joon722/AI-V2X-Cane/arduino/README.md

# Arduino Code Map

Arduino IDE에서 각 폴더를 열어 업로드합니다. 폴더 이름과 `.ino` 파일 이름이 같아야 Arduino 스케치로 인식됩니다.

## car_firmware / cane_firmware

차량·지팡이 노드 펌웨어를 버전별로 모아 둔 폴더입니다(예전 이름 `car_bt_debug`, `cane_bt_debug`).

- `car_firmware`: 차량 ESP32 `car_debug_V2`~`V5`, V5 차량 UWB(Portenta C33 + UWB Shield) `c33_uwb_bridge_V5.ino`
- `cane_firmware`: 지팡이 ESP32 `cane_debug_V2`~`V5`, V5 지팡이 UWB(Arduino Stella) `stella_uwb_responder_V5.ino`
- 한 폴더에 여러 버전이 있으므로, 쓸 `.ino` 하나를 같은 이름의 폴더에 넣어 엽니다(예: `car_debug_V5/car_debug_V5.ino`).
- V5 조립·보정 순서: `V5_BRINGUP_AND_CALIBRATION.md`

## 01_sender_gps_imu_espnow

송신기 ESP32용 코드입니다.

- GPS Neo-6M 데이터 수집
- ICM-20948 IMU 데이터 수집
- ESP-NOW로 수신기 ESP32에 `v2x_message_t` 패킷 송신
- 100ms 주기 송신

## 02_receiver_espnow_uart_actuator

수신기 ESP32용 코드입니다.

- ESP-NOW 패킷 수신
- 수신 데이터를 Jetson UART로 JSON 전달
- risk 값에 따라 진동모터/부저 기본 제어

## 03_sound_udp_receiver

Jetson 위험도 출력 이후 피드백 확인용 코드입니다.

- Wi-Fi 연결
- UDP 포트 `6001`에서 명령 수신
- 명령 예시: `{"risk":2}`
- risk 0: 전체 OFF
- risk 1: 약한 진동
- risk 2: 약한 진동 + 느린 부저
- risk 3: 강한 진동 + 3연속 부저

업로드 전 `config.example.h`를 복사해서 `config.h`를 만들고 Wi-Fi 정보를 입력해야 합니다.

## 99_legacy_originals

정리 전 원본 코드 보관 폴더입니다.

## 99_legacy_tests

초기 테스트 코드 보관 폴더입니다. 일부 파일은 한 파일에 송신기/수신기 코드가 같이 있어 그대로 업로드하면 안 될 수 있습니다.
