joon722/AI-V2X-Cane/docs/작업일지/강현준/2026-07-20_작업정리.md

# 2026-07-20 작업 정리

작성자: 강현준
날짜: 2026-07-20

## 오늘 진행한 작업

### 1. 3단계 — 실제 데이터와 테스트 데이터 출처 구분 (완료)

수집되는 데이터가 실제 장비에서 들어온 것인지 테스트용으로 생성한 것인지 구분되도록 출처 처리를 마무리했다.

### 2. 4단계 — cane / vehicle 최신 상태 저장 (완료)

cane과 vehicle 각각의 최신 상태를 저장하는 기능에 진입해서 완료했다.

### 3. 8단계 risk_level 전송 경로 선행 검증

시스템이 정상 동작하는지 먼저 확인하기 위해 순서를 앞당겨 8단계 전송 경로를 검증했다.

- 검증 결과: RSU/ESP32 방향으로 정상 전송 확인
- 주의: 현재 전송한 risk_level은 **계산된 값이 아니라 수동 입력값**이다. 6~7단계 수식이 정해진 뒤 실제 계산값으로 교체해야 한다.

## 다음 작업

5단계 — test vehicle 생성 및 거리 감소 확인

## 전체 진행 현황

| 단계 | 내용 | 상태 |
|---|---|---|
| 1 | UART/Serial 원본 JSON 정상화 | 완료 |
| 2 | Python 파싱 및 CSV 저장 | 완료 |
| 3 | 실제 데이터와 테스트 데이터 출처 구분 | 완료 |
| 4 | cane/vehicle 최신 상태 저장 | 완료 |
| 5 | test vehicle 생성 및 거리 감소 확인 | 다음 진행 |
| 6 | 거리, TTC, closing speed 계산 | 예정 (수식 미정) |
| 7 | risk score 및 risk_level 수식 적용 | 예정 (수식 미정) |
| 8 | risk_level RSU/ESP32 전송 | 경로 확인 완료, 값은 수동 입력 |
| 9 | 실제 차량 신호로 교체 | 예정 |

## 남은 이슈

- 6단계, 7단계 수식이 아직 정해지지 않음 → 이 두 개가 정해져야 8단계 값이 실제 계산값으로 바뀐다.
- 9단계 실제 차량 신호 교체 전까지는 test vehicle 기반으로 검증한다.
