joon722/AI-V2X-Cane/docs/인수인계/AI_V2X_연결구조_다이어그램_report.pptx

AI-V2X SMART CANE · 연결 구조 한눈에 보기

무엇이 · 어디로 · 어떻게 흘러가는가

하드웨어(RSU·지팡이·차량) · SUMO/AI · 서버(구글 클라우드)
세 세계가 어떻게 이어지는지 다이어그램으로 정리한 인수인계 자료

※ 서버/구글 클라우드 부분은 현재 미구현 — 향후 도입을 위한 제안 설계로 표기했습니다.

## Slide 2

가장 큰 그림 · 이 한 장이 핵심

세 살림을 두 개의 다리로 잇는다

클라우드 · 상시 켜둠 — 위험지도 서버 (FastAPI + SQLite + Leaflet, 이미 구현됨)

이벤트 누적 저장 (SQLite)

도로 구간별 누적 집계

웹 지도 홈페이지 (Leaflet)

이벤트 업로드
(POST /api/events)

SUMO 결과 업로드
(import_sumo_results.py)

현장 하드웨어 · 필요할 때 켬

RSU / Jetson + 지팡이·차량
실시간 위험 경고 (현장에서 즉시)
※ 꺼지면 → 차량↔지팡이
직접통신이 백업 경고

로컬 PC · 가끔

SUMO 시뮬레이션 + AI 학습
→ risk_transformer.onnx 생성
(무거운 계산은 여기서
배치로 한 번씩)

모델(.onnx)
이식 (가끔)

핵심 실시간 위험 판단은 현장에서 즉시(서버 왕복 안 함). 클라우드는 상시 켜두고 기록·지도만 담당. RSU가 꺼져도 직접통신이 백업하고, 지도는 그대로 조회된다.

2

## Slide 3

실시간 하드웨어 · 구성도

차량 · 지팡이 · RSU 가 이렇게 연결된다

차량 노드 (ESP32)

위치·속도·방향을 ESP-NOW로 방송

RSU 브리지 노드

Jetson Nano
distance·TTC·risk 계산

무선 ↔ USB Serial 중계 + 위험도 계산

GPS 모듈
(NEO-6M)

ESP32
(송수신)

DFPlayer
음성(선택)

ESP-NOW

risk 결과

RSU ESP32
무선 수신/송신

지팡이↔차량

지팡이↔RSU

지팡이 노드 (ESP32)

상태 방송 + 위험 경고 수신 → 진동·부저 출력

GPS / IMU

ESP32

진동모터

부저

─── 유선(UART/USB) - - - 무선(ESP-NOW) risk 결과 반환은 초록 경로

3

## Slide 4

실시간 하드웨어 · 데이터 흐름

정보가 한 바퀴 도는 순서

상태 방송

지팡이·차량이
위치·속도를
ESP-NOW로 방송

1

RSU 수집

RSU가 무선 수신
→ USB로 Jetson에
JSON 전달

2

Jetson 판단

거리·TTC·방향으로
risk_level 0~3
계산

3

RSU 중계

risk를 다시
ESP-NOW로 대상
단말에 전송

4

경보 출력

지팡이 진동·부저
(차량 알림은
선택)

5

두 개의 안전 경로 (이중화)
경로 A · 직접 통신 차량↔지팡이가 RSU 없이 바로 주고받아 1차 즉시 경고. (검증 완료)
경로 B · RSU 경유 RSU→Jetson이 정밀 판단으로 확정·보강. 한쪽이 놓쳐도 다른 쪽이 잡는다.

지금 실제로 도는 주력 경로
RSU(ESP32) → Jetson(lux 파이프라인) → 지팡이
위험도는 거리+TTC 규칙으로 즉시 산출. AI 예측·서버 연동은 확장 단계.

4

## Slide 5

RSU 집중 · 왕복 경로

RSU 노드 = 우편함(ESP32) + 두뇌(Jetson)

"RSU" 한 단어에 장치가 둘 — ESP32는 중계만, 판정·AI·max는 같은 박스 안 Jetson이 수행한다

▲ 상행 · 상태 수집

차량(06)
지팡이(09)

ESP-NOW

RSU ESP32(10)
중계만 (검증·통계)

USB JSON

Jetson ★ 두뇌
거리·TTC·AI·max·판정

▼ 하행 · 위험 경고

지팡이 → 진동
차량 → 알림

무슨 데이터를 올리나
type·node_id·lat·lng·speed·heading·node_risk·recv/lost/rssi (JSON 한 줄)

ESP-NOW

RSU ESP32(10)
대상별 분기(중계)

무슨 데이터를 내리나
{target_id: 대상, src_id: 위험차량, risk: 0~3} → 지팡이면 MSG_RISK_ALERT

USB

Jetson ★
판정 결과 {target_id, risk}

핵심 (정정)
RSU ESP32는 중계만, 판정·AI 추론·max는 같은 RSU 노드 안의 Jetson이 수행한다. 즉 위험도 계산의 본진은 현장이다.

5

## Slide 6

RSU 뒤 · Jetson 내부

위험도가 만들어지는 6단계 (lux 파이프라인)

STEP 3

parse_v2x

JSON 파싱
17컬럼 표준화

STEP 4

state_store

최신 상태 보관
쌍 준비 판정

STEP 5

sim_vehicle

(실차 전)
가짜 차량

STEP 6

kinematics

거리·접근속도
TTC·칼만필터

STEP 7

risk_scoring

점수+DCPA
→ risk 0~3

STEP 8

send_risk

RSU로 전송
→ 지팡이

parse → state → (sim) → kinematics → risk → send · 각 단계는 앞 단계의 출력을 입력으로 받는다

입력 (RSU가 준 것)
USB Serial JSON 한 줄 — 차량·지팡이의 위치·속도·방향·seq·통신품질

출력 (지팡이로 보낼 것)
risk_level 0~3 + 근거(reason). 신뢰 낮은 GPS면 경보 억제, 변화 시 즉시 전송.

6

## Slide 7

위험도 로직

거리와 TTC로 risk 0~3 이 정해진다

입력

· 거리 (distance)
· 접근속도
· TTC (충돌예상시간)
· 접근 방향
· DCPA (옆 스침)

판정 규칙

거리<3m 또는 TTC<2s
거리<6m 또는 TTC<4s
거리<12m 또는 TTC<6s
그 외 = 안전
+ DCPA로 오경보 억제

거리<3m / TTC<2s

RISK 3

거리<6m / TTC<4s

RISK 2

거리<12m / TTC<6s

RISK 1

그 외 (안전)

RISK 0

Fire-first (선-발화) 지팡이는 risk 2 이상이면 정밀 판단을 기다리지 않고 즉시 진동한다. 놓치는 것보다 한 번 더 울리는 쪽을 택한다. 최종은 final_risk = max(rule, AI예측, zone, fail-safe) — 가장 높은 위험을 채택.

7

## Slide 8

가장 헷갈리는 부분 풀기

SUMO 결과는 두 갈래로 나간다

① 학습 갈래
AI 학습 → risk_transformer.onnx

현장 (Jetson)
.onnx 탑재 → 실시간 위험 예측

SUMO 시뮬레이션
(로컬 PC)

결과가 아래 두
갈래로 쓰인다

학습용

모델 이식

위험도

② 지도 갈래
구간별 위험도 CSV
(lat·lng·risk·ttc)

※ 둘 다 파일/업로드 — 실시간 통신 아님

업로드

위험지도 서버
지도에 위험구간 표시 (import_sumo_results.py)

정리 SUMO 결과는 ① 학습→모델(.onnx)→현장(실시간 예측), ② 구간 위험도 CSV→위험지도 서버(지도 표시) 두 곳으로. 어느 쪽도 RSU와 실시간 통신하지 않는다.

8

## Slide 9

SUMO · AI 세계 안쪽

시뮬레이션이 AI 학습 데이터가 되기까지

① 학습 갈래 — 이 세로 흐름이 AI 모델을 만든다

실제 도로(OSM)에서 위험 상황을 대량 생성

1

SUMO 시뮬레이션

2

feature.csv (9컬럼)

위치·속도·거리·상대속도 등 원시 피처

3

run_scenario.py

시나리오별 위험도·이벤트 자동 처리(오케스트레이터)

4

event_result.csv (22컬럼)

zone·risk점수·등급·이벤트유형 라벨 부여

5

merge → labeled 데이터셋

모든 시나리오 통합 → 학습 입력 파일

6

train_transformer.py

Transformer 학습 → .pt + scaler.json

7

export_onnx.py

.pt → .onnx (엣지 경량 추론용, Jetson으로 이식)

② 지도 갈래 위 학습과 별개로, SUMO 구간별 위험도(lat·lng·risk·ttc)는 import_sumo_results.py로 위험지도 서버에 직접 업로드되어 지도에 초기 위험구간으로 표시된다.

9

## Slide 10

서버 · 구글 클라우드 (향후 · 제안)

이미 만든 위험지도 앱을 VM 한 대에 올린다

Google Compute Engine — VM 1대 (상시 켜둠)

이미 만든 han/map 앱을 이 서버 하나에 그대로 올림 (Firebase·BigQuery 같은 별도 서비스 없이 단순)

현장

RSU / Jetson
위험 이벤트 발생 시
HTTPS로 업로드

올리는 데이터
lat · lng · risk(0~3) · ttc · timestamp

인터넷

FastAPI (uvicorn)
API + 정적 웹 서빙

SQLite (risk.db)
이벤트 이력 저장

roads.py
OSM 도로 구간 스냅·집계

Leaflet 웹 (risk_map.html)
위험지도 화면

사용자 브라우저 — 위험지도 열람 (GET /api/risk-segments)

10

## Slide 11

서버 · 구글 클라우드 (향후 · 제안)

무슨 데이터를 · 어떻게 주고받나 (실제 API)

① 현장 → 서버 : 위험 이벤트 업로드

POST /api/events
{
"lat": 37.0000, "lng": 127.0000,
"risk": 3,
"ttc": 1.8,
"timestamp": "2026-07-25T14:03:22Z"
}

1

현장에서 전송

Jetson이 위험 이벤트를 HTTPS로 POST

FastAPI 수신·저장

SQLite(risk.db)에 한 줄 기록

2

② 서버 → 지도 : 도로 구간 집계 조회

GET /api/risk-segments
{
"points": [[37.00,127.00],[37.01,127.00]],
"grade": 2, "events": 5,
"avg": 2.4, "ttc": 1.2
}

3

도로 구간 스냅·집계

roads.py가 가까운 도로에 붙여 누적

4

지도가 조회

프론트가 GET으로 받아 도로 색칠

핵심 현장은 짧은 JSON만 올린다. 저장·집계·지도는 서버가 맡는다.

11

## Slide 12

서버 · 구글 클라우드 (향후 · 제안)

홈페이지(위험지도)는 어떻게 뜨나

① SQLite (risk.db)

누적된 위험 이벤트
(lat·lng·risk·ttc·시간)

무슨 데이터로 무슨 화면?
· 이벤트의 위치·등급·TTC를 도로 구간 단위로 누적
· 구간별 이벤트 수·평균 위험도·평균 TTC 자동 집계
· 실시간이 아니라 누적 통계 지도 (건물 아닌 실제 도로에 스냅)

② FastAPI + roads.py

도로 구간에 스냅해
구간별로 집계

③ Leaflet 지도

브라우저에서 도로를
색으로 표시

누적 위험 등급 (지도 색상)

예: 실험 지역 일대 도로 구간 클릭 → 누적 위험 통계 표시

0 · 안전

1 · 주의

2 · 위험

3 · 매우위험

12

## Slide 13

전체 통합

두 개의 다리로 이어지는 전체 그림

클라우드 · 상시 켜둠 — 위험지도 서버

Google Compute Engine VM 1대에 FastAPI + SQLite(risk.db) + roads.py + Leaflet 지도 · 이벤트 누적→도로 구간 집계→웹 지도

이벤트 업로드
(POST /api/events)

SUMO 결과 업로드
(import_sumo_results.py)

현장 하드웨어 (필요할 때 켬)

지팡이·차량 (ESP-NOW)

RSU 브리지

Jetson + .onnx 위험 예측

지팡이 진동·부저

모델(.onnx)
이식

로컬 PC (가끔)

SUMO 시뮬레이션

데이터셋 CSV

Transformer 학습

risk_transformer.onnx

세 살림은 두 개의 다리로만 이어진다 — ① 모델 파일(.onnx) 이식 (로컬→현장), ② 이벤트 로그 업로드 (현장·로컬→클라우드).

13

## Slide 14

정리 · 상태 구분

지금 되는 것 vs 앞으로 붙일 것

✔ 지금 실제로 동작 (검증 완료)
· ESP-NOW 송수신 · RSU 브리지 · Jetson 수신
· lux 파이프라인(parse→…→send) 1~8단계
· 거리·TTC 규칙 기반 실시간 risk 0~3
· Fire-first 즉시 경고 · DCPA 오경보 억제
· SUMO 데이터셋 → Transformer 학습 → ONNX

◷ 앞으로 붙일 것 (확장 · 제안)
· AI(.onnx) 추론을 실시간 파이프라인에 연결
· RSU(10)를 version 2 + distance로 정합
· 좌표계 통일(GPS 위경도 ↔ SUMO 미터)
· 구글 클라우드: API·DB·위험지도 홈페이지
· 9단계: 가짜 차량 → 실차 ESP32 교체

14

## Slide 15

한 장으로 남기는 결론

모델 파일과 이벤트 로그,
이 두 다리를 기억하면 전체가 보인다

SUMO·AI(오프라인) ──.onnx 모델──▶ 하드웨어(현장) ──이벤트 로그──▶ 구글 클라우드(서버·홈페이지)

※ 구글 클라우드 구성은 제안(향후) 설계입니다. 실제 도입 시 서비스 선택은 팀 결정에 따릅니다.
