joon722/AI-V2X-Cane/docs/미팅 내용/4.27 2차 미팅.pdf

한이음 공모전 하이퍼-슝

2026.4.27 | 2차 회의 | 작성자:강현준

오늘 프로젝트의 목표

1. ESP32 환경 설정 및 Blink
2. ICM-20948 IMU 센서 연결 및 검증
3. Neo-6M GPS 연결 및 야외 테스트

팀 역할 분담

강현준,박중선:하드웨어 기본 점검
최민서:SUMO 기본 설정 및 만들기 테스트

이번 팀 미팅에서 한 내용

강현준,박중선:ESP32 환경 설정 및 테스트,ICM 센서 연결 및 검증,Neo-6M GPS 연결 최민서:SUMO 기본 설정 및 만들기 테스트

다음 미팅 계획

https://gemini.google.com/share/fe4b8d04577d
하드웨어: 하드웨어 종합 조립의 시작
통신 시스템: ESP의 서로 통신이 가능하게 점검 및 시작 도로 시스템: SUMO를 이용한 밑작업 및 설정 계획 및 셋팅

다음 팀 모임 일정

5.3(일) 미팅

주의 사항

각장 본인의 역할에 대해서 자세하게 조사해서 오기
