joon722/AI-V2X-Cane/docs/미팅 내용/5.3일 3차 미팅.pdf

## 한이음 공모전 하이퍼-슝

2026.5.3 | 3차 회의 | 작성자:강현준

### 오늘 프로젝트의 목표

## 박중선:개별 테스트한 센서들을 ESP32 하나에 전부 물리적으로 연결하여 하나의 코드에 서 IMU+GPS 데이터가 동시에 나오는 것을 확인

### 강현준:ESP32 2대를 사용하여 ESP-NOW 1:1 통신을 성공 시킨다. 준비물

-생략

## 오늘 결과

박중선:하드웨어 간 연결 및 데이터가 나오는 것을 확인 하였다. 강현준:하드웨어 파트가 연결중 이므로 노말한 ESP끼리 연결을 확인

최민서:SUMO netedit 설치후 숭실대 입구 넣어서 차 돌아다니는 것 성공

## 특이사항

## 장소의 와이파이가 설치하는 것에 문제가 많아 이 부분에 이슈가 많음 그래서 미리 알고 깔아야함

### 다음 팀 모임 계획

5.9일
