joon722/AI-V2X-Cane/data/README.md

# data/ — 현장 실험 원본 기록

이 폴더는 **실제 도로에서 수집한 원본 로그**입니다. 가공하지 않은 raw 데이터라 그대로 보면 숫자 나열이지만,
**무엇을 담고 있고 무엇을 보여주는지**를 아래에 정리했습니다.

> 📊 **이 데이터로 만든 시각화 결과는 [docs/현장 결과](../docs/field-results.ko.md)에서 한눈에 볼 수 있습니다.**
> (실측 접근 타임라인 + 10만 건 거리–위험 분포)

---

## 파일 종류 (공통)

| 파일 | 내용 |
| --- | --- |
| `risk_tx_YYYYMMDD_HHMMSS.csv` | **Jetson이 그 순간 내린 판정 결과.** 거리·TTC·접근속도·위험등급·GPS 유효·모델 확률까지 한 행에. 위 결과 페이지 차트의 원본. |
| `raw_YYYYMMDD_HHMMSS.log` | RSU 브리지가 받은 **원본 시리얼 스트림**(JSON 라인). 지팡이·차량·UWB 패킷 원본. |
| `차량_값기록.csv` · `지팡이_값기록.csv` | 각 노드가 **자체 기록한 원본 값**(듀얼 시리얼 동시 수집). |

---

## 세션별 요약

| 폴더 | 날짜 | 세션 | 무엇을 했나 |
| --- | --- | ---: | --- |
| [`젯슨로그_20260801_03/`](젯슨로그_20260801_03/) | 8/1·8/3 | — | 초기 실험 기록 CSV 6개(`exp_8.1_1차실험`, `exp_8.3_방향성실험` 등). 세션 설명은 아직 없음. |
| [`젯슨로그_20260805/`](젯슨로그_20260805/) | 8/5 | 4 | raw 로그 10개, 판정 CSV 4개. 원본 로그만 있고 세션 설명은 아직 없음. |
| [`젯슨로그_20260808/`](젯슨로그_20260808/) | 8/8 | 3 | raw 로그 6개, 판정 CSV 3개. 원본 로그만 있고 세션 설명은 아직 없음. |
| [`젯슨로그_20260810/`](젯슨로그_20260810/) | 8/10 | — | raw 로그 1개. 원본 로그만 있고 세션 설명은 아직 없음. |
| [`field_20260812_13/`](field_20260812_13/) | 8/12–13 | 15 | 첫 야외 실험. GPS 오차(σ) 실측, 오경보 원인 분석 후 TTC 상한 도입, 판정 주기 5 Hz 확정. |
| [`젯슨로그_20260812/`](젯슨로그_20260812/) | 8/12 | — | raw 로그 19개. `field_20260812_13/`에 없던 나머지 원본. |
| [`젯슨로그_20260813/`](젯슨로그_20260813/) | 8/13 | — | raw 로그 9개. `field_20260812_13/`에 없던 나머지 원본. |
| [`젯슨로그_20260814/`](젯슨로그_20260814/) | 8/14 | 3 | raw 로그 7개, 판정 CSV 3개. 원본 로그만 있고 세션 설명은 아직 없음. |
| [`젯슨로그_20260817/`](젯슨로그_20260817/) | 8/17 | 12 | 촬영일 + 오후 정밀 실험. **이 결과 페이지의 히어로 접근 이벤트가 이 폴더의 12:22 세션.** 판정불가 원인(차량 GPS 모션무효·재획득 점프)을 찾아 게이트 패치. |
| [`젯슨로그_20260818/`](젯슨로그_20260818/) | 8/18 | 4 | 대본 기반 5구간 실험. 접근 3/3 정상 상승(L1→L2→L3), 도플러 클램프 도입. |
| [`젯슨로그_20260819/`](젯슨로그_20260819/) | 8/19 | 5 | **코너 테스트 2회 성공.** RSSI×GPS 방향 융합 도입, 사각지대 접근에서 RSU 융합이 GPS 공백을 메움. |
| [`젯슨로그_20260820/`](젯슨로그_20260820/) | 8/20 | 10 | GPS 공백 유지(GAP_HOLD) 다운링크, 지팡이 GPS 콜드스타트 특성 확인. |
| [`젯슨로그_20260822/`](젯슨로그_20260822/) | 8/22 | — | UWB(DWM3001CDK) 통합 시작. |
| [`젯슨로그_20260825/`](젯슨로그_20260825/) | 8/25 | 4 | **UWB 야외 첫 성공.** 지팡이 GPS가 안 잡힌 세션에서 UWB가 판정을 100 % 대신 살림. AI 12k 모델 재학습. |
| [`젯슨로그_20260826/`](젯슨로그_20260826/) | 8/26 | 2 | raw 로그 5개, 판정 CSV 2개. 원본 로그만 있고 세션 설명은 아직 없음. |
| [`젯슨로그_20260827/`](젯슨로그_20260827/) | 8/27 | 3 | raw 로그 13개, 판정 CSV 3개. 원본 로그만 있고 세션 설명은 아직 없음. |
| [`젯슨로그_20260919/`](젯슨로그_20260919/) | 9/19 | 1 | **입력 끊김·복구 통제 실험.** 차량 노드의 GPS 가림·전원 재시작·통신 가림과 접근 주행. 조작 시각 마커(`markers_*.csv`) 포함. 자세한 내용은 폴더 README. |
| [`듀얼시리얼기록/`](듀얼시리얼기록/) | 8/1~9/19 | 118 | **라벨된 시나리오 녹화 118종** — `10m접근1`, `0.3m정지`, `1m정지`처럼 거리·동작을 이름에 붙인 통제 실험. 노드 원본 값(듀얼 시리얼)이라 알고리즘 튜닝·검증용. 9/19 세션의 `*_raw.log`는 용량(최대 52 MB) 때문에 `.log.gz`로 압축해 올렸고, 같은 값이 `*_값기록.csv`에도 있습니다. |

> 세션 수 = 각 폴더의 `risk_tx_*.csv` 개수(= Jetson 판정 세션). 일부 폴더는 raw 로그·노드 기록만 있습니다. 내용이 없는 0바이트 로그 파일은 올리지 않았습니다.

---

## 다시 그리기

같은 CSV로 결과 페이지의 그림을 재생성할 수 있습니다:

```bash
python scripts/figures/make_figures.py
```

> ⚠️ 이 로그의 GPS 좌표는 실험 장소의 위치를 담고 있습니다. 개인 식별 정보는 없습니다.
