joon722/AI-V2X-Cane/docs/README.md

[← 프로젝트 개요](../README.ko.md)

# docs — 문서 아카이브

프로젝트의 기술 보고·설계 문서를 모아 둔 곳입니다. 코드가 아니라 **"왜·어떻게 이 프로젝트를 진행했는지"**의 기록입니다.

## 바로 보면 좋은 것

| 문서 | 내용 |
| --- | --- |
| 📊 [현장 결과 (field-results.ko.md)](field-results.ko.md) | **실측 데이터 시각화** — 접근 타임라인, 거리별 위험 분포 10만 건 |
| [SETUP.ko.md](SETUP.ko.md) | 펌웨어 업로드 순서·Wi-Fi 설정·핀맵 |
| [코드_검증_정리.md](코드_검증_정리.md) | 코드 검증 메모 |

## 기술 보고

- `위험채점표_Transformer모델_설명.pdf` — 위험 점수표와 Transformer 모델 설명
- `TTC_연구_논문.pdf` — 충돌예상시간(TTC) 임계값 연구
- `DCPA게이트_적용결과_공유.pdf` — DCPA 게이트 적용 결과
- `확장_위험점수체계.png` — 확장 위험 점수 체계도

## 구조 설명

| 폴더 | 내용 |
| --- | --- |
| [인수인계/](인수인계/) | 연결 구조 다이어그램 |

## 개발 설계 노트

| 폴더 | 내용 |
| --- | --- |
| [superpowers/](superpowers/) | 개발 당시 작성한 설계 스펙·계획 (위험 융합, step7 채점, step8 전송) |
| [images/](images/) | 실물 사진·현장 데모·결과 차트 |
