joon722/AI-V2X-Cane/data/field_20260812_13/README.md

# 야외 실측 데이터 (2026-08-12 저녁 ~ 08-13 오전)

야외 실험. 지팡이 고정 + RC 차량 왕복/접근. 젯슨(RSU 엔진 step8)이 기록한
판정 CSV(`risk_tx_*.csv`)와 원시 시리얼 로그(`raw_*.log.gz`, gzip).

- 8/12 = **수정 전** (TTC 상한 없음, "10m 이내 30점" 규칙으로 오경보 93%)
- 8/13 = **수정 후** (TTC 30초 상한 + 안전하한 2.0초 배포, 지팡이 RSU 수신 복구)

노드측 기록(지팡이/차량 UDP 텔레메트리)은 팀 GCS 버킷(`듀얼시리얼기록/`)에 별도 보관.

## 파일 형식

- `risk_tx_*.csv`: 판정 1행 = 1판정. `pc_time`은 유닉스 epoch(KST 벽시계와 일치).
  주요 컬럼: `effective_level`(송신 레벨), `rule_level`/`rule_reason`(규칙 판정,
  8/13부터 `ttc_capped` 등장), `distance_m`/`closing_mps`/`ttc_s`, `cane_node_risk`/
  `veh_node_risk`(노드가 방송한 최종위험 — 다운링크 반영 확인용), 양 노드 GPS 상태.
- `raw_*.log.gz`: `시각 RX/TX 원문` 형식. RX는 노드 업링크 JSON(위치·속도·heading_valid
  포함), TX는 젯슨 위험도 송신. 파일명 타임스탬프가 짝이 되는 CSV와 같음.

## 세션 목록

| 파일 (시각) | 내용 | 핵심 결과 |
|---|---|---|
| 8/12 19:32~22:18 (risk_tx 10개) | 수정 전 왕복/평행 실험 | 판정 3,570건 중 경보 82%, 그중 78%가 접근 없음(TTC 9999/30s+) — 오경보 원인 실측 |
| `..._203823` (20:38~21:14) | 수정 전 최대 세션 | 판정 1,082건/경보 1,004건(93%). 지팡이 다운링크 반영 90% |
| `..._213246` (21:32~22:05) | patch 펌웨어 세션 | 반영률 76% |
| `..._220647` (22:06~22:18) | patch2 펌웨어 세션 | **지팡이 반영률 1%** — patch2가 RSU 입력을 껐던 증거 |
| 8/13 `..._081033` (08:10~08:32) | 수정 후 실내외 검증 | 정지 근접(2~10m)에서 경보 억제(ttc_capped), 접근 시 1→2→3 에스컬레이션(08:15:33), 지팡이 반영률 75% 복구 |
| 8/13 `..._083827` (08:40~09:11) | 수정 후 현장 런 | 08:41~44 접근/이탈 정상 판정. **08:45~ 차량 GPS 모션 정지**(속도 0.02 고착) 및 09:04~ 지팡이 GPS 배회(상대 오프셋 10→20m) — GPS 병목 실측 |

## 재현/분석 참고

- 코드 기준 커밋: TTC 상한 `rsu@5d2648d`, 도플러 융합 `rsu@721548d` (이 저장소는 `rsu/v2x/` 하위 동일본)
- raw 로그를 파이프라인에 재생하면 판정을 재현할 수 있음. 단 **재생 시각 왜곡 주의**:
  pc_time 기반 속도 계산이 있으므로 원본 타임스탬프를 사용할 것.
- 분석 정리본: 팀 공유 문서 `실험정리_20260813.pdf` 참조.
