joon722/AI-V2X-Cane/data/젯슨로그_20260919/README.md

# 입력 끊김·복구 통제 실험 (2026-09-19 12:14~13:06)

차량 노드의 입력을 일부러 끊었다 되살리면서, 복구 직후 판정 파이프라인이 어떻게 반응하는지 기록한 세션입니다.
노드 두 대는 5 m 간격으로 고정했고, 조작은 차량 노드에만 했습니다. 지팡이 노드는 비교 기준으로 그대로 두었습니다.

## 파일

| 파일 | 내용 | SHA-256 |
| --- | --- | --- |
| `raw_20260919_095416.log` | 젯슨(RSU 엔진 step8)이 받은 원본 시리얼 스트림. 기록은 09:54에 시작했고 실험 구간은 12:14~13:06 | `197a2e9c…685d96` |
| `risk_tx_20260919_095416.csv` | 같은 세션의 실시간 판정 결과 | `2c86eaa0…f34460` |
| `markers_20260919_121439.csv` | 실험자가 조작 순간마다 노트북에 남긴 시각 표시(`epoch, local_time, label`) | `59bd02b7…4dbfc` |

노드 쪽 원본 값(위성 수, HDOP, 원시 좌표, IMU 포함)은 같은 시간대에 따로 녹화되어
[`../듀얼시리얼기록/20260919_S01_RSU_RAW_CONTINUOUS_2H.log_2026-09-19_12-21-12/`](../듀얼시리얼기록/20260919_S01_RSU_RAW_CONTINUOUS_2H.log_2026-09-19_12-21-12/)에 있습니다.
원본은 팀 GCS 버킷(`듀얼시리얼기록/`)에도 있습니다.

## 시계

- 젯슨 시계는 정확했습니다(`raw` 로그의 epoch = KST 벽시계).
- 마커는 **노트북** 시계로 찍었습니다. 로그의 사건(전원 재시작 때 차량 노드의 millis가 0으로 돌아가는 시각, 통신 가림 때 RSSI가 꺾이는 시각)과 맞춰 보면 마커는 약 1초 늦게 찍혔습니다(중앙값 +1.0~1.3초, 누르는 반응 지연 포함). 현장에서 잰 "약 4초"는 두 명령을 차례로 실행하면서 생긴 측정 오차였습니다.
- 노드 시리얼 기록(`../듀얼시리얼기록/20260919_…`)은 노드 millis(`시각ms`)가 raw 로그 패킷의 `tx_ms`와 같은 카운터라서 수 ms 오차로 정확히 맞출 수 있습니다.

## 실험 구간과 마커

| 시각(노트북) | 블록 | 마커 | 한 일 |
| --- | --- | --- | --- |
| 12:15~12:22 | 정지 기준 | `> n A시작`, `n A끝` | 5 m 간격으로 7분 방치. 첫 줄의 `>`는 입력 실수 |
| 12:24~12:30 | GPS 가림 | `gs v` → `ge` | 차량 GPS 안테나에 알루미늄 원통+호일을 씌웠다 벗김. 5·20·60초 |
| 12:31~12:39 | 전원 재시작 | `rs v`, `re` | 차량 노드 전원을 뽑았다 꽂음, 6회. 로그상 차량 노드는 매번 28~31초 동안 사라졌다가 `seq=0`으로 돌아옴 |
| 12:41~12:44 | 통신 가림 | `cs v` → `ce` | 차량 노드 몸체(ESP32)를 호일로 감쌈. 5·20초 |
| 12:57~13:03 | 접근 주행 | `n 1`, `n 2`, `x` | 차량이 지팡이 옆을 지나감. `x` = 가장 가까이 지나간 순간 |

## 해석할 때 주의할 점

- **GPS 가림으로 유효 플래그는 떨어지지 않았습니다.** 좌표와 보고 속도는 흔들렸지만 `gps_valid`는 계속 1이었습니다. "끊김"이 아니라 "플래그에 안 잡히는 열화" 사건으로 다뤄야 합니다.
  - 12:24:19와 12:24:25의 `gs v`는 중복 입력입니다. 앞의 것은 무시합니다.
  - 12:28:36의 `gs v`에는 짝이 되는 `ge`가 없습니다.
- **통신 가림으로 링크는 끊기지 않았습니다.** 6회 모두 수신이 초당 6.2~8.9개로 유지됐고(직전 7.7~9.5개), RSSI만 1~17 dB 낮아졌습니다. 최대 수신 공백은 0.62초였습니다.
- **전원 재시작의 마커 순서가 안내와 반대입니다.** `rs v`는 전원을 **꽂은** 순간에, `re`는 꽂은 뒤 약 60초 휴지가 끝난 순간에 찍었습니다. 로그에서 차량 노드는 매번 28~31초 동안 사라졌다가 `seq=0`으로 돌아옵니다. 꺼진 시각과 켜진 시각은 마커보다 로그의 수신 공백을 기준으로 보는 것이 정확합니다.
- **접근 주행의 `n 1`/`n 2` 구분**
  - 로그상 9회 어느 회차에서도 차량 노드 재부팅은 없었습니다(최대 수신 공백 0.93초, 순번 초기화 없음).
  - `n 2` 다섯 번 중 두 번은 출발 직전에 차량 GPS 무효가 1~2초 있었고, 나머지 세 번은 로그에 흔적이 없습니다. `n 2`가 무엇을 뜻하는지는 실험자 확인이 필요합니다.
  - 이 구간에는 지팡이 노드 수신이 매우 나빴습니다(초당 0.3~2.7개, 최대 11초 공백).
  - `x`는 로그상 최근접 시각과 −9~+9.5초 차이가 나서 시각 동기화 기준으로 쓰지 않습니다.
- 13:04:40과 13:05:14의 `n`은 마무리 단계(두 노드를 나란히 두기)의 표시입니다.
