joon722/AI-V2X-Cane/docs/작업일지/README.md

# 작업일지

팀원별로 폴더를 나눠서 각자 진행한 작업을 날짜별로 기록합니다.

```text
docs/작업일지/
├── 강현준/
├── 최민서/
└── 박중선/
```

파일 이름 규칙: `YYYY-MM-DD_작업정리.md`
