joon722/AI-V2X-Cane/docs/작업일지/강현준/README.md

# 강현준 작업일지

이 폴더에 본인이 진행한 작업을 날짜별로 기록합니다.

## 파일 이름 규칙

```text
YYYY-MM-DD_작업정리.md
```

예: `2026-07-20_작업정리.md`

## 작성 항목

- 오늘 진행한 작업
- 다음 작업
- 전체 진행 현황
- 남은 이슈
