joon722/AI-V2X-Cane/AI_Model/transformer/models_v5/training_report_v3.txt

target: risk_level_future3 (3s lookahead)
features(20)
train 329,455 / test 75,341 (scenario split 45)

              precision    recall  f1-score   support

         안전0     0.9728    0.8268    0.8939     60000
         주의1     0.4672    0.6095    0.5290      9874
         경고2     0.3280    0.5788    0.4187      4065
         위험3     0.2645    0.8103    0.3988      1402

    accuracy                         0.7846     75341
   macro avg     0.5081    0.7063    0.5601     75341
weighted avg     0.8586    0.7846    0.8112     75341

[[49606  6185  2630  1579]
 [ 1186  6018  1958   712]
 [  180   664  2353   868]
 [   20    13   233  1136]]
ONNX diff 2.38e-06
