joon722/AI-V2X-Cane/docs/작업일지/최민서/2026-07-20_작업정리.md

# 2026-07-20 작업 정리

작성자: 최민서
날짜: 2026-07-20

## 오늘 할 일

- [x] 여러 위험 시나리오 생성 (현재 시나리오 부족)
- [ ] 자동화 스크립트 구성

자동화 스크립트 파이프라인:

```text
SUMO
  -> feature 생성      [완료]
  -> Risk 계산
  -> Event 분석
  -> 저장
```

## 남은 일

| 항목 | 상태 |
|---|---|
| 1. 위험 데이터 자동 누적 | 60% 진행 |
| 2. XGBoost 학습 데이터 제작 | 시작 전 |
| 3. XGBoost 모델 학습 | 시작 전 |
| 4. Transformer 적용 | 시작 전 |
| 5. ESP32 연동 | 시작 전 |

## 메모

- 현재 시나리오 수가 부족해서 위험 시나리오를 추가 생성하는 것이 선행 과제다.
- 자동화 스크립트는 feature 생성까지 진행됐고, Risk 계산부터가 남았다.
