joon722/AI-V2X-Cane/rsu/v2x/03_jetson/ttc_study/ROADSIDE_ALARM.md

# 도로변 경보 — 인도를 걸을 때 울리는 문제

작성 2026-08-07 · 8/9 논의 자료 · 근거 재현: `floor_dcpa_sweep.py`

## 0. 한 장 요약

팀 대화에서 나온 질문: **"인도를 걷는데 옆 차도로 차가 지나가면 울리나?"**

답: **울린다. 횡방향으로 7m 떨어져 있어도 최고 레벨이 나간다.**

| 확인한 것 | 결과 |
|---|---|
| 인도 보행 중 통과 차량 | 이격 3·5·7m 모두 레벨 3 (안전 하한 발동) |
| 하한을 DCPA 조건부로 (R=6m) | 오경보 −1.0%p, **놓침 3.8개 증가** (σ=2.5 기준) |
| 같은 변경, GPS σ만 1.5m로 | **놓침 0.4개**로 떨어짐 |
| GPS만 개선했을 때 | 적시경보 73.2% → 88.2% (**+15%p**) |
| GPS가 오경보에 미치는 영향 | **없음** (3.42 / 3.43 / 3.42 / 3.41%) |

**결론 두 줄.**
놓침은 GPS가 지배하고, 오경보는 판정 구조가 지배한다. 두 문제는 별개이며
서로의 해법으로 풀리지 않는다.

같은 날 함께 확인한 것들.

| 질문 | 답 | 절 |
|---|---|---|
| AI 이득이 GPS에 의존하는가 | **의존한다.** +18.9 → +14.9 → +9.5%p. 다만 사라지지 않고 승률은 오름 | 10 |
| 상용화·소형화가 가능한가 | 연산·배터리는 문제없다. **진짜 제약은 GPS 안테나 크기** | 11 |
| 위험지도에 문제가 있는가 | **있다.** 초록이 없는 것은 증상이고, 진짜 문제는 **변별력**이다 | 12 |
| 그 지도는 무엇인가 | 차량용도 보행자용도 아닌 **상충 지도** — 행정 의사결정 지원 | 12 |

---

## 1. 무엇을 묻게 되었나

위험지도를 보던 중 팀에서 나온 질문들이다.

> 안전한 구간은 어디 있는 건가요 / 차도는 다 위험하지
> 보행자가 보차 혼용도로 갈 때는?
> 인도랑 차도가 완전히 분리되어 있으면 굳이 울릴 필요는 없잖아
> 처음 생각한 건 차도로 안 들어가게 하자였는데 솔직히 잘 모르겠어

두 개의 다른 문제가 섞여 있었다.

| | 문제 | 소관 |
|---|---|---|
| A | 위험지도에 안전(0단계) 구간이 안 보인다 | 지도 — 별개 문제 |
| B | **인도 보행 중 통과 차량에 경보가 나가는가** | 실시간 경보 — 이 문서 |

이 문서는 B만 다룬다. A는 "이 지도가 차량용인가 보행자용인가"를 먼저 정해야
하는 문제이고, 8/9에 지도 담당과 따로 논의한다.

### 보호 대상 우선순위 (8/7 확인)

1. **충돌 경보** — 특히 운전자가 보지 못하는 곳에서 갑자기 나오는 상황
2. 횡단보도·보차혼용 구간
3. ~~차도 이탈 방지~~ — 시각장애인은 훈련되어 있고 단차가 있어 우선순위 낮음

1번이 핵심이라는 점이 설계 방향을 바꾼다. 시야가 트인 곳은 운전자가 알아서
피하므로, V2X가 유일하게 값을 하는 자리는 **서로 못 보는 상황**이다.

---

## 2. 진단 — 실제로 울리는지 계산했다

보행자가 북쪽으로 1.2 m/s, 차량이 옆 차도를 같은 방향 40 km/h로 뒤에서 접근하는
상황을 `step7_risk.assess_risk`에 그대로 넣었다.

| 횡방향 이격 | 뒤 20 m | 뒤 15 m | 뒤 10 m |
|---|---|---|---|
| 3 m (좁은 인도) | 레벨 2 | **레벨 3** | **레벨 3** |
| 5 m | 레벨 1 | **레벨 3** | **레벨 3** |
| 7 m (넓은 인도+갓길) | 레벨 0 | **레벨 3** | **레벨 3** |

이격 7m에서 점수는 19.3점(레벨 0 상당)인데 레벨 3이 나간다.

### 왜 그런가

원인이 둘이다.

**첫째, TTC를 잘못된 자리에 쓰고 있다.**

    TTC = 거리 / LOS 접근속도

이 값은 **정면 충돌 코스를 가정한 지표**다. 옆으로 스쳐 갈 차에도 작게 나온다.
실제 충돌 여부를 재는 것은 TTC가 아니라 DCPA(얼마나 가까이 스치나)와
TCPA(언제)의 쌍이고, step6이 그것을 이미 정확히 계산한다.

**둘째, 안전 하한이 DCPA 게이트를 의도적으로 무시한다** (`step7_risk.py:198`).

그 결정에는 근거가 있었다 — "게이트는 스쳐 갈 차를 걸러내는 장치인데 그 판단
자체가 추정이고, 접촉까지 2초도 남지 않았을 때 추정이 틀리면 대가가 너무 크다."
논리는 타당하다. 다만 그 대가를 **차 한 대가 지나갈 때마다 약 2초씩 최고 경보**로
치르고 있다는 점이 그때는 보이지 않았다.

**결과적으로 이격 거리를 정확히 알아도 소용이 없다.** 3m든 7m든 하한이 모두
덮어버리기 때문이다. 그래서 첫 검토 대상은 지도 정교화가 아니라 하한 자체였다.

---

## 3. 무엇을 쟀나

하한 발동 조건을 바꿨을 때의 손익을 오라클로 측정했다.

    현재:   경보 = (점수표레벨 >= 2)  OR  (TTC <= 2.0)
    조건화: 경보 = (점수표레벨 >= 2)  OR  (TTC <= 2.0 AND dcpa < R)

R을 2~8m로 스윕하고, GPS σ를 2.5 / 2.0 / 1.5 / 1.0m로 바꿔가며 반복했다.
채점은 `ttc_study`의 오라클 그대로다 — 규칙과 독립인 정답이므로 순환 논리가
되지 않는다.

지표를 셋 본다.

| 지표 | 무엇을 답하나 |
|---|---|
| 적시경보율 | 위험 시나리오에서 반응 가능할 만큼 미리 울렸나 |
| 오경보율 | 안전한 시점에 울렸나 |
| **확실안전 구간 경보율** | 3초 안에 4m보다 가까워지지 않는 시점에 울렸나 |

세 번째는 이번에 추가한 지표다. **인도 옆을 스쳐 가는 차가 여기 해당하므로,
팀이 걱정한 오경보에 가장 가깝다.**

    python floor_dcpa_sweep.py --n-scenarios 1200 --repeats 5 --gps-sigma-m 2.5

---

## 4. 결과 1 — 조건화는 공짜가 아니다 (σ = 2.5m)

| R (m) | 적시경보 | 오경보율 | 확실안전 경보 | 검출 |
|---|---|---|---|---|
| **무한 (현재)** | 73.2% ±4.1 | 3.42% | 2.79% | 94.6 / 97.2 |
| 8 | 72.8% (−0.4%p) | 2.74% | 2.12% | 93.2 |
| **6** | 71.5% (−1.7%p) | 2.40% | 1.83% | 90.8 |
| 5 | 69.9% (−3.3%p) | 2.21% | 1.68% | 88.8 |
| 4 이하 | 69.7% (−3.5%p) | 2.18% | 1.65% | 88.4 |

R=6이면 오경보를 30% 줄이는 대신 **위험 시나리오를 3.8개 더 놓친다.**
시각장애인 안전 시스템에서 놓침 1개와 오경보 1%는 값이 다르므로, 이 교환은
그 자체로는 손해다.

부수적으로 확인된 것 둘.

- **R을 2~4 사이에서 조정하는 것은 의미가 없다.** 네 값의 결과가 소수점까지
  같다. 하한이 추가로 잡는 시점들의 DCPA가 그 구간에 없다는 뜻이다.
- **하한만 고쳐도 인도 오경보의 절반만 사라진다.** 확실안전 경보가 2.79%에서
  1.83%로 줄 뿐 0이 되지 않는다. 남은 1.83%는 점수표가 내는 것이다.

---

## 5. 결과 2 — GPS 정밀도가 이 교환의 조건을 바꾼다

같은 측정을 σ만 바꿔 반복했다. R=6 기준이다.

| GPS σ | 현재 적시경보 | 현재 검출 | R=6 손실 | R=6 검출 | **추가 놓침** |
|---|---|---|---|---|---|
| 4.0 m (도심 비관) | 60.1% | 89.2 / 97.2 | −4.3%p | 79.0 | **10.2개** |
| 2.5 m (현 가정) | 73.2% | 94.6 | −1.7%p | 90.8 | **3.8개** |
| 2.0 m | 76.5% | 95.8 | −1.0%p | 93.4 | **2.4개** |
| **1.5 m** | 82.2% | 96.4 | −0.6%p | 96.0 | **0.4개** |
| 1.0 m | 88.2% | 97.2 | −0.2%p | 97.2 | **0개** |

**경계선은 σ = 1.5m다.** 그 아래면 하한 조건화가 사실상 공짜가 되고, 2.0m를
넘으면 놓침을 사는 거래가 된다.

σ=4.0m 행을 넣은 이유는 CEP 2.5m가 **개활지 사양**이기 때문이다. 건물 사이
다중경로에서는 그보다 나빠지며, 실측이 4m로 나오면 하한 조건화는 논외가 된다
(놓침 10개). 실측값이 이 표의 어느 행에 떨어지는지가 결정을 좌우한다.

### GPS 자체의 효과가 더 크다

표의 왼쪽 열만 세로로 보면 조건화와 무관한 사실이 나온다.

| σ | 적시경보 | 현 가정 대비 |
|---|---|---|
| 2.5 m | 73.2% | — |
| 2.0 m | 76.5% | +3.3%p |
| 1.5 m | 82.2% | +9.0%p |
| 1.0 m | 88.2% | **+15.0%p** |

AI 모델의 이득이 +18.9%p였다. **GPS 정밀도는 그와 맞먹는 크기의 개선이며,
재학습도 모델 통합 논의도 필요하지 않다.**

수익이 비선형이라는 점도 중요하다. 2.5→2.0은 +3.3%p인데 1.5→1.0은 +6.0%p다.
좋아질수록 더 많이 얻으므로, 중간에서 멈추는 것이 가장 비효율적이다.

---

## 6. 결과 3 — 두 축은 분리되어 있다

네 조건의 오경보율이 **3.42 / 3.43 / 3.42 / 3.41%**로 소수점까지 움직이지 않았다.

| | 지배 요인 | 고치는 방법 |
|---|---|---|
| **놓침** (위험을 못 잡음) | GPS 정밀도 | 안테나·갱신주기·필터 |
| **오경보** (인도에서 울림) | 판정 구조 | 점수표·하한·새 피처 |

**인도 오경보는 GPS를 고쳐도 사라지지 않는다.** 반대로 놓침은 판정 구조를
만져도 나아지지 않는다. 지금까지 두 문제를 한 덩어리로 다뤘으나 별개다.

이 분리가 이 문서에서 가장 실무적으로 유용한 결과다. 담당과 일정을 나눌 수 있다.

---

## 7. 그래서 무엇을 할 것인가

### 순서

| # | 할 일 | 판정 기준 | 시점 |
|---|---|---|---|
| 1 | **GPS 수신기 설정 확인** (아래) | 설정값 확인 | **실험 전** |
| 2 | **정지 5분 로깅으로 σ 실측** | 표준편차 값 하나 | 실험일 최우선 |
| 3 | 스쳐 지나감(D) 시나리오를 필수로 승격 | 오경보 실측 건수 | 실험 |
| 4 | 차폐 RSSI A/B 측정 | 감쇠가 산포의 2배 이상인가 | 실험 |
| 5 | σ ≤ 1.5 이면 R=6 조건화 채택 | 오라클 재측정으로 확인 | 실험 후 |
| 6 | σ > 2.0 이면 하한 보류, GPS 우선 | — | 실험 후 |

3·4번은 `EXPERIMENT_PLAN.md`에 반영했다.

5번은 유일하게 조심할 자리다. 기존 설계 결정을 뒤집는 것이므로 실측 σ로 다시
측정한 뒤 결정한다.

### 1번을 앞에 둔 이유 — 코드가 아니라 설정이다

σ가 지배 변수인데(6절), 부품을 바꾸지 않고 설정만으로 개선될 여지가 남아 있을 수
있다. 실측 **전에** 확인해야 실측값 자체가 좋아진다.

| 확인 항목 | 왜 |
|---|---|
| **SBAS 활성화 여부** | NEO-6M도 SBAS를 지원한다. 기본으로 꺼져 있을 수 있다 |
| **dynamic platform model** | 기본이 Portable이다. Pedestrian으로 두면 보행 속도에 맞춰 필터가 조정된다 |
| 갱신 주기 | 5Hz 반영 확인 (기존 항목) |
| 안테나·배치 | 기본 세라믹 패치인지, 몸에 가려지는 위치인지 |

**국내 SBAS 수신 가능 여부와 실제 개선 폭은 확인되지 않았다.** u-center로 현재
설정을 읽고 위성 수·HDOP를 비교하는 것이 가장 빠르다. 하드웨어 담당 영역이다.

### 코드 변경 — 실험 전에 손댈 것이 없다

| 파일 | 변경 | 위험 | 조건 |
|---|---|---|---|
| `EXPERIMENT_PLAN.md` | D 필수 승격, σ·차폐 측정 추가 | 없음 | **완료 (8/7)** |
| `step7_risk.py` | 하한에 dcpa 조건 추가, 플래그로 on/off | **중간** | σ ≤ 1.5 확인 후 |
| `model_gate.py` | NLOS 게이트 = max 4번째 항 | 낮음 | 차폐 임계값 확정 후 |
| `step8_send_risk.py` | zone_base_risk 배관 | 없음 (값 0) | 12절 — 값 주입은 보류 |

**rssi·lost_count는 이미 흐르고 있다.** `step3_parse_v2x.normalize_record`가
`CSV_FIELDS` 전체를 row로 만들고(`step3_parse_v2x.py:68`), `StateStore.update`가
그 row를 통째로 보관한다(`step4_state_store.py:44`). NLOS 게이트를 붙일 때
`store.latest[...]["rssi"]`로 꺼내 쓰면 되고, 실험 raw 로그에도 원본 JSON이
그대로 남으므로 데이터 확보도 이미 되어 있다.

즉 **실험 전에 필요한 것은 코드가 아니라 측정 절차와 수신기 설정이다.**

### 실험 계획에 추가할 것

`EXPERIMENT_PLAN.md`에 D(스쳐 지나감 5~10m)와 E(접근하다 정지)가 이미 있으나
**"여유가 있으면 추가"로 되어 있다.** A·B·C는 위험을 잡는지를 보고, D만이
울리지 않아야 할 때 조용한지를 본다. 필수로 올려야 한다.

D는 현재 노드를 고정한 정적 시나리오다. 팀이 걱정한 것은 보행자도 이동 중인
상황이므로, 계획서의 안전 규정("노드를 실은 카트를 줄로 끌어 움직인다")을
이용해 평행 이동을 만든다.

**차폐 A/B 측정이 계획에 없다.** 8절 참조.

---

## 8. 다음 축 — 운전자가 보지 못하는 상황

보호 대상 1순위가 "운전자가 못 보는 곳에서의 충돌"인데, 현재 시스템에는
**가시성이라는 개념이 없다.** `model_features.py`의 피처 15개는 전부 상대
운동학이라, 골목에서 튀어나온 차와 인도 옆을 스쳐 가는 차가 같은 점수를 받는다.

### 벽을 모델링하는 방법은 쓰지 않는다

- OSM에 건물은 있어도 **주차 차량·가로수·화단·입간판이 없다.** 실제 사각의
  대부분이 그것이다.
- 레이캐스팅에는 정확한 위치가 필요한데 σ 2.5m면 벽 앞뒤 판정 자체가 흔들린다.
- 기하가 맞아도 운전자가 실제로 봤는지는 알 수 없다.

### 대신 흔적으로 잡는다

필요한 것은 시야각이 아니라 **"사각 상황인가"라는 이진 판정 하나**이고, 그것은
이미 들어오는 데이터에 흔적이 있다.

| 신호 | 어디 있나 | 무엇을 말하나 |
|---|---|---|
| `rssi` | 모든 V2X 패킷 | 사이에 무엇이 있으면 낮아진다 |
| `lost_count` | 모든 V2X 패킷 | NLOS면 손실이 증가한다 |
| 링크 생성 시점 | `state_store` | 가까운데 방금 잡혔다 = 방금까지 안 보였다 |
| 교차 기하 | `d_heading_dt` (기존 피처) | 직교 접근 = 코너 |

`step3_parse_v2x.py`가 앞의 둘을 **이미 파싱해 통과시키고 있다.** 추가 하드웨어도
지도도 필요 없다.

### 현재 데이터로는 아직 판단할 수 없다

| 로그 | n | 중앙값 | 범위 |
|---|---|---|---|
| `rssi_1m.log` | 83 | −64 dBm | −66 ~ −59 |
| `rssi_3m.log` | 94 | −39 dBm | −40 ~ −36 |

3배 먼 쪽이 25 dB **더 강하다.** 자유공간이면 반대로 9 dB 약해져야 한다.
두 로그의 송신 출력이나 안테나 조건이 서로 달랐다는 뜻이므로, 거리 라벨만 믿고
비교할 수 없다.

**다만 각 로그 내부의 산포가 4~7 dB로 작다.** 차폐 감쇠는 통상 10~20 dB이므로
조건만 통제하면 판별 가능성이 있다.

### 측정 방법

**같은 자리, 같은 세션에서 차폐물만 바꾼다.** 30초 LOS → 30초 차폐 → 30초 LOS로
번갈아 찍는다. 서로 다른 날의 로그를 비교하면 위 표와 같은 실패가 반복된다.

차폐물 3종: 벽(건물 모서리) / 주차 차량 / 사람 몸.

**차량이 필요 없고 30분이면 된다.** 기존 `rssi_3m.log`도 `speed_mps: 0.000`인
정적 측정이었다.

### 쓰는 방법 — 한 방향으로만

| 판정 | 허용 |
|---|---|
| NLOS 같다 → 더 일찍 울린다 | 가능 |
| LOS 같다 → 울리지 않아도 된다 | **금지** |

신호가 틀려도 지금보다 나빠지지 않게 하기 위해서다. 기존 3층 구조(하한·규칙·AI의
max 결합)와 같은 철학이므로, `model_gate.py`에 네 번째 항으로 붙인다.

    최종 = max( 안전하한, 규칙 점수표, AI 판정, NLOS 게이트 )

**모델 피처로는 넣을 수 없다.** 학습 데이터가 시뮬레이터에서 나오는데 시뮬레이터에
무선 전파 모델이 없어 RSSI 값 자체가 존재하지 않는다. 억지로 넣으면 학습 분포 밖
입력이 되어 측정한 성능이 무의미해진다.

실측이 결정할 것은 두 숫자다 — **차폐 판정 임계값(몇 dB)**과 **그때 낼 최소 레벨.**

---

## 9. 풀리지 않는 것 — 정직하게

**폭 3m 인도는 구분할 수 없다.** GPS σ가 2.5m인데 인도 폭이 3m다. R을 4m로
낮추면 3m 인도가 잡히지만 그때부터 진짜 충돌을 놓치기 시작한다(4절). 이것은
측위 정밀도의 물리적 한계이지 알고리즘으로 넘을 수 있는 벽이 아니다.

같은 이유로 "도로와 인도의 거리가 상황마다 다르다"는 문제도 따라갈 수 없다.
거리를 정확히 알 수 없기 때문이다.

**다만 이격이 좁은 도로는 대부분 이면도로·보차혼용이다.** 그곳에서는 울리는
편이 맞다. 이격 거리가 우연히 도로 유형의 대리 지표 노릇을 하므로, R=6m가 만드는
동작이 의도한 것과 대체로 일치한다. 설계로 얻은 것이 아니라 다행인 쪽에 가깝다.

---

## 10. 발표 방어 — 예상 질문과 답

실험은 실험대로 하고, 발표에서는 **결과를 어떤 조건 위에 놓을 것인가**가 중요하다.
아래는 σ 관련 질문에 대한 준비다.

### 먼저 프레임을 바로잡는다

σ 1.5m를 "우리가 달성하지 못한 이상적 조건"으로 말하면 안 된다. 사실은 반대다.

| 틀린 프레임 | 맞는 프레임 |
|---|---|
| σ 1.5m는 도달하기 어려운 값 | σ 1.5m는 **현행 표준 부품 수준** |
| 우리 성능이 여기까지다 | 우리는 **2011년 단종 부품**을 쓰고 있다 |
| 개선하려면 측위 인프라가 필요 | 개선 경로는 **모듈 교체** |

NEO-6M은 u-blox 6세대(2011년경)로 단종 상태이며 GPS 단독 수신이다. GLONASS도
Galileo도 받지 못한다. 사양상 CEP 2.5m는 **개활지 기준**이다.

### 모델 이득은 σ에 의존한다 — 이것을 먼저 밝힌다

`evaluate.py`를 σ만 바꿔 돌린 결과다(1200 × 5, `--lead-s 2.0`).

| σ | A. 점수표 | C. 모델 | **C − A** | 승률 |
|---|---|---|---|---|
| 2.5 m | 66.6% ±5.2 | 85.5% ±7.5 | **+18.9%p** | 4/5 |
| 1.5 m | 77.5% ±7.1 | 92.4% ±4.3 | **+14.9%p** | 5/5 |
| 1.0 m | 84.9% ±6.3 | 94.4% ±3.6 | **+9.5%p** | 5/5 |

**"+18.9%p"만 말하면 안 된다. "σ=2.5 조건에서"를 반드시 붙인다.** 조건을 밝히지
않으면 질문 한 번에 무너진다.

다만 σ가 좋아져도 사라지지 않는 것이 셋이다.

- 이득이 남는다 (+9.5%p, 5/5 승)
- 편차가 줄어든다 (±7.5 → ±3.6)
- **규칙의 천장을 계속 넘는다.** σ=1.0에서 모델 94.4% / 오경보 1.80%인데, 규칙으로
  낼 수 있는 최선(TTC≤3.0s)은 89.7% / 오경보 4.36%다.

### 이득 감소를 강점으로 바꾸는 해석

모델 이득이 σ에 반비례한다는 것은 **모델이 센서 품질을 보완하고 있다**는 뜻이다.

    σ=2.5 + 모델  =  85.5%
    σ=1.0 + 규칙  =  84.9%

**부품값을 소프트웨어로 대신하고 있다.** 시각장애인 보조기기는 저가여야 보급되므로,
이것은 축소해야 할 약점이 아니라 실용화 관점의 강점이다.

### 예상 질문

**Q. GPS 좋은 것을 쓰면 AI가 필요 없지 않나요?**
위 표를 보여준다. σ=1.0에서도 +9.5%p이고 전 시드 승리다. 그리고 σ=1.0급 모듈은
단가가 오르는데, 모델이 그 격차를 메운다.

**Q. σ 2.5m는 어디서 나온 값입니까?**
제조사 사양(개활지 CEP)이며, 실측은 [실험일]에 정지 로깅으로 측정했다.
→ **실측 전에는 이 질문에 답할 수 없다. 그래서 σ 측정이 실험 1순위다.**

**Q. 실제 도심에서도 됩니까?**
건물 사이 다중경로에서는 사양보다 나빠진다. σ=4.0m 조건도 측정해 두었고, 그때
적시경보는 60.1%다(5절). 성능이 떨어지는 구간을 알고 있으며, 그것이 모듈 교체가
필요한 이유다.

**Q. 왜 이 부품을 썼습니까?**
연구·검증 단계의 개발 장비다. 판정 로직과 통신 구조를 검증하는 데는 충분하고,
측위 정밀도가 성능을 지배한다는 것 자체가 이 연구의 결과다(6절).

**Q. 상용화하면 크기와 배터리는 어떻게 됩니까?**
→ 11절.

### 이 구성이 강한 이유

한계를 숨긴 발표는 질문 한 번에 무너지지만, 한계를 정량화하고 개선 경로를 제시한
발표는 **그 질문에 이미 답해 둔 상태**가 된다.

특히 6절의 축 분리("놓침은 측위, 오경보는 구조")는 시스템을 어디까지 이해하고
있는지를 보여주는 결과라 그대로 쓸 수 있다.

---

## 11. 상용화·소형화 검토

**결론: 부품으로는 가능하다. 진짜 제약은 연산도 배터리도 아닌 GPS 안테나다.**

### 젯슨은 양산품에 필요하지 않다

현재 젯슨이 하는 일을 보면 연산량이 크지 않다.

| 단계 | 연산 | 비고 |
|---|---|---|
| step2~3 파싱 | JSON 문자열 처리 | — |
| step4 상태 저장 | 딕셔너리 갱신 | — |
| step6 칼만 필터 | 4×4 행렬 몇 회 | **순수 파이썬 구현** |
| step7 판정 | 조건 분기 | — |
| 모델 추론 | 트리 앙상블 | **1ms 미만, 표준 라이브러리만** |

numpy도 sklearn도 쓰지 않는다(`model_runtime.py`). 5Hz이므로 초당 5회 돌면 된다.
**MCU에서 충분히 돈다.** 젯슨은 개발·연구 장비로 남기고 양산은 MCU로 간다.

### 개략 추정 — 실측으로 확인 필요

아래는 데이터시트 기준의 계산이며 **실제 측정값이 아니다.**

| 항목 | 전류(평균) | 크기 |
|---|---|---|
| ESP32 (통신+판정) | 80~120 mA | 18 × 25 mm |
| GPS 모듈 | 25~45 mA | 16 × 12 mm |
| 진동 모터 | 간헐 60~100 mA | 10 mm 코인형 |
| **합계** | **약 150 mA @ 3.7V ≈ 0.55W** | — |

2000mAh 리튬폴리머(약 60 × 35 × 6 mm)로 **10시간 이상** 추정. 하루 외출에는
충분하다. 전체 케이스 70 × 45 × 20 mm, 무게 60~80g 수준으로 예상한다.

**흰지팡이 자체가 보통 200~300g이므로 80g은 30% 증가다.** 무게 중심이 손잡이
쪽으로 쏠리는 것이 사용감에 어떤 영향을 주는지는 당사자 확인이 필요하다.

### 장착형 모듈이 맞는 선택인 이유

| | 전용 지팡이 | **부착 모듈** |
|---|---|---|
| 사용자 적응 | 길이·무게·그립이 바뀜 | **쓰던 지팡이 유지** |
| 진입 장벽 | 지팡이를 새로 사야 함 | 모듈만 구매 |
| 고장 대응 | 지팡이 전체 교체 | 모듈만 교체 |
| 인증 | 지팡이 개조 — 절차 복잡 | 부착물 — 상대적으로 단순(확인 필요) |

시각장애인은 자기 지팡이의 길이와 무게에 익숙해져 있다. **쓰던 것을 그대로 쓰게
하는 것이 기술적 성능보다 채택률에 크게 작용할 수 있다.**

### 진짜 제약 — 안테나와 정밀도의 충돌

**소형화와 측위 정밀도가 정면으로 부딪힌다.**

GPS 패치 안테나는 클수록, 그라운드 플레인이 넓을수록 성능이 좋다. 소형 모듈에
넣으면 안테나가 작아지고 σ가 나빠지는데, **σ는 이 시스템의 지배 변수다**(6절).
25 × 25 mm 패치 안테나 하나가 케이스 크기를 결정한다.

부착 위치도 같은 문제다.

| 위치 | 위성 시야 | 문제 |
|---|---|---|
| 손잡이 아래 | 나쁨 | 손과 몸에 가려짐 |
| **손잡이 상단 캡** | **좋음** | 하늘을 향하고 손은 그립 아래를 잡음 |
| 지팡이 중간 | 중간 | 흔들림이 큼, 파손 위험 |

**손잡이 상단이 유력하다.** 다만 그곳에 무게를 두면 지팡이를 휘두를 때 관성이
커지므로, 배터리는 아래에 두고 안테나만 위에 두는 분리 배치를 검토할 만하다.

### 검증하지 않은 것

- 위 전류·크기는 데이터시트 계산이며 실측이 아니다
- MCU 이식 시 파이썬 → C 포팅 공수를 산정하지 않았다
- 지팡이는 계속 바닥에 부딪히므로 내충격·방수 설계가 필요하다
- 지팡이의 좌우 스윙이 GPS·필터에 주는 영향을 측정한 적이 없다

---

## 12. 위험지도 — 원래 질문에 대한 답

팀에서 처음 나온 질문("안전한 구간은 어디 있나")으로 돌아온다.
2026-08-07 14:20 갱신본, 259개 구간 기준이다.

### 먼저 목적을 확정한다

지도를 만든 목적은 **시각화와 행정 의사결정 지원**이다. 위험도가 높은 지점을
드러내어 **동사무소·도시관리자가 CCTV 설치 등 조치를 취하게 하는 것**이다.

이 목적이 나머지를 전부 결정한다. 지팡이 실시간 판정에 먹이는 것은 부수적이며,
지금 단계에서는 하지 않는 편이 낫다(뒤 참조).

### 관찰된 것

| 항목 | 상태 |
|---|---|
| 0 · 안전 (초록) | **한 구간도 없음** |
| 1 · 주의 (노랑) | **대부분** |
| 2 · 위험 (주황) | 소수 (출입구 앞 큰길 등) |
| 3 · 매우 위험 (빨강) | 없음 |

### 목적에 비추어 보면 세 가지가 어긋나 있다

**1. 변별력이 없다 — 가장 치명적이다.**
행정은 예산이 한정적이므로 **순위**가 필요하다. "259곳이 위험합니다"로는 어디부터
손댈지 정할 수 없다. 시험에서 전원이 70점을 받으면 등수를 매길 수 없는 것과 같다.

같은 이유로 `zone_base_risk`에 연결해도 소용이 없다. 어디를 가도 같은 값이
더해지면 **모든 점수에 +1 한 것과 같아 순위가 바뀌지 않는다.** 상수는 정보가 아니다.

**2. 감쇠가 없으면 조치 효과를 볼 수 없다.**
초록이 없는 것은 데이터를 누적만 하고 오래된 이벤트를 버리지 않아서다. 그런데
이것은 증상이지 원인이 아니다. **감쇠가 없으면 시간이 갈수록 모든 구간이 1 이상으로
올라가 결국 전부 노랑이 된다.**

행정 목적에서 감쇠가 필요한 이유는 따로 있다 — **CCTV를 달았는데 지도가 계속
빨강이면 개선 효과를 측정할 수 없다.** 감쇠가 있어야 "좋아졌다"가 보이고, 그것이
행정이 가장 알고 싶어 하는 정보다.

**3. 노출 보정이 없으면 통행량 지도가 된다.**
이벤트 수를 그대로 세면 사람과 차가 많은 곳이 위험해 보인다. 출입구 앞 큰길이
주황인 것이 실제로 더 위험해서인지 통행량 때문인지 지금 구조로는 구분할 수 없다.
**위험도 = 상충 횟수 ÷ 노출량**으로 정규화해야 한다.

교통안전 통계에서 보행 사고는 대로보다 이면도로에서 더 많이 난다. 속도는 낮지만
보차 분리가 없기 때문이다. 노출 보정이 없으면 이 구조가 드러나지 않는다.

### "차도면 무조건 3"이 안 되는 이유

차도가 위험하다는 것은 누구나 안다. 모든 차도를 3으로 칠하면 **정보량이 0이 되어
지도를 볼 이유가 없어진다.** 행정에 필요한 것은 "차도가 위험합니다"가 아니라
"이 지점이 다른 곳보다 3배 위험합니다"이다.

"보행자가 차도에 있으면 위험하다"는 판단은 옳지만, 그것은 **지팡이 실시간 판정의
일이지 지도의 일이 아니다.** 두 역할이 섞이면 지도는 정보를 잃는다.

### 정의 — 차량용도 보행자용도 아닌 '상충 지도'

| | 차량용 | 보행자용 | **상충 지도** |
|---|---|---|---|
| 보는 사람 | 운전자·내비 | 보행자·지팡이 | **행정 담당자** |
| 답하는 질문 | 어디서 조심하나 | 어디로 가나 | **어디에 예산을 쓰나** |
| 등급 의미 | 사고 위험 | 통행 위험 | **개입 우선순위** |
| 시간 | 실시간 | 실시간 | **누적 통계** |
| 재는 것 | 차량 궤적 | 보행 궤적 | **둘이 만나는 지점** |

세 번째가 맞는 이유는 셋이다.

- 우리 시스템은 차대차 사고도, 보행자 단독 위험(넘어짐·장애물)도 재지 않는다.
  **재고 있는 것은 정확히 차-보행자 상충뿐이다.**
- 그 상충이 곧 행정 조치(횡단보도·신호·과속방지턱·CCTV·조명)의 대상이다.
- **재료가 이미 있다.** `oracle.py`가 PET(Post-Encroachment Time)를 계산한다.
  교통공학에서 상충을 재는 표준 지표이므로, 규칙 점수표 대신 이것을 등급 산정에
  쓰면 공무원에게 "교통공학 표준 지표입니다"라고 설명할 수 있다.

이렇게 정의하면 따라오는 것들이 있다. 실시간일 필요가 없으므로 젯슨 부담이 없고,
지팡이 판정과 분리되므로 `zone_base_risk`를 억지로 연결하지 않아도 된다.

### 지도는 인도/차도 문제를 풀어주지 않는다

한때 "구간 정보로 보차분리 여부를 알면 오경보를 줄일 수 있다"고 생각했으나,
지도가 차도 링크 단위이므로 **인도가 어디 있고 얼마나 떨어져 있는지를 담고 있지
않다.** 지도를 개선해도 2절의 문제는 그대로 남는다. 두 작업은 분리해서 진행한다.

### 그래서 어떻게 할 것인가

| 항목 | 판단 |
|---|---|
| 지도의 정의 | **상충 지도로 확정** — 행정 의사결정 지원 |
| 등급 산정 | **백분위 기반 상대 순위로** — 상위 10% / 30% 식 |
| 감쇠(시간 윈도) | **필요** — 없으면 전 구간 수렴, 조치 효과 측정 불가 |
| 노출 보정 | **필요** — 상충 횟수 ÷ 통행량 |
| PET 기반 등급 | **검토** — 표준 지표라 행정 설득력이 높다 |
| 시각화 | **상위 N개만 강조, 나머지는 회색** |
| `zone_base_risk` 값 주입 | **보류** — 변별력이 생긴 뒤에 재검토 |

마지막 시각화 항목이 즉시 효과가 크다. **259개를 전부 칠하면 아무것도 보이지
않는다.** 노란색이 259개면 그것은 정보가 아니라 배경이다. 상위 구간만 남기면
"어디부터 손대야 하나"에 지도가 직접 답한다.

`make_next_task.py`가 이미 경고한 바와 같다 — "근거 없는 가중치가 되기 때문이다."
그 경고가 옳았고, 이번 관찰이 그것을 뒷받침한다.

---

## 13. 8/9에 결정해야 할 것

| 항목 | 선택지 | 전제 |
|---|---|---|
| 하한 조건화 | 채택 / 보류 | **σ 실측값** (5절 표의 어느 행인가) |
| 점수표를 건드릴 것인가 | 예 / 아니오 | 인도 오경보의 절반이 점수표에서 나옴(4절) |
| NLOS 게이트 | 추가 / 보류 | 차폐 A/B 결과 |
| 지도 — 변별력 확보 방안 | 백분위 등급 / 감쇠 / 노출 보정 | 12절 (정의는 확정) |
| 두 모델 통합 | 기존 안건 | 아래 |

### 모델 통합 — 전제가 확인되었다

"AI 모델의 이득이 σ에 따라 달라지는가"는 측정했다(10절). **+18.9 → +14.9 → +9.5%p로
줄지만 사라지지 않으며, 승률과 안정성은 오히려 개선된다.**

따라서 **"AI를 쓸 것인가"를 재론할 필요는 없다.** 다만 발표에서 이득을 인용할
때는 조건을 반드시 함께 밝힌다.

---

## 부록 — 재현

```bash
cd 03_jetson/ttc_study

# 4·5절의 R 스윕 (sigma는 4.0 / 2.5 / 2.0 / 1.5 / 1.0으로 반복)
python floor_dcpa_sweep.py --n-scenarios 1200 --repeats 5 --gps-sigma-m 2.5

# 10절의 3-way 비교 (같은 sigma 값들로 반복)
python evaluate.py --n-scenarios 1200 --repeats 5 --lead-s 2.0 --gps-sigma-m 2.5
```

`--gps-sigma-m 2.5`로 돌린 `evaluate.py` 결과가 기존 인수인계 문서의 +18.9%p와
시드별 값까지 일치한다. 측정 경로가 바뀌지 않았다는 확인이다.

2절의 인도 시나리오는 `step7_risk.assess_risk`에 `step6_kinematics.relative_kinematics`
결과를 직접 넣어 계산했다. 보행자 (0,0) 북향 1.2 m/s, 차량 (offset, −behind)
북향 11.1 m/s.

**주의:** 시나리오 150개 1회로 먼저 돌렸을 때는 적시경보 손실이 0으로 나왔다.
위험 시나리오가 12개뿐이라 차이가 묻힌 것이다. `evaluate.py` 주석이 경고하는
바와 같은 함정이므로 1200개 × 5시드 이상에서 판단해야 한다.
