joon722/AI-V2X-Cane/rsu/v2x/03_jetson/auto_pipeline/multi_vehicle_eval/summary.txt

차량 1076대 / 묶음 300개 / 재생 143.5분
차 한 대만 있었다면 울렸을 경보 구간: 1060개 (차 750대)
  기존(칸 1개): 유지 269/1060 (25.4%), 경보를 하나라도 놓친 차 593대
  다중(차선): 유지 1060/1060 (100.0%), 경보를 하나라도 놓친 차 0대
참값 3.0 m 안 근접 통과 차 218대 - 최근접 3초 전 안에 L2+:
  기준(차별 단독): 163/218 (74.8%)
  기존(칸 1개): 58/218 (26.6%)
  다중(차선): 187/218 (85.8%)
가짜 경보(어느 차 기준도 L2+ 아님) 기존(칸 1개): 78.4초 (0.91% 시간)
가짜 경보(어느 차 기준도 L2+ 아님) 다중(차선): 0.0초 (0.00% 시간)

[SUMO 위험 라벨 기준 - 채점표 x DCPA 게이트, 참값 좌표 1 Hz]
라벨 붙은 차 1076대 중 L2+ 라벨이 있는 차 527대
라벨 L2+(경고 이상) 구간 665개 - 시작 3초 전~구간 끝에 지팡이 L2+:
  기준(차별 단독): 483/665 (72.6%), 선행 중앙값 +0.8초
  기존(칸 1개): 169/665 (25.4%), 선행 중앙값 +1.4초
  다중(차선): 567/665 (85.3%), 선행 중앙값 +2.4초
라벨 L3(위험) 구간 199개 - 시작 3초 전~구간 끝에 지팡이 L2+:
  기준(차별 단독): 172/199 (86.4%), 선행 중앙값 +2.2초
  기존(칸 1개): 41/199 (20.6%), 선행 중앙값 +1.5초
  다중(차선): 182/199 (91.5%), 선행 중앙값 +2.8초
차선 등급 vs 그 차 라벨 (초 단위, 다중 방식만 차마다 등급이 있다):
  기준(차별 단독): 4등급 일치 78.1%, L2+ 재현율 54.3% (932/1716), 라벨(현재·3초 미래) 없는 L2+ 1340초
  다중 차선: 4등급 일치 78.1%, L2+ 재현율 54.3% (932/1716), 라벨(현재·3초 미래) 없는 L2+ 1340초
라벨 근거 없는 지팡이 경보(±3초 안에 어느 차도 L2+ 아님) 기존(칸 1개): 91초 / 8878초 (1.03%)
라벨 근거 없는 지팡이 경보(±3초 안에 어느 차도 L2+ 아님) 다중(차선): 472초 / 8878초 (5.32%)
라벨 근거 없는 지팡이 경보(±3초 안에 어느 차도 L2+ 아님) 차별 단독 판정의 최댓값: 472초 / 8878초 (5.32%)
