joon722/AI-V2X-Cane/docs/미팅 내용/4.16 팀 미팅.pdf

## 한이음 공모전 하이퍼-슝

2026.4.16. | 2차 회의 | 작성자:강현준

### 오늘 프로젝트의 목표

## 기본적인 장비 연결 및 하는 시스템 구축

## 팀 미팅 진행사항

없음

## 문제점

1.해야 할 일에 대해서 자세하게 알아보지 않아 진행에 많은 차질이 생김 2.설치를 하고 와야할 프로그램에 대해서 인지하지 못 함

## 해결방안

## 1.사전에 본인이 무엇을 할지 그리고 어떻게 할지에 대해서 기본적인 방안 만들어 오기

### 다음 팀 모임 계획

### 4.27 월: 장비 통신 구축,서로 프로그램 설치
