joon722/AI-V2X-Cane/arduino/99_legacy_originals/README.md

# Legacy Originals

정리 전 원본 코드 보관 폴더입니다.

파일 이름을 바로 이해하기 쉽도록 바꿔 보관했지만, 내용은 기존 코드 흐름을 유지합니다.

새로 작업하거나 업로드할 때는 상위의 `01_`, `02_`, `03_` 폴더를 우선 사용하세요.
