joon722/AI-V2X-Cane/AI_Model/transformer/models_v4/training_report_v3.txt

target: risk_level_future3 (3s lookahead)
features(20)
train 402,531 / test 85,957 (scenario split 64)

              precision    recall  f1-score   support

         안전0     0.9607    0.8314    0.8914     60000
         주의1     0.6371    0.6475    0.6422     17819
         경고2     0.4137    0.6162    0.4951      6230
         위험3     0.2612    0.9099    0.4059      1908

    accuracy                         0.7794     85957
   macro avg     0.5682    0.7512    0.6087     85957
weighted avg     0.8385    0.7794    0.8002     85957

[[49883  5968  2278  1871]
 [ 1817 11538  3042  1422]
 [  180   594  3839  1617]
 [   41    11   120  1736]]
ONNX diff 1.91e-06
