joon722/AI-V2X-Cane/data/듀얼시리얼기록/260819test_2026-08-19_19-24-12/지팡이_값기록.csv

시각 | 경과초 | 시각ms | IMU시각ms | 부팅횟수 | 리셋원인 | GPS복구횟수 | 마지막GPS복구ms | 위험 | 차량위험 | 차량위험경과ms | RSU위험 | RSU위험경과ms | GPS유효 | 위도 | 경도 | 속도 | 방향 | GPS원시속도 | GPS원시방향유효 | GPS원시방향 | 가속도 | 자이로 | 자력계 | IMU방향유효 | IMU방향 | 방향가속도크기 | 방향자이로크기 | 방향자세cos | 자기모델잔차 | 자기모델반경 | 방향채택 | 방향거부 | 송신 | GPS위성 | GPS_HDOP | 원시위도 | 원시경도 | GPS채택 | GPS이상치거부 | GPS품질거부 | GPS재기준 | RSSI원시 | RSSI평활 | RSSI샘플 | RSSI경과ms | 차량수신
19:24:12 | 0.207 | 820702 | 820690 | 340 | POWER_ON | 0 | 0 | 0 | 0 | -1 | 0 | -1 | 1 | 37.496357 | 126.958397 | 0.035 | 0.0 | 0.015 | 1 | 338.2 | -2.126,2.911,9.007 | 0.664,-1.198,-0.580 | 5.550,75.600,-17.550 | 0 | 182.3 | 9.70 | 1.49 | 0.6141 | 7.64 | 0.380 | 150 | 100038 | 7708 | 9 | 1.09 | 37.496358 | 126.958397 | 660 | 5 | 63 | 0 | -57 | -56.2 | 7705 | 8 | 0
19:24:12 | 0.391 | 820808 | 820796 | 340 | POWER_ON | 0 | 0 | 0 | 0 | -1 | 0 | -1 | 1 | 37.496357 | 126.958397 | 0.035 | 0.0 | 0.015 | 1 | 338.2 | -2.169,2.954,8.993 | 0.519,1.802,-0.328 | 4.200,75.000,-16.500 | 0 | 182.3 | 9.71 | 1.90 | 0.6123 | 7.64 | 0.380 | 150 | 100051 | 7709 | 9 | 1.09 | 37.496358 | 126.958397 | 660 | 5 | 63 | 0 | -59 | -56.8 | 7706 | 17 | 0
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
