joon722/AI-V2X-Cane/data/듀얼시리얼기록/260820test2_2026-08-20_17-10-17/지팡이_값기록.csv

시각 | 경과초 | 시각ms | IMU시각ms | 부팅횟수 | 리셋원인 | GPS복구횟수 | 마지막GPS복구ms | 위험 | 차량위험 | 차량위험경과ms | RSU위험 | RSU위험경과ms | GPS유효 | 위도 | 경도 | 속도 | 방향 | GPS원시속도 | GPS원시방향유효 | GPS원시방향 | 가속도 | 자이로 | 자력계 | IMU방향유효 | IMU방향 | 방향가속도크기 | 방향자이로크기 | 방향자세cos | 자기모델잔차 | 자기모델반경 | 방향채택 | 방향거부 | 송신 | GPS위성 | GPS_HDOP | 원시위도 | 원시경도 | GPS채택 | GPS이상치거부 | GPS품질거부 | GPS재기준 | RSSI원시 | RSSI평활 | RSSI샘플 | RSSI경과ms | 차량수신
17:10:17 | 0.338 | 2956068 | 2956056 | 356 | POWER_ON | 0 | 0 | 1 | 0 | -1 | 1 | 184 | 1 | 37.496353 | 126.958328 | 0.423 | 0.0 | 0.221 | 1 | 320.7 | 2.868,1.882,7.858 | 19.939,3.908,23.313 | -50.400,27.000,14.400 | 0 | 157.4 | 8.57 | 30.92 | 0.8878 | 6.88 | 1.519 | 7149 | 355270 | 27899 | 8 | 1.21 | 37.496359 | 126.958326 | 5229 | 12 | 8 | 3 | -74 | -70.4 | 27248 | 38 | 27248
17:10:17 | 0.533 | 2956279 | 2956267 | 356 | POWER_ON | 0 | 0 | 0 | 0 | -1 | 0 | 14 | 1 | 37.496361 | 126.958321 | 0.433 | 0.0 | 0.453 | 1 | 320.7 | 1.623,2.581,10.554 | 17.076,4.588,36.031 | -46.950,31.650,19.500 | 0 | 157.4 | 10.99 | 40.14 | 0.8151 | 6.88 | 1.519 | 7149 | 355296 | 27901 | 8 | 1.21 | 37.496367 | 126.958323 | 5230 | 12 | 8 | 3 | -71 | -70.5 | 27249 | 47 | 27249
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
