joon722/AI-V2X-Cane/data/듀얼시리얼기록/260820test3_2026-08-20_17-23-27/지팡이_값기록.csv

시각 | 경과초 | 시각ms | IMU시각ms | 부팅횟수 | 리셋원인 | GPS복구횟수 | 마지막GPS복구ms | 위험 | 차량위험 | 차량위험경과ms | RSU위험 | RSU위험경과ms | GPS유효 | 위도 | 경도 | 속도 | 방향 | GPS원시속도 | GPS원시방향유효 | GPS원시방향 | 가속도 | 자이로 | 자력계 | IMU방향유효 | IMU방향 | 방향가속도크기 | 방향자이로크기 | 방향자세cos | 자기모델잔차 | 자기모델반경 | 방향채택 | 방향거부 | 송신 | GPS위성 | GPS_HDOP | 원시위도 | 원시경도 | GPS채택 | GPS이상치거부 | GPS품질거부 | GPS재기준 | RSSI원시 | RSSI평활 | RSSI샘플 | RSSI경과ms | 차량수신
17:23:27 | 0.268 | 340289 | 340277 | 357 | POWER_ON | 0 | 0 | 0 | 0 | -1 | 0 | 177 | 1 | 37.496349 | 126.958344 | 0.061 | 0.0 | 0.051 | 1 | 266.6 | 7.805,2.030,5.152 | 2.183,-0.748,-0.718 | -42.300,97.200,2.850 | 0 | 78.4 | 9.57 | 2.42 | 0.9242 | 10.80 | 1.184 | 2631 | 37796 | 3111 | 8 | 1.35 | 37.496347 | 126.958341 | 1467 | 0 | 19 | 0 | -76 | -71.2 | 3158 | 22 | 3158
17:23:27 | 0.390 | 340395 | 340383 | 357 | POWER_ON | 0 | 0 | 0 | 0 | -1 | 0 | 78 | 1 | 37.496346 | 126.958344 | 0.060 | 0.0 | 0.057 | 1 | 266.6 | 7.815,1.925,5.416 | -2.603,1.656,-0.962 | -43.800,95.250,4.650 | 0 | 78.4 | 9.70 | 3.23 | 0.9240 | 10.80 | 1.184 | 2631 | 37809 | 3112 | 8 | 1.35 | 37.496347 | 126.958342 | 1468 | 0 | 19 | 0 | -76 | -72.1 | 3159 | 22 | 3159
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
