joon722/AI-V2X-Cane/AI_Model/transformer/scenario_9380_result.csv

ts_ms | timestep_time | vehicle_id | ped_x | ped_y | veh_x | veh_y | ped_speed_mps | veh_speed_mps | distance_m | rel_speed_mps | ttc | ttc_valid | risk_score | zone_base_risk | dx | dy | dvx | dvy | dcpa_m | phys_min_dist_3s | phys_t_cpa | phys_score_3s | onnx_risk_level | onnx_confidence
10000 | 10.0 | 1 | 3649.41 | 1480.1 | 3569.93 | 1463.36 | 1.19 | 4.81 | 81.22375268355928 | 2.5699612811530557 | 30.0 | 1.0 | 8.0 | 0.0 | -79.48000000000002 | -16.74000000000001 | 1.8400000000001455 | 3.4700000000000273 | 62.376606892962265 | 74.23038798228079 | 3.0 | 33.0 | 0 | 0.5197949
11000 | 11.0 | 1 | 3650.6 | 1480.24 | 3575.07 | 1466.81 | 1.2 | 6.59 | 76.7147039360771 | 4.509048747482183 | 17.01350068102812 | 1.0 | 11.0 | 0.0 | -75.52999999999975 | -13.430000000000064 | 3.950000000000273 | 3.3099999999999454 | 38.21784418839793 | 63.77611151520501 | 3.0 | 36.0 | 1 | 0.5427343
12000 | 12.0 | 1 | 3651.82 | 1480.39 | 3578.65 | 1469.09 | 1.23 | 4.59 | 74.03741554106286 | 2.6772883950142443 | 27.65388132221331 | 1.0 | 8.0 | 0.0 | -73.17000000000007 | -11.300000000000182 | 2.3599999999996726 | 2.1299999999998818 | 40.63578686182154 | 66.27213743346553 | 3.0 | 33.0 | 1 | 0.47742385
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
