joon722/AI-V2X-Cane/data/듀얼시리얼기록/260820test2_2026-08-20_17-10-17/차량_값기록.csv

시각 | 경과초 | 시각ms | IMU시각ms | 위험 | 원시위험 | GPS유효 | 위도 | 경도 | 속도 | 방향 | 이동방향유효 | GPS이동방향 | 차체방향유효 | 차체방향 | 후진판정 | IMU요회전속도 | 방향가속도크기 | 방향자이로크기 | 방향자세cos | 자기모델잔차 | 자기모델반경 | 방향채택 | 방향거부 | GPS원시속도 | GPS원시방향유효 | GPS원시방향 | 가속도 | 자이로 | 자력계 | 충격값 | 충격피크 | 마지막충격발생값 | 마지막충격발생ms | 송신 | 지팡이수신 | GPS위성 | GPS_HDOP | 원시위도 | 원시경도 | GPS채택 | GPS이상치거부 | GPS품질거부 | GPS재기준 | 계산거리 | 접근속도 | TTC | 방향오차 | 전방여부 | 위험음성횟수 | 충격음성횟수 | 마지막위험음성 | RSSI원시 | RSSI평활 | RSSI샘플 | RSSI경과ms | RSSI구간 | RSSI거리 | 상대보정 | 상대보정중
17:10:17 | 0.070 | 2959985 | 2959984 | 1 | 0 | 1 | 37.496299 | 126.958493 | 0.01 | 0.0 | 0 | 204.0 | 1 | 56.0 | 1 | 0.00 | 10.56 | 4.27 | 0.9927 | 36.80 | 1.833 | 0 | 342187 | 0.010 | 1 | 185.8 | -0.97,-0.65,10.50 | -1.1,-3.9,1.5 | 12.000,34.350,27.450 | 1.49 | 2.96 | 0.00 | 0 | 28752 | 25751 | 8 | 1.21 | 37.496295 | 126.958493 | 2626 | 9 | 49 | 2 | 8.77 | 0.00 | 999.00 | -132.5 | 0 | 108 | 0 | 1 | -70 | -67.3 | 25751 | 80 | 4 | 4.39 | 1 | 0
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
