joon722/AI-V2X-Cane/data/듀얼시리얼기록/260820test3_2026-08-20_17-23-27/차량_값기록.csv

시각 | 경과초 | 시각ms | IMU시각ms | 위험 | 원시위험 | GPS유효 | 위도 | 경도 | 속도 | 방향 | 이동방향유효 | GPS이동방향 | 차체방향유효 | 차체방향 | 후진판정 | IMU요회전속도 | 방향가속도크기 | 방향자이로크기 | 방향자세cos | 자기모델잔차 | 자기모델반경 | 방향채택 | 방향거부 | GPS원시속도 | GPS원시방향유효 | GPS원시방향 | 가속도 | 자이로 | 자력계 | 충격값 | 충격피크 | 마지막충격발생값 | 마지막충격발생ms | 송신 | 지팡이수신 | GPS위성 | GPS_HDOP | 원시위도 | 원시경도 | GPS채택 | GPS이상치거부 | GPS품질거부 | GPS재기준 | 계산거리 | 접근속도 | TTC | 방향오차 | 전방여부 | 위험음성횟수 | 충격음성횟수 | 마지막위험음성 | RSSI원시 | RSSI평활 | RSSI샘플 | RSSI경과ms | RSSI구간 | RSSI거리 | 상대보정 | 상대보정중
17:23:27 | 0.190 | 344760 | 344759 | 0 | 0 | 1 | 37.496297 | 126.958283 | 1.31 | 208.3 | 1 | 208.3 | 1 | 19.7 | 1 | 0.00 | 21.86 | 23.90 | 0.9466 | 32.52 | 1.772 | 0 | 38277 | 1.374 | 1 | 193.2 | -2.54,4.96,21.14 | 23.3,-4.1,3.5 | -15.450,26.100,24.900 | 12.24 | 12.24 | 0.00 | 0 | 3213 | 3064 | 8 | 1.19 | 37.496296 | 126.958286 | 330 | 0 | 0 | 0 | 12.85 | -0.57 | 999.00 | -115.5 | 0 | 12 | 0 | 2 | -68 | -68.2 | 3064 | 93 | 4 | 4.78 | 1 | 0
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
