joon722/AI-V2X-Cane/arduino/99_legacy_tests/README.md

# Legacy Tests

초기 테스트 코드 보관 폴더입니다.

- `gps_imu_read_test.ino`: GPS/IMU 단독 읽기 테스트
- `espnow_sender_receiver_combined_reference.ino`: 초기 ESP-NOW 송수신 참고 코드

주의: combined reference 파일은 한 파일에 송신기와 수신기 코드가 같이 들어 있어 그대로 Arduino IDE에 업로드하면 컴파일되지 않을 수 있습니다.
