joon722/AI-V2X-Cane/lux/sample_risk_input.csv

ts_ms | ped_x | ped_y | veh_x | veh_y | ped_speed_mps | veh_speed_mps | distance_m | rel_speed_mps
0 | 0 | 0 | 40 | 0 | 1.0 | 5.0 | 40.0 | 4.0
1000 | 1 | 0 | 30 | 0 | 1.0 | 6.0 | 29.0 | 5.0
2000 | 2 | 0 | 20 | 0 | 1.0 | 7.0 | 18.0 | 6.0
3000 | 3 | 0 | 10 | 0 | 1.0 | 8.0 | 7.0 | 7.0
