joon722/AI-V2X-Cane/rsu/v2x/03_jetson/scripts/v2x_risk_log.csv

rx_wall | node_id | distance_m | closing_mps | ttc_s | risk_level | reason | sent
1785473463.350 |  | 0.00 | 0.00 | inf | 0 | no_vehicle | {"target_id": 0, "risk": 0}
1785473463.458 |  | 0.00 | 0.00 | inf | 0 | no_vehicle
1785473463.560 |  | 0.00 | 0.00 | inf | 0 | no_vehicle
1785473463.668 |  | 0.00 | 0.00 | inf | 0 | no_vehicle
1785473463.784 |  | 0.00 | 0.00 | inf | 0 | no_vehicle
1785473463.887 |  | 0.00 | 0.00 | inf | 0 | no_vehicle
1785473463.992 |  | 0.00 | 0.00 | inf | 0 | no_vehicle
1785473464.097 |  | 0.00 | 0.00 | inf | 0 | no_vehicle
1785473464.201 |  | 0.00 | 0.00 | inf | 0 | no_vehicle
1785473464.307 |  | 0.00 | 0.00 | inf | 0 | no_vehicle
1785473464.412 |  | 0.00 | 0.00 | inf | 0 | no_vehicle
1785473464.518 |  | 0.00 | 0.00 | inf | 0 | no_vehicle
1785473464.644 |  | 0.00 | 0.00 | inf | 0 | no_vehicle
1785473464.742 |  | 0.00 | 0.00 | inf | 0 | no_vehicle
1785473464.844 |  | 0.00 | 0.00 | inf | 0 | no_vehicle
1785473464.946 |  | 0.00 | 0.00 | inf | 0 | no_vehicle
1785473465.049 |  | 0.00 | 0.00 | inf | 0 | no_vehicle
1785473465.150 |  | 0.00 | 0.00 | inf | 0 | no_vehicle
1785473465.239 |  | 0.00 | 0.00 | inf | 0 | no_vehicle
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
