joon722/AI-V2X-Cane/rsu/v2x/03_jetson/scenarios/minseo_outputs/scenario_high_risk.csv

timestep_time | vehicle_angle | vehicle_id | vehicle_lane | vehicle_pos | vehicle_slope | vehicle_speed | vehicle_type | vehicle_x | vehicle_y | distance_to_ped | relative_speed | ttc | risk_level
68.0 | 91.41 | 68 | 278024801#5_0 | 5.1 | 0.0 | 0.0 | DEFAULT_VEHTYPE | 3650.38 | 1330.24 | 80.33804827104026 | -0.0 | 999.0 | 0
69.0 | 91.41 | 68 | 278024801#5_0 | 7.3 | 0.0 | 2.2 | DEFAULT_VEHTYPE | 3652.57 | 1330.19 | 80.15510588852085 | 0.18294238251941408 | 438.1439925765408 | 0
70.0 | 86.96 | 68 | 278024801#5_0 | 12.0 | 0.0 | 4.7 | DEFAULT_VEHTYPE | 3657.24 | 1330.46 | 79.58787093521221 | 0.5672349533086418 | 140.30847441784348 | 0
71.0 | 79.16 | 68 | 278024801#5_0 | 18.5 | 0.0 | 6.5 | DEFAULT_VEHTYPE | 3663.63 | 1331.68 | 78.40407706235685 | 1.183793872855361 | 66.23119012539142 | 0
72.0 | 66.13 | 68 | 278024801#5_0 | 26.57 | 0.0 | 8.07 | DEFAULT_VEHTYPE | 3671.16 | 1334.46 | 76.35991880561419 | 2.044158256742662 | 37.35518938112583 | 0
73.0 | 61.84 | 68 | :2825724222_1_0 | 5.69 | 0.0 | 6.53 | DEFAULT_VEHTYPE | 3676.96 | 1337.44 | 74.51573793501606 | 1.844180870598123 | 40.405872939593166 | 0
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
