joon722/AI-V2X-Cane/arduino/car_firmware/car_debug_V5.ino

// ESP32 V2X 차량 노드 통합 코드 V5
// - u-blox M9N GPS(KoA, L1 4-GNSS) 또는 MicoAir MG-F10/NEO-F10N(L1+L5), 5Hz: 차량 위치/속도/방향 수집
// - IMU (100Hz): ICM-20948 또는 BNO055(IMU_CHIP_ICM20948로 선택). 방향, 가속도/자이로 및 큰 충격 감지
// - Fermion DFPlayer Pro DFR0768 + 스피커: 위험 단계/충격 음성 안내
// - ESP-NOW: 차량 상태 송신, 지팡이 상태 수신, 거리/TTC 위험도 송신
//
// 필요한 Arduino 라이브러리
//   TinyGPSPlus
//   SparkFun u-blox GNSS v3
//   SparkFun 9DoF IMU Breakout - ICM 20948 (ICM-20948일 때)
//   Adafruit BNO055, Adafruit Unified Sensor (BNO055일 때)
// DFPlayer Pro는 별도 라이브러리 없이 AT 명령으로 제어함.

// USB-C로 DFPlayer Pro 내장 128MB 저장소의 루트에 넣을 음원 이름
//   /0001.mp3 : 주의
//   /0002.mp3 : 경고
//   /0003.mp3 : 위험
//   /0004.mp3 : 충격 감지

// ESP32 기본 배선
//   GPS TX  -> GPIO16 (ESP32 RX2)
//   GPS RX  -> GPIO17 (ESP32 TX2, 없어도 수신 가능)
//   IMU SDA -> GPIO21, SCL -> GPIO22, 3.3V, GND
//     ICM-20948: 주소 0x69/0x68 둘 다 자동 시도
//     BNO055: COM3/I2C_SEL -> GND (주소 0x28)
//   DF Pro RX <- GPIO27 (ESP32 TX1)
//   Portenta C33 D14/TX -> GPIO32 (ESP32 RX1)
//   Portenta C33+UWB Shield를 별도 USB로 켜면 ESP32와 GND는 반드시 공통
//   스피커 한 개: DF Pro L+/L- 또는 R+/R-, 모든 모듈 GND 공통


#include <WiFi.h>
#include <WiFiUdp.h>
#include <Preferences.h>
#include <WebServer.h>
#include <esp_now.h>
#include "esp_wifi.h"
#include "esp_system.h"
#include <Wire.h>
#include <TinyGPSPlus.h>
#include <SparkFun_u-blox_GNSS_v3.h>
#include <math.h>

// IMU 칩 선택. 1 = ICM-20948, 0 = BNO055 (CJMCU-055).
#define IMU_CHIP_ICM20948 1

#if IMU_CHIP_ICM20948
#include <ICM_20948.h>
#else
#include <Adafruit_Sensor.h>
#include <Adafruit_BNO055.h>
#endif

// =====================
// 기능 설정
// =====================
#define USE_GPS 1
#define USE_IMU 1
#define USE_DFPLAYER 1
#define USE_UWB 1

// GPS가 안 잡히는 실내에서도 테스트할 때 1.
// 실제 도로 주행에서는 반드시 0 권장.
#define USE_DEMO_MOVING_FALLBACK 0

// 야외 RSU/Jetson 시연에서는 위험도 판정과 하행 전송을 RSU 단독으로 맡긴다.
// 차량 상태(GPS/속도/방향) 10Hz 송신과 차량 내부 진단 계산은 유지된다.
#define VEHICLE_CALCULATES_RISK 0
// RSU가 지팡이와 차량에 같은 MSG_RISK_ALERT를 보내며,
// 차량 스피커도 RSU 판정값만 사용한다.
#define ENABLE_RSU_RISK_INPUT 1

// 1: 실내 책상 테스트 거리, 0: 실제 도로용 거리
#define USE_INDOOR_RISK_DISTANCE 0

// 블루투스 디버그 (뷰어/폰용). 시연/실전 때는 0.
#define USE_BT_DEBUG 0

// 아이패드/폰 브라우저용 웹뷰어. V2X-LOG 에 접속 후 http://192.168.4.1
// 시연 때 부하를 줄이고 싶으면 0으로 바꾼다.
#define USE_WEB_VIEWER 1
#define WEB_VIEWER_PORT 80
#define CANE_LOG_UDP_PORT 4210
#define CANE_CMD_REPLY_PORT 4301

#if USE_BT_DEBUG
#include "BluetoothSerial.h"
#endif

WiFiUDP logUdp;
IPAddress udpBroadcastAddress(192, 168, 4, 255);
uint32_t lastUdpTelemetryMs = 0;

// =====================
// 핀/통신 설정
// =====================
#define LED_PIN 2

#define GPS_RX 16
#define GPS_TX 17
#define GPS_BAUD 115200

#define IMU_SDA 21
#define IMU_SCL 22
#define BNO055_I2C_ADDRESS 0x28
// CJMCU-055 보드에 32.768kHz 외부 크리스털을 납땜했을 때만 1.
// (크리스털은 보드와 따로 들어 있다. 안 달았는데 1이면 동작이 불안정할 수 있다)
#define BNO_USE_EXTERNAL_CRYSTAL 0
// ICM-20948 자력계 방향을 자이로 방향에 섞는 시상수(초). 클수록 자이로를 더 믿는다.
#define ICM_MAG_BLEND_TAU_S 1.0f
#define IMU_SAMPLE_INTERVAL_MS 10UL
// 가속도·자력계·보정상태는 이 주기로만 읽어 I2C(100kHz) 점유를 줄인다.
#define IMU_SLOW_INTERVAL_MS 100UL

#define UWB_RX 32       // ESP32 RX1 <- Portenta C33 D14/TX
#define DFPLAYER_TX 27  // ESP32 TX1 -> DFPlayer RX
#define DFPLAYER_BAUD 115200
#define DFPLAYER_VOLUME 15  // 0~30

// DFPlayer Pro는 TX(GPIO27)만 사용하고 같은 UART1의 RX(GPIO32)로
// Portenta C33 UWB bridge 출력을 받는다. 두 장치 모두 115200bps.
#define UWB_BAUD 115200
#define UWB_FRESH_TIMEOUT_MS 750UL
#define UWB_CAL_REQUIRED_SAMPLES 100U
#define UWB_CAL_TIMEOUT_MS 30000UL
#define UWB_MIN_DISTANCE_M 0.05f
#define UWB_MAX_DISTANCE_M 100.0f
// UWB 정면 맞추기(uwb front): 지팡이를 든 사람이 차 정면에 서 있는 동안 각도를 모아
// 그 평균을 정면(0°)으로 삼는다. 쉴드가 비뚤게 붙은 만큼을 한 번 재서 저장한다.
#define UWB_FRONT_REQUIRED_SAMPLES 25U   // 5 Hz면 약 5초
#define UWB_FRONT_MAX_SPREAD_DEG 10.0f   // 표준편차가 이보다 크면 움직였거나 반사 → 다시 모음
#define UWB_FRONT_MAX_OFFSET_DEG 20.0f   // 평균이 이보다 크면 정면에 선 게 아니라고 본다
#define UWB_FRONT_TIMEOUT_MS 20000UL

// =====================
// 동작 설정
// =====================

// =====================
// 차량 ESP32 자체 Wi-Fi 및 UDP 로그
// =====================
#define V2X_WIFI_CHANNEL 6
#define VEHICLE_UDP_PORT 4211

const char *V2X_AP_SSID = "V2X-LOG";
const char *V2X_AP_PASSWORD = "12345678";

#define SEND_INTERVAL_MS 100UL
// 제어/ESP-NOW는 10Hz 그대로 유지하고, 사람이 보는 UDP 진단만 2Hz로 제한한다.
// 로그 전송이 센서 처리와 위험 알림을 방해하지 않도록 분리한 값이다.
#define UDP_TELEMETRY_INTERVAL_MS 500UL
#define CANE_TIMEOUT_MS 2000UL
#define RSU_RISK_TIMEOUT_MS 3000UL
#define SENSOR_LOG_INTERVAL_MS 1000UL
#define GPS_FIX_MAX_AGE_MS 3000UL

// ESP-NOW RSSI 평활 계수. 작을수록 순간 흔들림을 더 강하게 줄인다.
#define CANE_RSSI_FILTER_ALPHA 0.20f

// ===== 2026-08-05 RSSI 실측 보정 =====
// 1/3/5/8/10m LOS 중앙값(차량측): -51.0/-65.2/-63.5/-72.7/-76.7dBm.
// 3m와 5m가 역전되므로 RSSI를 정확한 거리계로 쓰지 않고,
// 구간 + 히스테리시스 + 유지시간으로만 사용한다.
#define RSSI_FRESH_TIMEOUT_MS 1000UL
#define RSSI_CLOSER_CONFIRM_MS 800UL
#define RSSI_FARTHER_CONFIRM_MS 2500UL
#define RSSI_VERY_CLOSE_ENTER_DBM (-58.0f)
#define RSSI_VERY_CLOSE_EXIT_DBM  (-62.0f)
#define RSSI_CLOSE_ENTER_DBM      (-69.0f)
#define RSSI_CLOSE_EXIT_DBM       (-73.0f)
#define RSSI_APPROACH_ENTER_DBM   (-75.0f)
#define RSSI_APPROACH_EXIT_DBM    (-79.0f)

// RSSI 연속 거리 추정은 진단용으로만 남긴다.
// CPA 상대벡터의 방향과 크기는 영점보정한 GPS에서 모두 가져온다.
// RSSI로 GPS 벡터 크기를 강제하면 평행 통과 때 횡방향 이격거리까지
// 줄어들어 충돌 경로로 오인할 수 있다.
// 실측 회귀: RSSI = -51.7 - 10 * 2.42 * log10(distance).
#define RSSI_AT_1M_DBM (-51.7f)
#define RSSI_PATH_LOSS_EXPONENT 2.42f
#define RSSI_DISTANCE_MIN_M 0.8f
#define RSSI_DISTANCE_MAX_M 12.0f

// 두 GPS 안테나를 나란히 놓고 BOOT 버튼을 누르면 상대좌표 영점을 잡는다.
// 보정 전/보정 중에는 GPS 단독 위험판정을 금지한다.
#define REL_CAL_BUTTON_PIN 33
#define REL_CAL_STILL_TIME_MS 8000UL
#define REL_CAL_TIMEOUT_MS 30000UL
#define REL_CAL_MIN_SAMPLES 40
#define REL_CAL_MAX_OFFSET_SPREAD_M 5.0f

// GPS 품질/이상치 필터 설정: RC카 기준.
#define GPS_MIN_SATELLITES 4
#define GPS_MAX_HDOP 3.5f
#define GPS_NODE_MAX_SPEED_MPS 6.0f
#define GPS_OUTLIER_BASE_M 10.0f   // 8/18 패치: 4→10 (거부=좌표 동결=젯슨이 이동 못 봄; 젯슨에 자체 게이트 있음)
#define GPS_FILTER_ALPHA 0.50f
#define GPS_FILTER_BETA 0.08f
// GPS가 실제 5Hz면 15회, 1Hz로 떨어지면 3회를 사용해 어느 경우든
// 약 3초 동안 같은 새 위치가 반복될 때 필터 기준 위치를 재설정한다.
#define GPS_RELOCALIZE_AFTER_REJECTS_5HZ 5   // 8/18 패치: 15(3 s)→5(1 s) 최대 동결 1 s
#define GPS_RELOCALIZE_AFTER_REJECTS_1HZ 3
#define GPS_FILTER_RESET_GAP_MS 5000UL
#define GPS_PREDICTION_MAX_MS 700UL
#define GPS_5HZ_RECOVERY_COOLDOWN_MS 60000UL
#define GPS_5HZ_RECOVERY_MIN_UPTIME_MS 15000UL

// 정지 상태용 GPS 필터.
#define GPS_STATIONARY_SPEED_MPS 0.25f   // 8/18 패치: 0.45→0.25 (젯슨 ZUPT 문턱과 동일)
#define GPS_STATIONARY_ALPHA 0.30f   // 8/18 패치: 0.08→0.30 (정지 모드 좌표 지연 2.4 s→0.6 s)
#define GPS_STATIONARY_BETA 0.01f

// GPS 진행 방향을 신뢰하기 위한 최소 차량 속도.
#define MIN_VALID_HEADING_SPEED_MPS 0.25f   // 8/18 패치: 0.40→0.25 (RC 속도대·젯슨 도플러 융합 문턱과 동일)

// ===== 2026-08-03~05 차량 실측 방향 보정 =====
// GPS course는 실제 이동 경로(전진/후진 포함), IMU는 차체 방향과
// GPS가 잠깐 끊긴 동안의 회전을 담당한다.
#define GPS_MOTION_HEADING_TIMEOUT_MS 2000UL
#define VEHICLE_BODY_HEADING_TIMEOUT_MS 5000UL
#define VEHICLE_IMU_FRESH_TIMEOUT_MS 500UL
#define VEHICLE_BODY_BOOTSTRAP_SPEED_MPS 0.70f
#define VEHICLE_BODY_GPS_CORRECTION_ALPHA 0.12f
#define VEHICLE_DRIVE_MODE_CONFIRM_COUNT 3

#define CAR_MAG_CENTER_X_UT   9.1125f
#define CAR_MAG_CENTER_Y_UT (-27.4875f)
#define CAR_MAG_CENTER_Z_UT  (-2.41875f)

#define CAR_MAG_AXIS_A_X    (-3.225f)
#define CAR_MAG_AXIS_A_Y     30.975f
#define CAR_MAG_AXIS_A_Z    (-3.565f)

#define CAR_MAG_AXIS_90_X    30.075f
#define CAR_MAG_AXIS_90_Y     5.325f
#define CAR_MAG_AXIS_90_Z    (-0.825f)

// car_16 전진, car_17 후진, car_18 우회전으로 맞춘 진북 기준 오프셋.
// 실측상 우회전 때 모델 상대각이 감소하므로 offset-relative를 사용한다.
#define CAR_MAG_HEADING_OFFSET_DEG 116.8f

#define CAR_NEUTRAL_AX (-0.44f)
#define CAR_NEUTRAL_AY   0.48f
#define CAR_NEUTRAL_AZ   9.68f

#define CAR_GYRO_BIAS_X_DPS   0.8f
#define CAR_GYRO_BIAS_Y_DPS (-0.1f)
#define CAR_GYRO_BIAS_Z_DPS (-0.5f)
#define CAR_GYRO_YAW_DEADBAND_DPS 3.0f

#define CAR_HEADING_ACCEL_MIN_MPS2 7.0f
#define CAR_HEADING_ACCEL_MAX_MPS2 13.0f
#define CAR_HEADING_GYRO_MAX_DPS 45.0f
#define CAR_HEADING_POSE_COS_MIN 0.96592583f  // cos(15도)
#define CAR_MAG_MODEL_RESIDUAL_MAX_UT 12.0f
#define CAR_MAG_MODEL_RADIUS_MIN 0.55f
#define CAR_MAG_MODEL_RADIUS_MAX 1.50f
#define CAR_MAG_CORRECTION_TAU_S 0.80f

// 차량 진행 방향을 기준으로 좌우 몇 도까지 전방으로 볼 것인지 설정.
#define FORWARD_CONE_HALF_ANGLE_DEG 45.0f

// TTC 계산에 사용할 최소 접근속도와 차량 속도.
#define MIN_TTC_CLOSING_SPEED_MPS 0.3f
#define MIN_TTC_VEHICLE_SPEED_MPS 0.70f

// 위험 상승은 빠르게, 위험 해제는 천천히 확정.
#define RISK_ESCALATE_CONFIRM_COUNT 3
#define RISK_CLEAR_CONFIRM_COUNT 12

// GPS 거리 변화가 너무 짧은 주기로 계산되지 않도록 제한.
#define TTC_SAMPLE_INTERVAL_MS 500UL

// 접근속도 저역통과 필터. 클수록 부드럽지만 반응은 느려진다.
#define TTC_FILTER_ALPHA 0.70f

// 동시에 추적할 지팡이 노드 개수.
#define MAX_TRACKED_CANES 4

// 중력 성분을 제거한 선형가속도 크기가 이 값을 넘으면 충격으로 판단.
// 너무 민감하면 올리고, 둔하면 낮추면 됨.
// 일반 노면 실측 중 순간 최대 73.56m/s²까지 관측되어 85로 올린다.
// 2026-08-08 울퉁불퉁한 노면/배치 중 비충돌 트리거 97.08m/s² 확인.
// 실제 접근 주행 최대 피크는 42.95m/s²이었으며,
// 비충돌 트리거에 약 13% 여유를 둔다.
// BNO055는 NDOF 융합모드에서 가속도 범위가 ±4g(약 39 m/s²)로 고정되어
// 큰 충돌과 거친 노면이 모두 이 근처에서 잘린다(V4 정상 접근 주행 피크 42.95).
// 그래서 실차 충격시험 전에는 300(사실상 끔)으로 둔다. 시험 후 impact 명령으로 조정.
#define IMPACT_THRESHOLD_MPS2 300.0f
#define IMPACT_COOLDOWN_MS 5000UL

#define TRACK_CAUTION_FILE "/0001.mp3"
#define TRACK_WARNING_FILE "/0002.mp3"
#define TRACK_DANGER_FILE "/0003.mp3"
#define TRACK_IMPACT_FILE "/0004.mp3"

// =====================
// V2X 프로토콜
// 지팡이 노드와 구조체/상수가 반드시 같아야 함.
// =====================
#define V2X_MAGIC 0x56325831UL
#define V2X_VERSION 3

#define MSG_VEHICLE_STATUS 1
#define MSG_RSU_REPLY 2
#define MSG_CANE_STATUS 3
#define MSG_RISK_ALERT 4
#define MSG_UWB_RANGE 5

#define NODE_VEHICLE 0x10
#define NODE_CANE 0x20
#define NODE_RSU 0x30

#define RISK_SAFE 0
#define RISK_CAUTION 1
#define RISK_WARNING 2
#define RISK_DANGER 3

#if USE_INDOOR_RISK_DISTANCE
#define RISK_DANGER_DISTANCE_M 0.4f
#define RISK_WARNING_DISTANCE_M 0.9f
#define RISK_CAUTION_DISTANCE_M 1.8f
#define RISK_DANGER_TTC_S 0.7f
#define RISK_WARNING_TTC_S 1.5f
#define RISK_CAUTION_TTC_S 3.0f
#else
#define RISK_DANGER_DISTANCE_M 3.0f
#define RISK_WARNING_DISTANCE_M 5.0f
#define RISK_CAUTION_DISTANCE_M 8.0f
#define RISK_DANGER_TTC_S 1.5f
#define RISK_WARNING_TTC_S 3.0f
#define RISK_CAUTION_TTC_S 5.0f
#endif

// ===== 경로교차(CPA) 위험판정 =====
#define MIN_PREDICT_VEHICLE_SPEED_MPS 0.40f
#define MIN_PREDICT_CANE_SPEED_MPS 0.50f
#define MIN_RADIAL_CLOSING_SPEED_MPS 0.15f
// 사용자가 안전 평행 간격으로 정한 1.5m에서는 울리지 않도록
// CPA 횡방향 충돌반경을 1.2m 안쪽으로 제한한다.
#define CPA_DANGER_DISTANCE_M 0.5f
#define CPA_WARNING_DISTANCE_M 0.8f
#define CPA_CAUTION_DISTANCE_M 1.2f
#define CPA_PREDICTION_HORIZON_S 5.0f
// RSSI/UWB 결합 전에는 GPS만으로 "방향 무관 즉시 경고"하지 않는다.
#define EMERGENCY_DISTANCE_M 0.2f

// 2026-08-12 재시험에서 네 평행 로그는 -72dBm 미만이거나 후진이었고,
// 정면 접근은 전진 중 -72dBm 이상 + GPS 방위오차 70도 안으로 분리됐다.
// 독립 GPS 상대좌표가 20m 이상 틀어진 경우에도 주의 경보를 살리는
// 근거리 정면접근 보조 조건이다. RSSI 특성상 이 경로는 CAUTION만 낸다.
#define RISK_RSSI_GATE_DBM (-72.0f)
#define DIRECT_APPROACH_CONE_HALF_ANGLE_DEG 70.0f

// 지팡이 노드의 GPS fallback 좌표와 같아야 함.
#define CANE_FIXED_LAT 37.000000
#define CANE_FIXED_LNG 127.000000

// =====================
// 실시간 튜닝 파라미터 (뷰어 입력창 / USB 시리얼에서 변경 가능)
// 초기값은 위의 #define을 그대로 사용한다.
// =====================
float cfgGpsFilterAlpha = GPS_FILTER_ALPHA;
float cfgGpsFilterBeta = GPS_FILTER_BETA;
float cfgGpsOutlierBaseM = GPS_OUTLIER_BASE_M;
float cfgGpsMaxHdop = GPS_MAX_HDOP;
uint32_t cfgGpsMinSatellites = GPS_MIN_SATELLITES;
uint32_t cfgGpsPredictionMaxMs = GPS_PREDICTION_MAX_MS;
uint32_t cfgGpsFixMaxAgeMs = GPS_FIX_MAX_AGE_MS;
float cfgGpsMaxSpeed = GPS_NODE_MAX_SPEED_MPS;
float cfgGpsStationarySpeed = GPS_STATIONARY_SPEED_MPS;
float cfgGpsStationaryAlpha = GPS_STATIONARY_ALPHA;
float cfgGpsStationaryBeta = GPS_STATIONARY_BETA;
float cfgMinHeadingSpeed = MIN_VALID_HEADING_SPEED_MPS;
float cfgCpaDangerM = CPA_DANGER_DISTANCE_M;
float cfgCpaWarningM = CPA_WARNING_DISTANCE_M;
float cfgCpaCautionM = CPA_CAUTION_DISTANCE_M;
float cfgCpaHorizonS = CPA_PREDICTION_HORIZON_S;
float cfgEmergencyM = EMERGENCY_DISTANCE_M;
float cfgMinPredictVehicleSpeed = MIN_PREDICT_VEHICLE_SPEED_MPS;
float cfgMinPredictCaneSpeed = MIN_PREDICT_CANE_SPEED_MPS;
float cfgMinClosingSpeed = MIN_RADIAL_CLOSING_SPEED_MPS;
float cfgApproachConeDeg = DIRECT_APPROACH_CONE_HALF_ANGLE_DEG;
float cfgForwardConeDeg = FORWARD_CONE_HALF_ANGLE_DEG;
uint32_t cfgRiskEscalateCount = RISK_ESCALATE_CONFIRM_COUNT;
uint32_t cfgRiskClearCount = RISK_CLEAR_CONFIRM_COUNT;
float cfgRssiGateDbm = RISK_RSSI_GATE_DBM;
float cfgRssiAlpha = CANE_RSSI_FILTER_ALPHA;
float cfgImpactThreshold = IMPACT_THRESHOLD_MPS2;
uint32_t cfgDfplayerVolume = DFPLAYER_VOLUME;
uint32_t cfgTelemetryIntervalMs = UDP_TELEMETRY_INTERVAL_MS;
uint32_t cfgLogMode = 0;  // 0=필수값만, 1=V4 전체 진단값
float cfgUwbOffsetM = 0.0f;
float cfgUwbFilterAlpha = 0.35f;
uint32_t cfgUwbTimeoutMs = UWB_FRESH_TIMEOUT_MS;
// 실물 검증 전에 기존 경고를 망치지 않도록 기본 0.
uint32_t cfgUwbRiskEnabled = 0;
// UWB 각도(AoA)를 '유효'로 볼 최소 신뢰도(0~100). 실물 각도시험 후 조정.
uint32_t cfgUwbAngleMinFom = 50;
// uwb front가 재서 저장하는 쉴드 장착 비뚤어짐(쉴드 기준 원시 각도, 도).
float cfgUwbAzimuthOffsetDeg = 0.0f;
// 1이면 각도 부호를 뒤집는다. 실물 시험에서 오른쪽이 -로 나오면 1로 바꿔
// '차 기준 오른쪽 +'로 맞춘다(뷰어 명령 uwbflip 1 → save).
uint32_t cfgUwbAzimuthFlip = 0;

#if USE_WEB_VIEWER
// =====================
// 아이패드/폰 웹뷰어
// 차량이 자기 로그와 지팡이 브로드캐스트 로그를 모아 브라우저에 보여주고,
// 브라우저에서 보낸 명령을 자기 자신 또는 지팡이에게 전달한다.
// =====================
WebServer webServer(WEB_VIEWER_PORT);
WiFiUDP caneLogUdp;   // 지팡이 텔레메트리(4210) 수신
WiFiUDP caneCmdUdp;   // 지팡이로 명령 전달 및 응답 수신

char webCarTelemetry[2300] = "";
char webCaneTelemetry[1900] = "";
char webReplyBuffer[700] = "";
uint32_t webCarUpdatedMs = 0;
uint32_t webCaneUpdatedMs = 0;
IPAddress caneNodeIp;
bool caneNodeIpKnown = false;

// ===WEB_PAGE_BEGIN=== (build_web_viewer.py 가 생성. 직접 고치지 말 것)
// 원본: 듀얼 시리얼 뷰어의 web_viewer.html
static const char WEB_PAGE[] PROGMEM =
"<!DOCTYPE html>\n"
"<html lang=\"ko\">\n"
"<head>\n"
"<meta charset=\"utf-8\">\n"
"<meta name=\"viewport\" content=\"width=device-width,initial-scale=1,maximum-scale=1\">\n"
"<title>V2X 듀얼 뷰어</title>\n"
"<style>\n"
":root{--bg:#f4f5f7;--card:#fff;--line:#d8dbe0;--ink:#1a1c1f;--dim:#6b7280;\n"
"      --ok:#1a7f37;--warn:#b8860b;--bad:#c62828;--accent:#1a56db;--tile:#eef0f3}\n"
"*{box-sizing:border-box;-webkit-text-size-adjust:100%}\n"
"body{margin:0;padding:10px;background:var(--bg);color:var(--ink);\n"
"     font:15px/1.45 -apple-system,\"Apple SD Gothic Neo\",sans-serif}\n"
"h1{font-size:17px;margin:0 0 8px}\n"
"h2{font-size:15px;margin:0 0 6px;display:flex;align-items:center;gap:8px;\n"
"   flex-wrap:wrap}\n"
".bar{background:var(--card);border:1px solid var(--line);border-radius:10px;\n"
"     padding:8px 10px;margin-bottom:10px;display:flex;flex-wrap:wrap;\n"
"     gap:8px;align-items:center}\n"
".grid{display:grid;grid-template-columns:1fr;gap:10px}\n"
"@media(min-width:820px){.grid{grid-template-columns:1fr 1fr}}\n"
"section{background:var(--card);border:1px solid var(--line);border-radius:10px;\n"
"        padding:10px;min-width:0}\n"
"table{width:100%;border-collapse:collapse;font-size:14px}\n"
"td{padding:3px 4px;border-bottom:1px solid #eef0f3;\n"
"   font-variant-numeric:tabular-nums}\n"
"td.k{color:var(--dim);width:44%;word-break:keep-all}\n"
"td.v{font-family:ui-monospace,Menlo,monospace;word-break:break-all}\n"
"tr.chg td.v{background:#fff6d5}\n"
"input,select,button{font:inherit;border-radius:8px;border:1px solid var(--line);\n"
"                    padding:7px 10px;background:#fff;color:var(--ink)}\n"
"input{flex:1;min-width:80px}\n"
"button{background:var(--accent);color:#fff;border-color:transparent;\n"
"       cursor:pointer;-webkit-appearance:none}\n"
"button.sub{background:#eef1f6;color:var(--ink);border-color:var(--line)}\n"
"button:active{opacity:.7}\n"
".row{display:flex;gap:6px;margin-top:8px;flex-wrap:wrap}\n"
".dot{width:9px;height:9px;border-radius:50%;background:#bbb;display:inline-block}\n"
".dot.on{background:var(--ok)}.dot.old{background:var(--warn)}\n"
".age{font-size:12px;color:var(--dim);font-weight:400}\n"
".warn{font-size:13px;color:var(--bad);font-weight:700}\n"
"pre{background:#0f1115;color:#e6e8eb;border-radius:8px;padding:8px;\n"
"    font:12px/1.4 ui-monospace,Menlo,monospace;height:160px;overflow:auto;\n"
"    margin:0;white-space:pre-wrap;word-break:break-all}\n"
".rec{color:var(--bad);font-weight:600}\n"
"a.dl{display:inline-block;background:var(--ok);color:#fff;text-decoration:none;\n"
"     padding:7px 10px;border-radius:8px;margin:4px 4px 0 0;font-size:14px}\n"
"label.chk{font-size:13px;font-weight:400;color:var(--dim);display:flex;\n"
"          align-items:center;gap:4px}\n"
"label.chk input{flex:none;min-width:0;padding:0;margin:0}\n"
"/* 요약: 큰 카드 + 상태 줄 */\n"
".cards{display:grid;grid-template-columns:repeat(4,minmax(0,1fr));gap:6px;\n"
"       margin:2px 0 6px}\n"
"@media(max-width:520px){.cards{grid-template-columns:repeat(2,minmax(0,1fr))}}\n"
".card{background:var(--tile);border-radius:8px;padding:5px 8px;min-width:0}\n"
".card .ct{font-size:12px;color:var(--dim)}\n"
".card .cv{font-size:21px;font-weight:700;line-height:1.25;white-space:nowrap;\n"
"          overflow:hidden;text-overflow:ellipsis;font-variant-numeric:tabular-nums}\n"
".card .cs{font-size:12px;color:var(--dim);min-height:17px;white-space:nowrap;\n"
"          overflow:hidden;text-overflow:ellipsis}\n"
".card.risk .ct,.card.risk .cv,.card.risk .cs{color:#fff}\n"
".card.dim .cv{color:var(--dim)}\n"
".line{display:flex;gap:6px;align-items:center;font-size:14px;padding:2px 0;\n"
"      font-variant-numeric:tabular-nums}\n"
".line b{min-width:42px;flex:none}\n"
".line.dim span{color:var(--dim)}\n"
".ldot{width:8px;height:8px;border-radius:50%;flex:none;background:transparent}\n"
".ldot.on{background:var(--ok)}.ldot.off{background:#bbb}\n"
"/* 전체 값: 묶음별로 접힘 */\n"
".grp{margin-top:8px;border-top:1px solid var(--line);padding-top:4px}\n"
"details{border-top:1px solid #eef0f3}\n"
"details:first-child{border-top:0}\n"
"summary{cursor:pointer;font-size:14px;font-weight:600;padding:4px 0}\n"
"</style>\n"
"</head>\n"
"<body>\n"
"\n"
"<h1>V2X 듀얼 뷰어 <span class=\"age\" id=\"conn\"></span></h1>\n"
"\n"
"<div class=\"bar\">\n"
"  <input id=\"recName\" placeholder=\"기록 이름 (예: 직선접근1)\">\n"
"  <button id=\"recBtn\" onclick=\"toggleRecord()\">기록 시작</button>\n"
"  <span id=\"recInfo\" class=\"age\">기록 안 함</span>\n"
"  <span style=\"flex:1\"></span>\n"
"  <span id=\"modeBtns\" style=\"display:flex;gap:6px;flex-wrap:wrap\"></span>\n"
"  <select id=\"interval\" onchange=\"restartTimer()\">\n"
"    <option value=\"200\">0.2초</option>\n"
"    <option value=\"500\" selected>0.5초</option>\n"
"    <option value=\"1000\">1초</option>\n"
"  </select>\n"
"</div>\n"
"<div id=\"dlBox\"></div>\n"
"\n"
"<div class=\"grid\">\n"
"  <section>\n"
"    <h2><span class=\"dot\" id=\"dotCar\"></span>차량<span class=\"age\" id=\"ageCar\"></span>\n"
"        <span class=\"warn\" id=\"warnCar\"></span></h2>\n"
"    <div id=\"sumCar\"></div>\n"
"    <div class=\"grp\"><div class=\"age\">전체 값 (누르면 펼쳐짐)</div>\n"
"      <div id=\"grpCar\"></div></div>\n"
"    <div class=\"row\">\n"
"      <input id=\"cmdCar\" placeholder=\"명령 (예: alpha 0.25)\"\n"
"             autocapitalize=\"off\" autocorrect=\"off\" spellcheck=\"false\">\n"
"      <button onclick=\"send('car')\">전송</button>\n"
"    </div>\n"
"    <div class=\"row\">\n"
"      <button class=\"sub\" onclick=\"quick('car','get')\">get</button>\n"
"      <button class=\"sub\" onclick=\"quick('car','help')\">help</button>\n"
"      <button class=\"sub\" onclick=\"quick('car','save')\">save</button>\n"
"      <button class=\"sub\" onclick=\"quick('car','reset')\">reset</button>\n"
"      <button class=\"sub\" onclick=\"quick('car','play 3')\">음성</button>\n"
"    </div>\n"
"    <div class=\"row\" id=\"quickCar\"></div>\n"
"  </section>\n"
"\n"
"  <section>\n"
"    <h2><span class=\"dot\" id=\"dotCane\"></span>지팡이<span class=\"age\" id=\"ageCane\"></span>\n"
"        <span class=\"warn\" id=\"warnCane\"></span></h2>\n"
"    <div id=\"sumCane\"></div>\n"
"    <div class=\"grp\"><div class=\"age\">전체 값 (누르면 펼쳐짐)</div>\n"
"      <div id=\"grpCane\"></div></div>\n"
"    <div class=\"row\">\n"
"      <input id=\"cmdCane\" placeholder=\"명령 (예: alpha 0.25)\"\n"
"             autocapitalize=\"off\" autocorrect=\"off\" spellcheck=\"false\">\n"
"      <button onclick=\"send('cane')\">전송</button>\n"
"    </div>\n"
"    <div class=\"row\">\n"
"      <button class=\"sub\" onclick=\"quick('cane','get')\">get</button>\n"
"      <button class=\"sub\" onclick=\"quick('cane','help')\">help</button>\n"
"      <button class=\"sub\" onclick=\"quick('cane','save')\">save</button>\n"
"      <button class=\"sub\" onclick=\"quick('cane','reset')\">reset</button>\n"
"      <button class=\"sub\" onclick=\"quick('cane','test 3')\">진동</button>\n"
"    </div>\n"
"    <div class=\"row\" id=\"quickCane\"></div>\n"
"  </section>\n"
"</div>\n"
"\n"
"<section style=\"margin-top:10px\">\n"
"  <h2>로그 <span class=\"age\">명령 응답·알림</span>\n"
"    <label class=\"chk\"><input type=\"checkbox\" id=\"showVals\">값 줄도 보기</label>\n"
"    <button class=\"sub\" onclick=\"paused=!paused\" id=\"pauseBtn\"\n"
"            style=\"margin-left:auto;padding:4px 9px\">일시정지</button>\n"
"    <button class=\"sub\" onclick=\"logLines=[];draw()\"\n"
"            style=\"padding:4px 9px\">지우기</button>\n"
"  </h2>\n"
"  <pre id=\"log\"></pre>\n"
"</section>\n"
"\n"
"<!-- 요약 설정: dual_serial_viewer.py 의 SUMMARY 등을 build_web_viewer.py 가 복사해 넣는다.\n"
"     여기서 직접 고치지 말고 dual_serial_viewer.py 를 고친 뒤 build_web_viewer.py 실행. -->\n"
"<script id=\"viewer-spec\" type=\"application/json\">{\"RISK_NAMES\":{\"0\":\"안전\",\"1\":\"주의\",\"2\":\"경고\",\"3\":\"위험\"},\"RISK_COLORS\":{\"0\":\"#2e9e44\",\"1\":\"#b8860b\",\"2\":\"#e8710a\",\"3\":\"#d0342c\"},\"FRESH_MS\":1500,\"STALE_SEC\":2.0,\"BOARD_MS_KEY\":\"시각ms\",\"BOOT_COUNT_KEY\":\"부팅횟수\",\"SUMMARY\":{\"차량\":{\"cards\":[{\"title\":\"위험 단계\",\"key\":\"위험\",\"risk\":true,\"sub\":{\"name\":\"원시\",\"key\":\"원시위험\"}},{\"title\":\"TTC\",\"key\":\"TTC\",\"unit\":\"s\",\"digits\":1,\"min\":0,\"max\":900,\"sub\":{\"name\":\"전방\",\"key\":\"전방여부\",\"map\":{\"1\":\"예\",\"0\":\"아니오\"}}},{\"title\":\"계산 거리\",\"key\":\"계산거리\",\"unit\":\"m\",\"digits\":2,\"min\":0,\"sub\":{\"name\":\"접근\",\"key\":\"접근속도\",\"unit\":\"m/s\",\"digits\":2}},{\"title\":\"UWB 거리\",\"key\":\"UWB보정거리\",\"unit\":\"m\",\"digits\":2,\"ok\":\"UWB유효\",\"sub\":[{\"name\":\"각도\",\"key\":\"UWB각도\",\"unit\":\"°\",\"digits\":0,\"when\":\"UWB각도유효\"},{\"name\":\"원시\",\"key\":\"UWB원시거리\",\"unit\":\"m\",\"digits\":2}]}],\"lines\":[{\"label\":\"GPS\",\"ok\":\"GPS유효\",\"bad\":\"무효\",\"parts\":[{\"name\":\"위성\",\"key\":\"GPS위성\"},{\"name\":\"HDOP\",\"key\":\"GPS_HDOP\",\"digits\":2},{\"name\":\"속도\",\"key\":\"속도\",\"unit\":\"m/s\",\"digits\":2},{\"name\":\"방향\",\"key\":\"방향\",\"unit\":\"°\",\"digits\":0},{\"key\":\"상대보정\",\"map\":{\"1\":\"영점 맞춤\",\"0\":\"영점 전\"}},{\"key\":\"상대보정중\",\"map\":{\"1\":\"영점 잡는 중\"}}]},{\"label\":\"UWB\",\"ok\":\"UWB유효\",\"bad\":\"무효\",\"parts\":[{\"key\":\"UWB보정\",\"map\":{\"1\":\"거리 보정됨\",\"0\":\"거리 보정 전\"}},{\"key\":\"UWB보정중\",\"map\":{\"1\":\"거리 보정 중\"}},{\"key\":\"UWB정면보정\",\"map\":{\"1\":\"정면 맞춤\",\"0\":\"정면 전\"}},{\"key\":\"UWB정면보정중\",\"map\":{\"1\":\"정면 맞추는 중\"}},{\"name\":\"표본\",\"key\":\"UWB정면표본\",\"unit\":\"/25\",\"when\":\"UWB정면보정중\"},{\"name\":\"각도\",\"key\":\"UWB각도\",\"unit\":\"°\",\"digits\":0,\"when\":\"UWB각도유효\"},{\"key\":\"UWB각도유효\",\"map\":{\"0\":\"각도 모름\"}},{\"name\":\"신뢰\",\"key\":\"UWB각도신뢰\",\"min\":1},{\"key\":\"UWB가림\",\"map\":{\"1\":\"가림\",\"0\":\"트임\"}},{\"name\":\"접근\",\"key\":\"UWB접근속도\",\"unit\":\"m/s\",\"digits\":2},{\"name\":\"경과\",\"key\":\"UWB경과ms\",\"unit\":\"ms\",\"digits\":0,\"min\":0},{\"name\":\"전송\",\"key\":\"UWB전송\",\"rate\":true}]},{\"label\":\"IMU\",\"ok_eq\":{\"IMU보정\":\"3/3/3/3\",\"IMU정렬\":\"1\"},\"bad\":\"보정 필요\",\"parts\":[{\"name\":\"S/G/A/M\",\"key\":\"IMU보정\"},{\"key\":\"IMU정렬\",\"map\":{\"1\":\"정렬됨\",\"0\":\"정렬 전\"}},{\"name\":\"차체\",\"key\":\"차체방향\",\"unit\":\"°\",\"digits\":0}]},{\"label\":\"RSSI\",\"fresh\":\"RSSI경과ms\",\"bad\":\"끊김\",\"parts\":[{\"key\":[\"RSSI평활\",\"RSSI원시\"],\"unit\":\"dBm\",\"digits\":0},{\"name\":\"추정\",\"key\":\"RSSI거리\",\"unit\":\"m\",\"digits\":1,\"min\":0}]},{\"label\":\"통신\",\"parts\":[{\"name\":\"송신\",\"key\":\"송신\",\"rate\":true},{\"name\":\"지팡이 수신\",\"key\":\"지팡이수신\",\"rate\":true},{\"name\":\"RSU\",\"key\":\"RSU위험경과ms\",\"scale\":0.001,\"unit\":\"s 전\",\"digits\":1,\"min\":0}]}]},\"지팡이\":{\"cards\":[{\"title\":\"위험 단계\",\"key\":\"위험\",\"risk\":true},{\"title\":\"차량 경고\",\"key\":\"차량위험\",\"risk\":true,\"age\":\"차량위험경과ms\",\"sub\":{\"name\":\"경과\",\"key\":\"차량위험경과ms\",\"scale\":0.001,\"unit\":\"s\",\"digits\":1,\"min\":0}},{\"title\":\"RSU 경고\",\"key\":\"RSU위험\",\"risk\":true,\"age\":\"RSU위험경과ms\",\"sub\":{\"name\":\"경과\",\"key\":\"RSU위험경과ms\",\"scale\":0.001,\"unit\":\"s\",\"digits\":1,\"min\":0}},{\"title\":\"UWB 거리\",\"key\":\"UWB보정거리\",\"unit\":\"m\",\"digits\":2,\"ok\":\"UWB유효\",\"sub\":{\"name\":\"원시\",\"key\":\"UWB원시거리\",\"unit\":\"m\",\"digits\":2}}],\"lines\":[{\"label\":\"GPS\",\"ok\":\"GPS유효\",\"bad\":\"무효\",\"parts\":[{\"name\":\"위성\",\"key\":\"GPS위성\"},{\"name\":\"HDOP\",\"key\":\"GPS_HDOP\",\"digits\":2},{\"name\":\"속도\",\"key\":\"속도\",\"unit\":\"m/s\",\"digits\":2},{\"name\":\"GPS 복구\",\"key\":\"GPS복구횟수\",\"unit\":\"회\",\"min\":1}]},{\"label\":\"방향\",\"ok\":\"IMU방향유효\",\"bad\":\"무효\",\"parts\":[{\"key\":\"IMU방향\",\"unit\":\"°\",\"digits\":0}]},{\"label\":\"IMU\",\"ok_eq\":{\"IMU보정\":\"3/3/3/3\",\"IMU정렬\":\"1\"},\"bad\":\"보정 필요\",\"parts\":[{\"name\":\"S/G/A/M\",\"key\":\"IMU보정\"},{\"key\":\"IMU정렬\",\"map\":{\"1\":\"정렬됨\",\"0\":\"정렬 전\"}},{\"key\":\"IMU정렬중\",\"map\":{\"1\":\"걸어서 정렬 중\"}},{\"name\":\"표본\",\"key\":\"IMU정렬표본\",\"unit\":\"/20\",\"when\":\"IMU정렬중\"}]},{\"label\":\"UWB\",\"ok\":\"UWB유효\",\"bad\":\"무효\",\"parts\":[{\"key\":\"UWB보정\",\"map\":{\"1\":\"거리 보정됨\",\"0\":\"거리 보정 전\"}},{\"name\":\"접근\",\"key\":\"UWB접근속도\",\"unit\":\"m/s\",\"digits\":2},{\"name\":\"경과\",\"key\":\"UWB경과ms\",\"unit\":\"ms\",\"digits\":0,\"min\":0},{\"name\":\"수신\",\"key\":\"UWB수신\",\"rate\":true}]},{\"label\":\"RSSI\",\"fresh\":\"RSSI경과ms\",\"bad\":\"끊김\",\"parts\":[{\"key\":[\"RSSI평활\",\"RSSI원시\"],\"unit\":\"dBm\",\"digits\":0}]},{\"label\":\"통신\",\"parts\":[{\"name\":\"송신\",\"key\":\"송신\",\"rate\":true},{\"name\":\"차량 수신\",\"key\":\"차량수신\",\"rate\":true}]}]}},\"QUICK_COMMANDS\":{\"차량\":[[\"IMU 상태\",\"imu\"],[\"IMU 저장\",\"imusave\"],[\"UWB 상태\",\"uwb status\"],[\"UWB 정면 맞추기\",\"uwb front\"]],\"지팡이\":[[\"IMU 상태\",\"imu\"],[\"IMU 저장\",\"imusave\"],[\"걸어서 방향 정렬\",\"imuwalk\"]]},\"MODE_COMMANDS\":[[\"운영 모드\",[\"logmode 0\",\"rate 500\"]],[\"상세 기록 모드\",[\"logmode 1\",\"rate 100\"]]],\"EXACT_GROUPS\":{\"속도\":\"GPS\",\"위도\":\"GPS\",\"경도\":\"GPS\",\"방향\":\"방향·IMU\",\"방향오차\":\"위험·경보\",\"송신\":\"통신\"},\"VALUE_GROUPS\":[[\"UWB\",[\"UWB\",\"uwb\"],[]],[\"RSSI\",[\"RSSI\",\"rssi\"],[]],[\"GPS\",[\"GPS\",\"gps\",\"원시위도\",\"원시경도\"],[\"GPS\",\"위성\",\"HDOP\",\"상대보정\",\"보정동쪽\",\"보정북쪽\",\"lat\",\"lng\"]],[\"방향·IMU\",[\"IMU\",\"BNO\"],[\"방향\",\"가속도\",\"자이로\",\"자력계\",\"자기모델\",\"요회전\",\"후진\",\"스윙\",\"heading\",\"yaw\"]],[\"충격\",[],[\"충격\",\"impact\"]],[\"위험·경보\",[],[\"위험\",\"TTC\",\"거리\",\"접근속도\",\"전방\",\"음성\",\"risk\",\"ttc\",\"dist\"]],[\"통신\",[],[\"송신\",\"수신\",\"전송\",\"seq\",\"lost\"]],[\"시스템\",[],[\"시각\",\"부팅\",\"리셋\",\"상태\",\"heap\",\"메모리\"]]],\"GROUP_ORDER\":[\"위험·경보\",\"UWB\",\"GPS\",\"방향·IMU\",\"RSSI\",\"통신\",\"충격\",\"시스템\",\"기타\"],\"NO_SPACE_UNITS\":[\"°\",\"%\",\"회\",\"/20\",\"/25\"]}</script>\n"
"\n"
"<script>\n"
"var SPEC = JSON.parse(document.getElementById(\"viewer-spec\").textContent);\n"
"var NODE_TITLE = {car: \"차량\", cane: \"지팡이\"};\n"
"var logLines = [], paused = false, timer = null;\n"
"var prev = {car:{}, cane:{}};\n"
"var cur = {car:{}, cane:{}};            // 최신 값 (요약 계산용)\n"
"var hist = {car:{}, cane:{}};           // 누적 횟수 기록 → 초당 증가량\n"
"var ages = {car:-1, cane:-1};\n"
"var lastMs = {car:null, cane:null}, reboots = {car:0, cane:0};\n"
"var lastBoots = {car:null, cane:null}, lastRebootAt = {car:0, cane:0};\n"
"var recording = false, recStart = 0, recName = \"\";\n"
"var recRows = {car:[], cane:[]}, recKeys = {car:[], cane:[]}, recLog = [];\n"
"\n"
"function esc(s){return String(s).replace(/[&<>]/g,function(c){\n"
"  return {'&':'&amp;','<':'&lt;','>':'&gt;'}[c];});}\n"
"\n"
"function stamp(){\n"
"  var d = new Date();\n"
"  return (\"0\"+d.getHours()).slice(-2)+\":\"+(\"0\"+d.getMinutes()).slice(-2)+\n"
"         \":\"+(\"0\"+d.getSeconds()).slice(-2);\n"
"}\n"
"\n"
"function pushLog(line){\n"
"  logLines.push(stamp()+\"  \"+line);\n"
"  if (logLines.length > 600) logLines.splice(0, 200);\n"
"  if (recording) recLog.push(stamp()+\"  \"+line);\n"
"}\n"
"\n"
"function parseSections(text){\n"
"  var out = {}, cur = null, lines = text.split(\"\\n\");\n"
"  for (var i=0;i<lines.length;i++){\n"
"    var l = lines[i];\n"
"    if (l.indexOf(\"###\") === 0){ cur = l.slice(3).trim(); out[cur] = []; continue; }\n"
"    if (cur) out[cur].push(l);\n"
"  }\n"
"  return out;\n"
"}\n"
"\n"
"function toPairs(lines){\n"
"  var pairs = [];\n"
"  for (var i=0;i<lines.length;i++){\n"
"    var p = lines[i].indexOf(\":\");\n"
"    if (p > 0) pairs.push([lines[i].slice(0,p), lines[i].slice(p+1)]);\n"
"  }\n"
"  return pairs;\n"
"}\n"
"\n"
"// ── 요약 계산 (dual_serial_viewer.py 의 format_field 등과 같은 규칙) ──\n"
"function lookup(values, key){\n"
"  var keys = (typeof key === \"string\") ? [key] : key;\n"
"  for (var i=0;i<keys.length;i++)\n"
"    if (values[keys[i]] !== undefined) return [keys[i], values[keys[i]]];\n"
"  return [null, null];\n"
"}\n"
"\n"
"function cardSubs(card){\n"
"  if (!card.sub) return [];\n"
"  return Array.isArray(card.sub) ? card.sub : [card.sub];\n"
"}\n"
"\n"
"function rateKeys(node){\n"
"  var cfg = SPEC.SUMMARY[NODE_TITLE[node]], out = [];\n"
"  if (!cfg) return out;\n"
"  var add = function(s){ if (s && s.rate) out = out.concat(\n"
"    typeof s.key === \"string\" ? [s.key] : s.key); };\n"
"  cfg.cards.forEach(function(c){ add(c); cardSubs(c).forEach(add); });\n"
"  cfg.lines.forEach(function(l){ l.parts.forEach(add); });\n"
"  return out;\n"
"}\n"
"\n"
"function addCounter(node, key, raw, t){\n"
"  var v = parseFloat(raw);\n"
"  if (isNaN(v)) return;\n"
"  var h = hist[node][key] || (hist[node][key] = []);\n"
"  if (h.length && (v < h[h.length-1][1] || t < h[h.length-1][0])) h.length = 0;\n"
"  h.push([t, v]);\n"
"  while (h.length > 2 && t - h[0][0] > 3000) h.shift();\n"
"}\n"
"\n"
"function rateOf(node, key){\n"
"  var h = hist[node][key];\n"
"  if (!h || h.length < 2) return null;\n"
"  if (ages[node] < 0 || ages[node] > SPEC.STALE_SEC*1000) return 0;\n"
"  var span = (h[h.length-1][0] - h[0][0]) / 1000;\n"
"  if (span < 0.8) return null;\n"
"  return (h[h.length-1][1] - h[0][1]) / span;\n"
"}\n"
"\n"
"function fmt(spec, node){\n"
"  if (spec.when !== undefined){\n"
"    var cond = lookup(cur[node], spec.when)[1];\n"
"    if (cond === null) return null;\n"
"    cond = String(cond).trim();\n"
"    if (cond !== \"1\" && cond !== \"true\" && cond !== \"True\") return null;\n"
"  }\n"
"  var kv = lookup(cur[node], spec.key), raw = kv[1];\n"
"  if (raw === null) return null;\n"
"  raw = String(raw).trim();\n"
"  if (spec.rate){ var r = rateOf(node, kv[0]); return r === null ? null : r.toFixed(1)+\"/s\"; }\n"
"  if (spec.map) return spec.map.hasOwnProperty(raw) ? spec.map[raw] : null;\n"
"  var text = raw;\n"
"  if (spec.digits !== undefined || spec.min !== undefined ||\n"
"      spec.max !== undefined || spec.scale !== undefined){\n"
"    var num = parseFloat(raw);\n"
"    if (isNaN(num)) return raw || null;\n"
"    if (spec.min !== undefined && num < spec.min) return null;\n"
"    if (spec.max !== undefined && num >= spec.max) return null;\n"
"    num *= (spec.scale === undefined ? 1 : spec.scale);\n"
"    text = spec.digits !== undefined ? num.toFixed(spec.digits) : String(num);\n"
"  }\n"
"  if (!text) return null;\n"
"  if (spec.unit)\n"
"    text += (SPEC.NO_SPACE_UNITS.indexOf(spec.unit) >= 0 ? \"\" : \" \") + spec.unit;\n"
"  return text;\n"
"}\n"
"\n"
"function specOk(spec, node){\n"
"  if (spec.ok_eq !== undefined){\n"
"    var result = null;\n"
"    for (var key in spec.ok_eq){\n"
"      if (!spec.ok_eq.hasOwnProperty(key)) continue;\n"
"      var got = lookup(cur[node], key)[1];\n"
"      if (got === null) continue;\n"
"      if (String(got).trim() !== spec.ok_eq[key]) return false;\n"
"      result = true;\n"
"    }\n"
"    return result;\n"
"  }\n"
"  if (spec.ok !== undefined){\n"
"    var raw = lookup(cur[node], spec.ok)[1];\n"
"    if (raw === null) return null;\n"
"    raw = String(raw).trim();\n"
"    return raw === \"1\" || raw === \"true\" || raw === \"True\";\n"
"  }\n"
"  if (spec.fresh !== undefined){\n"
"    var ms = parseFloat(lookup(cur[node], spec.fresh)[1]);\n"
"    if (isNaN(ms)) return null;\n"
"    return ms >= 0 && ms <= SPEC.FRESH_MS;\n"
"  }\n"
"  return null;\n"
"}\n"
"\n"
"function riskLevel(spec, node){\n"
"  var raw = lookup(cur[node], spec.key)[1];\n"
"  if (raw === null) return null;\n"
"  if (spec.age !== undefined){\n"
"    var age = parseFloat(lookup(cur[node], spec.age)[1]);\n"
"    if (!isNaN(age) && age < 0) return null;   // 경과 -1 = 아직 못 받음\n"
"  }\n"
"  var lv = parseInt(raw, 10);\n"
"  return isNaN(lv) ? null : lv;\n"
"}\n"
"\n"
"function renderSummary(node, stale){\n"
"  var cfg = SPEC.SUMMARY[NODE_TITLE[node]] || {cards:[], lines:[]};\n"
"  var html = \"<div class='cards'>\";\n"
"  cfg.cards.forEach(function(spec){\n"
"    var sub = \"\", cls = \"card\", style = \"\", text;\n"
"    var subs = cardSubs(spec);\n"
"    for (var i = 0; i < subs.length; i++){   // 보여 줄 수 있는 첫 칸\n"
"      var s = fmt(subs[i], node);\n"
"      if (s !== null){ sub = ((subs[i].name || \"\") + \" \" + s).trim(); break; }\n"
"    }\n"
"    if (spec.risk){\n"
"      var lv = riskLevel(spec, node);\n"
"      if (lv === null){ text = \"—\"; cls += \" dim\"; }\n"
"      else {\n"
"        text = lv + \" \" + (SPEC.RISK_NAMES[lv] || \"\");\n"
"        cls += \" risk\";\n"
"        style = \" style='background:\" +\n"
"          (stale ? \"#999999\" : (SPEC.RISK_COLORS[lv] || \"#999999\")) + \"'\";\n"
"      }\n"
"    } else {\n"
"      text = fmt(spec, node);\n"
"      if (text === null || stale || specOk(spec, node) === false) cls += \" dim\";\n"
"      if (text === null) text = \"—\";\n"
"    }\n"
"    html += \"<div class='\" + cls + \"'\" + style + \"><div class='ct'>\" +\n"
"            esc(spec.title) + \"</div><div class='cv'>\" + esc(text) +\n"
"            \"</div><div class='cs'>\" + esc(sub) + \"</div></div>\";\n"
"  });\n"
"  html += \"</div>\";\n"
"  cfg.lines.forEach(function(spec){\n"
"    var ok = specOk(spec, node), parts = [];\n"
"    if (ok === false) parts.push(spec.bad || \"무효\");\n"
"    spec.parts.forEach(function(p){\n"
"      var s = fmt(p, node);\n"
"      if (s !== null) parts.push(p.name ? p.name + \" \" + s : s);\n"
"    });\n"
"    var dot = ok === null ? \"\" : (ok && !stale ? \" on\" : \" off\");\n"
"    var dim = stale || ok === false || !parts.length;\n"
"    html += \"<div class='line\" + (dim ? \" dim\" : \"\") + \"'><span class='ldot\" +\n"
"            dot + \"'></span><b>\" + esc(spec.label) + \"</b><span>\" +\n"
"            esc(parts.length ? parts.join(\" · \") : \"—\") + \"</span></div>\";\n"
"  });\n"
"  document.getElementById(node === \"car\" ? \"sumCar\" : \"sumCane\").innerHTML = html;\n"
"\n"
"  var w = document.getElementById(node === \"car\" ? \"warnCar\" : \"warnCane\");\n"
"  if (reboots[node]){\n"
"    var reason = lookup(cur[node], \"리셋원인\")[1];\n"
"    w.textContent = \"⚠ 재부팅 \" + reboots[node] + \"회\" + (reason ? \" (\" + reason + \")\" : \"\");\n"
"  } else w.textContent = \"\";\n"
"}\n"
"\n"
"// 새로 받은 값 묶음을 요약 계산용으로 반영 (재부팅 감지·초당 증가량 포함)\n"
"function absorb(node, pairs){\n"
"  if (!pairs.length) return;\n"
"  var vals = {};\n"
"  pairs.forEach(function(p){ vals[p[0]] = p[1].trim(); });\n"
"  var ms = parseFloat(vals[SPEC.BOARD_MS_KEY]), fresh = true;\n"
"  var boots = parseInt(vals[SPEC.BOOT_COUNT_KEY], 10), note = null;\n"
"  if (!isNaN(ms)){\n"
"    if (lastMs[node] !== null && ms + 1000 < lastMs[node])\n"
"      note = SPEC.BOARD_MS_KEY + \" \" + lastMs[node] + \" → \" + ms;\n"
"    fresh = lastMs[node] === null || ms !== lastMs[node];\n"
"    lastMs[node] = ms;\n"
"  }\n"
"  if (!isNaN(boots)){\n"
"    if (lastBoots[node] !== null && boots > lastBoots[node] && !note)\n"
"      note = SPEC.BOOT_COUNT_KEY + \" \" + lastBoots[node] + \" → \" + boots;\n"
"    lastBoots[node] = boots;\n"
"  }\n"
"  // 한 번의 재부팅을 두 값이 같이 알려도 5초 안이면 한 번만 센다.\n"
"  if (note && Date.now() - lastRebootAt[node] > 5000){\n"
"    lastRebootAt[node] = Date.now();\n"
"    reboots[node]++;\n"
"    hist[node] = {};\n"
"    pushLog(\"[뷰어] \" + NODE_TITLE[node] + \" 재부팅 감지: \" + note);\n"
"  }\n"
"  cur[node] = vals;\n"
"  if (!fresh) return;   // 같은 묶음을 한 번 더 받은 것\n"
"  var t = isNaN(ms) ? Date.now() : ms;\n"
"  rateKeys(node).forEach(function(k){\n"
"    if (vals[k] !== undefined) addCounter(node, k, vals[k], t);\n"
"  });\n"
"}\n"
"\n"
"// ── 전체 값: 값 이름으로 묶음을 정한다 ──\n"
"function classify(key){\n"
"  if (SPEC.EXACT_GROUPS.hasOwnProperty(key)) return SPEC.EXACT_GROUPS[key];\n"
"  var g, i, j;\n"
"  for (i=0;i<SPEC.VALUE_GROUPS.length;i++){\n"
"    g = SPEC.VALUE_GROUPS[i];\n"
"    for (j=0;j<g[1].length;j++) if (key.indexOf(g[1][j]) === 0) return g[0];\n"
"  }\n"
"  for (i=0;i<SPEC.VALUE_GROUPS.length;i++){\n"
"    g = SPEC.VALUE_GROUPS[i];\n"
"    for (j=0;j<g[2].length;j++) if (key.indexOf(g[2][j]) >= 0) return g[0];\n"
"  }\n"
"  return \"기타\";\n"
"}\n"
"\n"
"function groupBox(node, group){\n"
"  var order = SPEC.GROUP_ORDER.indexOf(group);\n"
"  if (order < 0) order = SPEC.GROUP_ORDER.length;\n"
"  var id = \"g_\" + node + \"_\" + order;\n"
"  var el = document.getElementById(id);\n"
"  if (el) return el;\n"
"  el = document.createElement(\"details\");\n"
"  el.id = id;\n"
"  el.setAttribute(\"data-order\", order);\n"
"  el.innerHTML = \"<summary></summary><table></table>\";\n"
"  var box = document.getElementById(node === \"car\" ? \"grpCar\" : \"grpCane\");\n"
"  var before = null;\n"
"  for (var i=0;i<box.children.length;i++){\n"
"    if (parseInt(box.children[i].getAttribute(\"data-order\"), 10) > order){\n"
"      before = box.children[i]; break;\n"
"    }\n"
"  }\n"
"  box.insertBefore(el, before);\n"
"  return el;\n"
"}\n"
"\n"
"function fillGroups(node, pairs){\n"
"  var byGroup = {};\n"
"  pairs.forEach(function(p){\n"
"    var g = classify(p[0]);\n"
"    (byGroup[g] = byGroup[g] || []).push(p);\n"
"  });\n"
"  Object.keys(byGroup).forEach(function(g){\n"
"    var el = groupBox(node, g), rows = \"\";\n"
"    byGroup[g].forEach(function(p){\n"
"      var k = p[0], v = p[1];\n"
"      var chg = prev[node][k] !== undefined && prev[node][k] !== v;\n"
"      prev[node][k] = v;\n"
"      rows += \"<tr\" + (chg ? \" class='chg'\" : \"\") + \"><td class='k'>\" + esc(k) +\n"
"              \"</td><td class='v'>\" + esc(v) + \"</td></tr>\";\n"
"    });\n"
"    el.querySelector(\"summary\").textContent = g + \" (\" + byGroup[g].length + \")\";\n"
"    el.querySelector(\"table\").innerHTML = rows;\n"
"  });\n"
"}\n"
"\n"
"function markAge(dotId, ageId, ms){\n"
"  var dot = document.getElementById(dotId), age = document.getElementById(ageId);\n"
"  if (ms < 0 || ms > 60000){ dot.className = \"dot\"; age.textContent = \"수신 없음\"; return false; }\n"
"  dot.className = ms < 3000 ? \"dot on\" : \"dot old\";\n"
"  age.textContent = (ms/1000).toFixed(1)+\"초 전\";\n"
"  return true;\n"
"}\n"
"\n"
"function recordRow(node, pairs){\n"
"  if (!recording || !pairs.length) return;\n"
"  var row = {\"시각\": stamp(),\n"
"             \"경과초\": ((Date.now()-recStart)/1000).toFixed(3)};\n"
"  for (var i=0;i<pairs.length;i++){\n"
"    row[pairs[i][0]] = pairs[i][1];\n"
"    if (recKeys[node].indexOf(pairs[i][0]) < 0) recKeys[node].push(pairs[i][0]);\n"
"  }\n"
"  recRows[node].push(row);\n"
"}\n"
"\n"
"function refresh(){\n"
"  fetch(\"/data\", {cache:\"no-store\"}).then(function(r){return r.text();})\n"
"  .then(function(text){\n"
"    var s = parseSections(text);\n"
"    var meta = {};\n"
"    (s.META||[]).forEach(function(l){\n"
"      var p = l.indexOf(\":\"); if (p>0) meta[l.slice(0,p)] = parseInt(l.slice(p+1),10);\n"
"    });\n"
"\n"
"    ages.car = meta.carAge === undefined ? -1 : meta.carAge;\n"
"    ages.cane = meta.caneAge === undefined ? -1 : meta.caneAge;\n"
"    var carOk = markAge(\"dotCar\",\"ageCar\", ages.car);\n"
"    var caneOk = markAge(\"dotCane\",\"ageCane\", ages.cane);\n"
"    document.getElementById(\"conn\").textContent =\n"
"      (carOk?\"차량 O\":\"차량 X\") + \" / \" + (caneOk?\"지팡이 O\":\"지팡이 X\");\n"
"\n"
"    var carPairs = toPairs(s.CAR||[]), canePairs = toPairs(s.CANE||[]);\n"
"    absorb(\"car\", carPairs);\n"
"    absorb(\"cane\", canePairs);\n"
"    if (!paused){\n"
"      fillGroups(\"car\", carPairs);\n"
"      fillGroups(\"cane\", canePairs);\n"
"    }\n"
"    var staleMs = SPEC.STALE_SEC * 1000;\n"
"    renderSummary(\"car\", ages.car < 0 || ages.car > staleMs);\n"
"    renderSummary(\"cane\", ages.cane < 0 || ages.cane > staleMs);\n"
"    recordRow(\"car\", carPairs);\n"
"    recordRow(\"cane\", canePairs);\n"
"\n"
"    // 값 줄은 위 요약·전체 값에 나오므로 로그에는 '값 줄도 보기'일 때만.\n"
"    if (!paused && document.getElementById(\"showVals\").checked){\n"
"      if (carPairs.length) pushLog(\"[차량] \" + carPairs.map(function(p){\n"
"        return p[0]+\":\"+p[1];}).join(\" \"));\n"
"      if (canePairs.length) pushLog(\"[지팡이] \" + canePairs.map(function(p){\n"
"        return p[0]+\":\"+p[1];}).join(\" \"));\n"
"    }\n"
"    (s.REPLY||[]).forEach(function(l){ if (l.trim()) pushLog(l); });\n"
"    draw();\n"
"  })\n"
"  .catch(function(){\n"
"    document.getElementById(\"conn\").textContent = \"보드 연결 끊김\";\n"
"  });\n"
"}\n"
"\n"
"function draw(){\n"
"  var el = document.getElementById(\"log\");\n"
"  el.textContent = logLines.slice(-300).join(\"\\n\");\n"
"  if (!paused) el.scrollTop = el.scrollHeight;\n"
"  document.getElementById(\"pauseBtn\").textContent = paused ? \"재개\" : \"일시정지\";\n"
"  if (recording){\n"
"    var sec = Math.floor((Date.now()-recStart)/1000);\n"
"    document.getElementById(\"recInfo\").innerHTML =\n"
"      \"<span class='rec'>기록 중 \" + (\"0\"+Math.floor(sec/60)).slice(-2) + \":\" +\n"
"      (\"0\"+(sec%60)).slice(-2) + \" (\" +\n"
"      (recRows.car.length + recRows.cane.length) + \"행)</span>\";\n"
"  }\n"
"}\n"
"\n"
"function send(target, text){\n"
"  var el = document.getElementById(target === \"car\" ? \"cmdCar\" : \"cmdCane\");\n"
"  if (text === undefined) text = el.value.trim();\n"
"  if (!text) return;\n"
"  pushLog(\"> [\" + (target===\"car\"?\"차량\":\"지팡이\") + \"] \" + text);\n"
"  if (recording) recLog.push(stamp()+\"  > [\"+target+\"] \"+text);\n"
"  fetch(\"/cmd?target=\"+target+\"&text=\"+encodeURIComponent(text))\n"
"    .then(function(){ setTimeout(refresh, 250); });\n"
"  if (el.value) el.value = \"\";\n"
"  draw();\n"
"}\n"
"function quick(target, text){ send(target, text); }\n"
"\n"
"function toggleRecord(){\n"
"  if (!recording){\n"
"    recName = (document.getElementById(\"recName\").value || \"기록\").trim();\n"
"    recording = true; recStart = Date.now();\n"
"    recRows = {car:[], cane:[]}; recKeys = {car:[], cane:[]}; recLog = [];\n"
"    document.getElementById(\"recBtn\").textContent = \"기록 중지\";\n"
"    document.getElementById(\"dlBox\").innerHTML = \"\";\n"
"  } else {\n"
"    recording = false;\n"
"    document.getElementById(\"recBtn\").textContent = \"기록 시작\";\n"
"    document.getElementById(\"recInfo\").textContent =\n"
"      \"기록 완료 — 아래 버튼으로 저장\";\n"
"    showDownloads();\n"
"  }\n"
"}\n"
"\n"
"function toCsv(node){\n"
"  var keys = [\"시각\",\"경과초\"].concat(recKeys[node]);\n"
"  var out = \"\" + keys.join(\",\") + \"\\n\";\n"
"  for (var i=0;i<recRows[node].length;i++){\n"
"    var r = recRows[node][i], line = [];\n"
"    for (var j=0;j<keys.length;j++){\n"
"      var v = r[keys[j]] === undefined ? \"\" : String(r[keys[j]]);\n"
"      line.push(v.indexOf(\",\") >= 0 ? '\"'+v+'\"' : v);\n"
"    }\n"
"    out += line.join(\",\") + \"\\n\";\n"
"  }\n"
"  return out;\n"
"}\n"
"\n"
"function fileName(suffix){\n"
"  var d = new Date(recStart), p = function(n){return (\"0\"+n).slice(-2);};\n"
"  return recName + \"_\" + d.getFullYear() + \"-\" + p(d.getMonth()+1) + \"-\" +\n"
"         p(d.getDate()) + \"_\" + p(d.getHours()) + \"-\" + p(d.getMinutes()) +\n"
"         \"-\" + p(d.getSeconds()) + \"_\" + suffix;\n"
"}\n"
"\n"
"function makeLink(text, content, name, type){\n"
"  var blob = new Blob([content], {type:type||\"text/csv;charset=utf-8\"});\n"
"  var a = document.createElement(\"a\");\n"
"  a.className = \"dl\"; a.textContent = text;\n"
"  a.href = URL.createObjectURL(blob); a.download = name;\n"
"  return a;\n"
"}\n"
"\n"
"function showDownloads(){\n"
"  var box = document.getElementById(\"dlBox\");\n"
"  box.innerHTML = \"\";\n"
"  if (recRows.car.length)\n"
"    box.appendChild(makeLink(\"차량 CSV 저장\", toCsv(\"car\"), fileName(\"차량.csv\")));\n"
"  if (recRows.cane.length)\n"
"    box.appendChild(makeLink(\"지팡이 CSV 저장\", toCsv(\"cane\"), fileName(\"지팡이.csv\")));\n"
"  if (recLog.length)\n"
"    box.appendChild(makeLink(\"로그 저장\", recLog.join(\"\\n\"),\n"
"                             fileName(\"로그.txt\"), \"text/plain;charset=utf-8\"));\n"
"}\n"
"\n"
"function restartTimer(){\n"
"  if (timer) clearInterval(timer);\n"
"  timer = setInterval(refresh, parseInt(document.getElementById(\"interval\").value,10));\n"
"}\n"
"\n"
"document.getElementById(\"cmdCar\").addEventListener(\"keydown\", function(e){\n"
"  if (e.key === \"Enter\") send(\"car\"); });\n"
"document.getElementById(\"cmdCane\").addEventListener(\"keydown\", function(e){\n"
"  if (e.key === \"Enter\") send(\"cane\"); });\n"
"\n"
"// 빠른 명령·모드 버튼은 dual_serial_viewer.py 의 QUICK_COMMANDS·MODE_COMMANDS 와 같다.\n"
"function makeButton(label, onClick){\n"
"  var b = document.createElement(\"button\");\n"
"  b.className = \"sub\"; b.textContent = label; b.onclick = onClick;\n"
"  return b;\n"
"}\n"
"[\"car\", \"cane\"].forEach(function(node){\n"
"  var box = document.getElementById(node === \"car\" ? \"quickCar\" : \"quickCane\");\n"
"  (SPEC.QUICK_COMMANDS[NODE_TITLE[node]] || []).forEach(function(q){\n"
"    box.appendChild(makeButton(q[0], function(){ send(node, q[1]); }));\n"
"  });\n"
"});\n"
"(SPEC.MODE_COMMANDS || []).forEach(function(m){\n"
"  document.getElementById(\"modeBtns\").appendChild(makeButton(m[0], function(){\n"
"    [\"car\", \"cane\"].forEach(function(node){\n"
"      m[1].forEach(function(command){ send(node, command); });\n"
"    });\n"
"  }));\n"
"});\n"
"\n"
"refresh();\n"
"restartTimer();\n"
"</script>\n"
"</body>\n"
"</html>\n";
// ===WEB_PAGE_END===
#endif

typedef struct __attribute__((packed)) v2x_status_message {
  uint32_t magic;
  uint8_t version;
  uint8_t msg_type;
  uint8_t node_type;
  uint8_t risk_level;
  uint8_t gps_valid;
  uint8_t heading_valid;
  uint32_t node_id;
  float latitude;
  float longitude;
  float speed_mps;
  float heading_deg;
  uint32_t timestamp_ms;
  uint16_t seq_num;
  // v4 근접거리 채널: 보정된 최신 UWB가 있으면 UWB, 아니면 RSSI 추정거리.
  // RSU의 기존 rssi_dist 입력을 깨지 않고 UWB 장착 직후 바로 활용한다.
  float rssi_distance_m;
} v2x_status_message_t;

static_assert(sizeof(v2x_status_message_t) == 40,
              "vehicle/cane status packet must be 40 bytes (v4: +rssi_distance_m)");

typedef struct __attribute__((packed)) v2x_risk_message {
  uint32_t magic;
  uint8_t version;
  uint8_t msg_type;
  uint8_t node_type;
  uint8_t risk_level;
  uint8_t reserved;
  uint32_t target_id;
  uint32_t src_id;

  float distance_m;
  float closing_speed_mps;
  float ttc_s;

  uint32_t timestamp_ms;
  uint16_t seq_num;
} v2x_risk_message_t;

static_assert(sizeof(v2x_risk_message_t) == 35,
              "risk alert packet must be 35 bytes");

// UWB 상세 진단은 기존 40/35바이트 패킷을 변경하지 않고 별도로 보낸다.
// 기존 RSU가 이 패킷을 모르더라도 상태/위험 패킷은 그대로 호환된다.
typedef struct __attribute__((packed)) v2x_uwb_message {
  uint32_t magic;
  uint8_t version;
  uint8_t msg_type;
  uint8_t node_type;
  uint8_t flags;       // bit0=유효, bit1=오프셋 보정 완료
  uint32_t target_id;  // 0은 방송/대상 미지정
  uint32_t src_id;
  float raw_distance_m;
  float distance_m;
  float closing_speed_mps;
  float offset_m;
  uint32_t timestamp_ms;
  uint16_t seq_num;
} v2x_uwb_message_t;

static_assert(sizeof(v2x_uwb_message_t) == 38,
              "UWB range packet must be 38 bytes");

HardwareSerial gpsSerial(2);
HardwareSerial dfSerial(1);
TinyGPSPlus gps;
SFE_UBLOX_GNSS_SERIAL gnss;
#if IMU_CHIP_ICM20948
ICM_20948_I2C icm;
#else
Adafruit_BNO055 bno(55, BNO055_I2C_ADDRESS, &Wire);
#endif

#if USE_BT_DEBUG
BluetoothSerial SerialBT;
#endif

uint8_t broadcastMAC[] = {0xFF, 0xFF, 0xFF, 0xFF, 0xFF, 0xFF};

v2x_status_message_t txVehicleStatus;
v2x_status_message_t latestCaneStatus;
v2x_risk_message_t txRiskAlert;
v2x_uwb_message_t txUwbRange;

uint8_t latestCaneMAC[6] = {0};
bool hasCaneMAC = false;
volatile bool hasLatestCane = false;
volatile bool newCanePacket = false;

uint32_t vehicleId = 0;
uint16_t vehicleSeq = 0;
uint16_t riskSeq = 0;
uint16_t uwbSeq = 0;
uint32_t sendCount = 0;
uint32_t caneRxCount = 0;
uint32_t riskSendCount = 0;
uint32_t lastSendMs = 0;

uint32_t lastBtTelemetryMs = 0;
uint32_t lastBtCheckMs = 0;

uint32_t vehicleBootCount = 0;
esp_reset_reason_t vehicleResetReason = ESP_RST_UNKNOWN;

const char *resetReasonName(esp_reset_reason_t reason) {
  switch (reason) {
    case ESP_RST_POWERON: return "POWER_ON";
    case ESP_RST_EXT: return "EXTERNAL";
    case ESP_RST_SW: return "SOFTWARE";
    case ESP_RST_PANIC: return "PANIC";
    case ESP_RST_INT_WDT: return "INT_WATCHDOG";
    case ESP_RST_TASK_WDT: return "TASK_WATCHDOG";
    case ESP_RST_WDT: return "WATCHDOG";
    case ESP_RST_DEEPSLEEP: return "DEEP_SLEEP";
    case ESP_RST_BROWNOUT: return "BROWNOUT";
    case ESP_RST_SDIO: return "SDIO";
    case ESP_RST_UNKNOWN:
    default: return "UNKNOWN";
  }
}

void captureBootDiagnostics() {
  vehicleResetReason = esp_reset_reason();
  Preferences bootPrefs;
  if (bootPrefs.begin("v2xdiag", false)) {
    vehicleBootCount = bootPrefs.getULong("bootcnt", 0) + 1;
    bootPrefs.putULong("bootcnt", vehicleBootCount);
    bootPrefs.end();
  } else {
    vehicleBootCount = 1;
  }
}

uint32_t lastCaneRxMs = 0;
volatile uint32_t lastRsuRiskRxMs = 0;
volatile uint32_t rsuRiskRxCount = 0;
// RSU가 마지막으로 보낸 위험 단계 (lastRiskLevel은 차량 자체 판정과 섞인 최종값)
volatile uint8_t lastRsuRiskLevel = 0;
uint32_t lastSensorLogMs = 0;

typedef struct {
  bool valid;
  bool calibrated;
  bool calibrating;
  float rawDistanceM;
  float filteredDistanceM;
  float closingSpeedMps;
  float lastRssiDbm;
  uint32_t lastSampleMs;
  uint32_t sampleCount;
  uint32_t failureCount;
  float medianWindow[5];
  uint8_t medianCount;
  uint8_t medianIndex;
  float previousFilteredM;
  uint32_t previousFilteredMs;
  float calibrationKnownM;
  double calibrationRawSumM;
  uint16_t calibrationSamples;
  uint32_t calibrationStartedMs;
  // V5: Portenta UWB Shield가 잰 Stella 방향(AoA). DWM3001CDK는 각도가 없다.
  bool hasAngle;
  float azimuthDeg;       // 쉴드 정면 기준 방위각(도). 측정 범위 약 ±60°
  uint8_t azimuthFom;     // 각도 신뢰도 0~100
  uint8_t nlos;           // 0=가림 없음, 1=가림, 255=판단 불가
  uint32_t lastAngleMs;
  uint32_t angleCount;
  // UWB 정면 맞추기 상태
  bool frontCalibrated;
  bool frontCalibrating;
  uint32_t frontStartedMs;
  uint16_t frontSamples;
  uint16_t frontRejected;
  double frontSumDeg;
  double frontSumSqDeg;
} UwbRangeState;

UwbRangeState uwbRange = {};
uint32_t uwbSendCount = 0;
uint32_t uwbParseOverflowCount = 0;
bool uwbUartReady = false;

void sendUwbRangePacket();

// 지팡이 -> 차량 ESP-NOW 수신 신호 세기 진단값.
// 실제 거리 보정 전에는 거리값으로 단정하지 않고 dBm 원시/평활값을 모두 기록한다.
int8_t latestCaneRssiDbm = -127;
float filteredCaneRssiDbm = -127.0f;
bool hasCaneRssi = false;
uint32_t caneRssiSampleCount = 0;
uint32_t lastCaneRssiMs = 0;

enum RssiProximityZone : uint8_t {
  RSSI_ZONE_UNKNOWN = 0,
  RSSI_ZONE_FAR = 1,
  RSSI_ZONE_APPROACH = 2,
  RSSI_ZONE_CLOSE = 3,
  RSSI_ZONE_VERY_CLOSE = 4
};

uint8_t rssiProximityZone = RSSI_ZONE_UNKNOWN;
uint8_t rssiCandidateZone = RSSI_ZONE_UNKNOWN;
uint32_t rssiCandidateSinceMs = 0;
float rssiEstimatedDistanceM = -1.0f;

typedef struct {
  bool active;
  bool valid;
  double sumEastM;
  double sumNorthM;
  float biasEastM;
  float biasNorthM;
  uint32_t requestedMs;
  uint32_t firstSampleMs;
  uint32_t lastProgressLogMs;
  uint16_t sampleCount;
} RelativeGpsCalibration;

RelativeGpsCalibration relativeGpsCalibration = {};

double vehicleLat = 0.0;
double vehicleLng = 0.0;
float vehicleSpeed = 0.0f;
float vehicleHeading = 0.0f;
bool vehicleHeadingValid = false;
uint8_t vehicleGpsValid = 0;
bool usingDemoGps = false;

// 실제 이동 방향. GPS course가 1차 자료이고 IMU는 짧은 공백을 메운다.
float gpsMotionHeadingDeg = 0.0f;
bool gpsMotionHeadingHasFix = false;
uint32_t lastGpsMotionHeadingMs = 0;
bool vehicleDriveModeKnown = false;
bool vehicleIsReversing = false;
bool candidateReversing = false;
uint8_t driveModeCandidateCount = 0;

// 원시 GPS 값과 필터 진단값. UDP 로그에서 원시/보정 좌표를 비교한다.
double rawGpsLat = 0.0;
double rawGpsLng = 0.0;
float rawGpsHdop = 99.0f;
float rawGpsSpeedMps = 0.0f;
float rawGpsCourseDeg = 0.0f;
bool rawGpsCourseValid = false;
uint32_t rawGpsSatellites = 0;
uint32_t gpsAcceptedCount = 0;
uint32_t gpsRejectedCount = 0;
uint32_t gpsQualityRejectedCount = 0;
uint32_t gpsRelocalizedCount = 0;

typedef struct {
  bool initialized;
  double originLat;
  double originLng;
  float xM;       // 동쪽 방향 위치(m)
  float yM;       // 북쪽 방향 위치(m)
  float vxMps;    // 동쪽 방향 속도(m/s)
  float vyMps;    // 북쪽 방향 속도(m/s)
  uint32_t lastFixMs;
  uint8_t consecutiveOutliers;
  bool hasRelocationCandidate;
  float relocationX;
  float relocationY;
} GpsFilterState;

GpsFilterState gpsFilter = {};
uint32_t lastGpsMeasurementMs = 0;
float gpsObservedUpdateIntervalMs = 200.0f;
uint8_t gpsRelocalizeAfterRejects =
  GPS_RELOCALIZE_AFTER_REJECTS_5HZ;
bool gps5HzRecoveryRequested = false;
uint32_t lastGps5HzRecoveryAttemptMs = 0;

void updateObservedGpsRate(uint32_t now) {
  if (lastGpsMeasurementMs > 0) {
    uint32_t intervalMs = now - lastGpsMeasurementMs;
    if (intervalMs >= 100UL && intervalMs <= 2000UL) {
      gpsObservedUpdateIntervalMs =
        0.70f * gpsObservedUpdateIntervalMs + 0.30f * intervalMs;

      uint8_t newRejectLimit =
        gpsObservedUpdateIntervalMs > 500.0f
          ? GPS_RELOCALIZE_AFTER_REJECTS_1HZ
          : GPS_RELOCALIZE_AFTER_REJECTS_5HZ;
      gps5HzRecoveryRequested =
        newRejectLimit == GPS_RELOCALIZE_AFTER_REJECTS_1HZ;

      if (newRejectLimit != gpsRelocalizeAfterRejects) {
        gpsRelocalizeAfterRejects = newRejectLimit;
        Serial.printf(
          "[GPS] observed interval=%.0fms -> relocalize rejects=%u\n",
          gpsObservedUpdateIntervalMs,
          gpsRelocalizeAfterRejects
        );
      }
    }
  }
  lastGpsMeasurementMs = now;
}

float normalizeHeading(float headingDeg) {
  while (headingDeg < 0.0f) headingDeg += 360.0f;
  while (headingDeg >= 360.0f) headingDeg -= 360.0f;
  return headingDeg;
}

float blendHeading(float previousDeg, float measuredDeg, float alpha) {
  float difference =
    fmodf(measuredDeg - previousDeg + 540.0f, 360.0f) - 180.0f;
  return normalizeHeading(previousDeg + alpha * difference);
}

void initializeGpsFilter(double lat,
                         double lng,
                         float speedMps,
                         float courseDeg,
                         bool velocityValid,
                         uint32_t now) {
  memset(&gpsFilter, 0, sizeof(gpsFilter));
  gpsFilter.initialized = true;
  gpsFilter.originLat = lat;
  gpsFilter.originLng = lng;
  gpsFilter.lastFixMs = now;

  if (velocityValid) {
    float courseRad = courseDeg * DEG_TO_RAD;
    gpsFilter.vxMps = speedMps * sinf(courseRad);
    gpsFilter.vyMps = speedMps * cosf(courseRad);
  }
}

bool updateGpsFilter(double lat,
                     double lng,
                     float speedMps,
                     float courseDeg,
                     bool velocityValid,
                     uint32_t now) {
  if (!gpsFilter.initialized ||
      now - gpsFilter.lastFixMs > GPS_FILTER_RESET_GAP_MS) {
    initializeGpsFilter(
      lat, lng, speedMps, courseDeg, velocityValid, now
    );
    gpsAcceptedCount++;
    return true;
  }

  float dt = (now - gpsFilter.lastFixMs) / 1000.0f;
  if (dt < 0.05f) {
    return false;
  }

  float metersPerDegLat = 111132.0f;
  float metersPerDegLng =
    111320.0f * cosf((float)gpsFilter.originLat * DEG_TO_RAD);
  if (fabsf(metersPerDegLng) < 1.0f) {
    metersPerDegLng = 1.0f;
  }

  float measuredX =
    (float)((lng - gpsFilter.originLng) * metersPerDegLng);
  float measuredY =
    (float)((lat - gpsFilter.originLat) * metersPerDegLat);

  float predictedX = gpsFilter.xM + gpsFilter.vxMps * dt;
  float predictedY = gpsFilter.yM + gpsFilter.vyMps * dt;
  float residualX = measuredX - predictedX;
  float residualY = measuredY - predictedY;
  float residualM = sqrtf(
    residualX * residualX + residualY * residualY
  );

  float estimatedSpeed = sqrtf(
    gpsFilter.vxMps * gpsFilter.vxMps +
    gpsFilter.vyMps * gpsFilter.vyMps
  );
  float expectedSpeed = max(
    estimatedSpeed,
    velocityValid ? speedMps : 0.0f
  );
  expectedSpeed = constrain(
    expectedSpeed, 0.0f, cfgGpsMaxSpeed
  );

  float outlierGateM =
    cfgGpsOutlierBaseM + expectedSpeed * dt * 1.5f;

  if (residualM > outlierGateM) {
    gpsRejectedCount++;

    // 랜덤한 이상치 3개가 아니라 서로 가까운 새 좌표가 반복될 때만
    // 실제 이동/재수신 위치로 인정한다.
    float relocationDifferenceM = 0.0f;
    if (gpsFilter.hasRelocationCandidate) {
      float dx = measuredX - gpsFilter.relocationX;
      float dy = measuredY - gpsFilter.relocationY;
      relocationDifferenceM = sqrtf(dx * dx + dy * dy);
    }

    if (!gpsFilter.hasRelocationCandidate ||
        relocationDifferenceM > cfgGpsOutlierBaseM) {
      gpsFilter.hasRelocationCandidate = true;
      gpsFilter.relocationX = measuredX;
      gpsFilter.relocationY = measuredY;
      gpsFilter.consecutiveOutliers = 1;
    } else {
      gpsFilter.relocationX =
        0.5f * gpsFilter.relocationX + 0.5f * measuredX;
      gpsFilter.relocationY =
        0.5f * gpsFilter.relocationY + 0.5f * measuredY;
      gpsFilter.consecutiveOutliers++;
    }

    Serial.printf(
      "[GPS FILTER] jump rejected residual=%.1fm gate=%.1fm count=%u\n",
      residualM,
      outlierGateM,
      gpsFilter.consecutiveOutliers
    );

    // 같은 새 위치가 연속해서 들어오면 실제 이동 또는 GPS 재수신으로 판단.
    if (gpsFilter.consecutiveOutliers <
        gpsRelocalizeAfterRejects) {
      return false;
    }

    initializeGpsFilter(
      lat, lng, speedMps, courseDeg, velocityValid, now
    );
    gpsRelocalizedCount++;
    gpsAcceptedCount++;
    Serial.println("[GPS FILTER] relocalized after repeated jumps");
    return true;
  }

  gpsFilter.consecutiveOutliers = 0;
  gpsFilter.hasRelocationCandidate = false;

  bool likelyStationary =
    velocityValid && speedMps < cfgGpsStationarySpeed;

  float positionAlpha =
    likelyStationary ? cfgGpsStationaryAlpha : cfgGpsFilterAlpha;

  float velocityBeta =
    likelyStationary ? cfgGpsStationaryBeta : cfgGpsFilterBeta;

  gpsFilter.xM = predictedX + positionAlpha * residualX;
  gpsFilter.yM = predictedY + positionAlpha * residualY;
  gpsFilter.vxMps += velocityBeta * residualX / dt;
  gpsFilter.vyMps += velocityBeta * residualY / dt;

  // GPS가 제공한 speed/course도 약하게 섞어 이동 시 지연을 줄인다.
  if (velocityValid) {
    float courseRad = courseDeg * DEG_TO_RAD;
    float measuredVx = speedMps * sinf(courseRad);
    float measuredVy = speedMps * cosf(courseRad);
    gpsFilter.vxMps =
      0.75f * gpsFilter.vxMps + 0.25f * measuredVx;
    gpsFilter.vyMps =
      0.75f * gpsFilter.vyMps + 0.25f * measuredVy;
  }

  float filteredSpeed = sqrtf(
    gpsFilter.vxMps * gpsFilter.vxMps +
    gpsFilter.vyMps * gpsFilter.vyMps
  );
  if (filteredSpeed > cfgGpsMaxSpeed) {
    float scale = cfgGpsMaxSpeed / filteredSpeed;
    gpsFilter.vxMps *= scale;
    gpsFilter.vyMps *= scale;
  }

  // 정지 상태에서 작은 속도 오차로 좌표가 계속 흘러가는 것을 억제.
  if (likelyStationary) {
    gpsFilter.vxMps *= 0.15f;
    gpsFilter.vyMps *= 0.15f;
  }

  gpsFilter.lastFixMs = now;
  gpsAcceptedCount++;
  return true;
}

void projectGpsPosition(uint32_t now,
                        double *outLat,
                        double *outLng) {
  float predictionMs =
    min((float)(now - gpsFilter.lastFixMs),
        (float)cfgGpsPredictionMaxMs);
  float dt = predictionMs / 1000.0f;

  float projectedX = gpsFilter.xM + gpsFilter.vxMps * dt;
  float projectedY = gpsFilter.yM + gpsFilter.vyMps * dt;
  float metersPerDegLng =
    111320.0f * cosf((float)gpsFilter.originLat * DEG_TO_RAD);
  if (fabsf(metersPerDegLng) < 1.0f) {
    metersPerDegLng = 1.0f;
  }

  *outLat = gpsFilter.originLat + projectedY / 111132.0f;
  *outLng = gpsFilter.originLng + projectedX / metersPerDegLng;
}

bool gpsQualityIsGood() {
  if (!gps.satellites.isValid() || !gps.hdop.isValid()) {
    return false;
  }

  return gps.satellites.value() >= cfgGpsMinSatellites &&
         gps.hdop.hdop() <= cfgGpsMaxHdop;
}

bool imuReady = false;
bool imuHasSample = false;
bool imuOffsetsRestored = false;
bool imuHeadingAligned = false;
uint8_t imuCalSystem = 0;
uint8_t imuCalGyro = 0;
uint8_t imuCalAccel = 0;
uint8_t imuCalMag = 0;
float imuHeadingOffsetDeg = 0.0f;
float imuRawHeadingDeg = 0.0f;
uint32_t lastImuReadAttemptMs = 0;
float previousImuRawHeadingDeg = 0.0f;
bool hasPreviousImuRawHeading = false;

bool saveImuCalibration();
void resetImuCalibration();
bool alignImuHeading(float trueHeadingDeg);
void reportImuStatus();
float accelX = 0.0f;
float accelY = 0.0f;
float accelZ = 0.0f;
float gyroX = 0.0f;
float gyroY = 0.0f;
float gyroZ = 0.0f;
float magX = 0.0f;
float magY = 0.0f;
float magZ = 0.0f;
uint32_t lastImuSampleMs = 0;

// 차량 차체 방향과 자력계 모델 진단값.
float vehicleBodyHeadingDeg = 0.0f;
bool vehicleBodyHeadingHasFix = false;
uint32_t lastVehicleMagAcceptedMs = 0;
uint32_t vehicleHeadingAcceptedCount = 0;
uint32_t vehicleHeadingRejectedCount = 0;
float vehicleHeadingAccelNorm = 0.0f;
float vehicleHeadingGyroNorm = 0.0f;
float vehicleHeadingPoseCos = 0.0f;
float vehicleMagModelResidual = 999.0f;
float vehicleMagModelRadius = 0.0f;
float vehicleYawRateDps = 0.0f;

float gravityX = 0.0f;
float gravityY = 0.0f;
float gravityZ = 9.80665f;
float linearAccelMagnitude = 0.0f;
float impactPeakSinceTelemetry = 0.0f;
float lastImpactTriggerMagnitude = 0.0f;
uint32_t lastImpactTriggerAtMs = 0;
uint32_t lastImpactMs = 0;

bool dfPlayerReady = false;
uint8_t lastAnnouncedRisk = RISK_SAFE;

uint8_t lastRiskLevel = RISK_SAFE;

// 위험 판정 안정화 상태.
uint8_t rawRiskLevel = RISK_SAFE;
uint8_t stableRiskLevel = RISK_SAFE;
uint8_t candidateRiskLevel = RISK_SAFE;
uint8_t candidateRiskCount = 0;

// 마지막 위험 계산 결과: UDP 1초 로그에 보존.
float lastCalculatedDistanceM = -1.0f;
float lastCalculatedClosingSpeedMps = 0.0f;
float lastCalculatedTtcS = 999.0f;
float lastCalculatedHeadingErrorDeg = 0.0f;
bool lastCalculatedInPath = false;

// 실제로 재생된 음성 원인을 구분하기 위한 카운터.
uint32_t riskAudioPlayCount = 0;
uint32_t impactAudioPlayCount = 0;
uint8_t lastPlayedRiskAudio = RISK_SAFE;

// 지팡이 노드마다 이전 거리와 접근속도를 따로 저장.
// 여러 지팡이의 거리 기록이 섞이는 문제를 막는다.
typedef struct {
  bool used;
  bool hasClosingSpeed;
  uint32_t nodeId;
  float prevDistanceM;
  float filteredClosingSpeed;
  uint32_t prevCalcMs;
  uint32_t lastUpdateMs;
} CaneRiskState;

// Arduino 전처리기가 이 함수의 자동 원형을 typedef보다 위에 만드는 것을 방지한다.
CaneRiskState *getCaneRiskState(uint32_t caneNodeId);

CaneRiskState caneRiskStates[MAX_TRACKED_CANES];

portMUX_TYPE caneMux = portMUX_INITIALIZER_UNLOCKED;

// =====================
// 공통 유틸리티
// =====================
uint32_t macToNodeId(const uint8_t *mac) {
  return ((uint32_t)mac[2] << 24) |
         ((uint32_t)mac[3] << 16) |
         ((uint32_t)mac[4] << 8) |
         mac[5];
}

void printMac(const uint8_t *mac) {
  for (int i = 0; i < 6; i++) {
    if (mac[i] < 16) Serial.print('0');
    Serial.print(mac[i], HEX);
    if (i < 5) Serial.print(':');
  }
}

void setupVehicleId() {
  uint8_t mac[6];
  esp_wifi_get_mac(WIFI_IF_STA, mac);
  vehicleId = macToNodeId(mac);
  Serial.print("[VEHICLE] STA MAC=");
  printMac(mac);
  Serial.printf(" node_id=%lu\n", (unsigned long)vehicleId);
}

void addPeerIfNeeded(const uint8_t *mac, const char *name) {
  if (esp_now_is_peer_exist(mac)) return;

  esp_now_peer_info_t peer = {};
  memcpy(peer.peer_addr, mac, 6);
  peer.channel = 0;
  peer.encrypt = false;

  esp_err_t result = esp_now_add_peer(&peer);
  Serial.printf("[ESP-NOW] add %s peer: %s\n",
                name,
                result == ESP_OK ? "OK" : "FAIL");
}

const char *rssiZoneName(uint8_t zone) {
  switch (zone) {
    case RSSI_ZONE_FAR: return "FAR";
    case RSSI_ZONE_APPROACH: return "APPROACH";
    case RSSI_ZONE_CLOSE: return "CLOSE";
    case RSSI_ZONE_VERY_CLOSE: return "VERY_CLOSE";
    default: return "UNKNOWN";
  }
}

uint8_t baseRssiZone(float rssiDbm) {
  if (rssiDbm >= RSSI_VERY_CLOSE_ENTER_DBM) {
    return RSSI_ZONE_VERY_CLOSE;
  }
  if (rssiDbm >= RSSI_CLOSE_ENTER_DBM) {
    return RSSI_ZONE_CLOSE;
  }
  if (rssiDbm >= RSSI_APPROACH_ENTER_DBM) {
    return RSSI_ZONE_APPROACH;
  }
  return RSSI_ZONE_FAR;
}

float estimateDistanceFromRssi(float rssiDbm) {
  float exponent =
    (RSSI_AT_1M_DBM - rssiDbm) /
    (10.0f * RSSI_PATH_LOSS_EXPONENT);
  float distanceM = powf(10.0f, exponent);
  return constrain(
    distanceM,
    RSSI_DISTANCE_MIN_M,
    RSSI_DISTANCE_MAX_M
  );
}

bool caneRssiIsFresh() {
  return hasCaneRssi &&
         lastCaneRssiMs > 0 &&
         millis() - lastCaneRssiMs <= RSSI_FRESH_TIMEOUT_MS;
}

void updateRssiProximity() {
  float rssiDbm;
  bool valid;
  uint32_t lastMs;

  portENTER_CRITICAL(&caneMux);
  rssiDbm = filteredCaneRssiDbm;
  valid = hasCaneRssi;
  lastMs = lastCaneRssiMs;
  portEXIT_CRITICAL(&caneMux);

  uint32_t now = millis();
  if (!valid || lastMs == 0 ||
      now - lastMs > RSSI_FRESH_TIMEOUT_MS) {
    rssiEstimatedDistanceM = -1.0f;
    rssiProximityZone = RSSI_ZONE_UNKNOWN;
    rssiCandidateZone = RSSI_ZONE_UNKNOWN;
    rssiCandidateSinceMs = 0;
    return;
  }

  rssiEstimatedDistanceM = estimateDistanceFromRssi(rssiDbm);

  uint8_t desiredZone = rssiProximityZone;
  if (rssiProximityZone == RSSI_ZONE_UNKNOWN) {
    desiredZone = baseRssiZone(rssiDbm);
  }
  else if (rssiProximityZone == RSSI_ZONE_FAR) {
    if (rssiDbm >= RSSI_APPROACH_ENTER_DBM) {
      desiredZone = baseRssiZone(rssiDbm);
    }
  }
  else if (rssiProximityZone == RSSI_ZONE_APPROACH) {
    if (rssiDbm >= RSSI_CLOSE_ENTER_DBM) {
      desiredZone = baseRssiZone(rssiDbm);
    } else if (rssiDbm <= RSSI_APPROACH_EXIT_DBM) {
      desiredZone = RSSI_ZONE_FAR;
    }
  }
  else if (rssiProximityZone == RSSI_ZONE_CLOSE) {
    if (rssiDbm >= RSSI_VERY_CLOSE_ENTER_DBM) {
      desiredZone = RSSI_ZONE_VERY_CLOSE;
    } else if (rssiDbm <= RSSI_CLOSE_EXIT_DBM) {
      desiredZone = baseRssiZone(rssiDbm);
    }
  }
  else if (rssiProximityZone == RSSI_ZONE_VERY_CLOSE &&
           rssiDbm <= RSSI_VERY_CLOSE_EXIT_DBM) {
    desiredZone = baseRssiZone(rssiDbm);
  }

  if (desiredZone == rssiProximityZone) {
    rssiCandidateZone = desiredZone;
    rssiCandidateSinceMs = 0;
    return;
  }

  if (desiredZone != rssiCandidateZone) {
    rssiCandidateZone = desiredZone;
    rssiCandidateSinceMs = now;
    return;
  }

  uint32_t requiredMs =
    desiredZone > rssiProximityZone
      ? RSSI_CLOSER_CONFIRM_MS
      : RSSI_FARTHER_CONFIRM_MS;

  if (rssiCandidateSinceMs > 0 &&
      now - rssiCandidateSinceMs >= requiredMs) {
    Serial.printf(
      "[RSSI ZONE] %s -> %s rssi=%.1f distance=%.1fm\n",
      rssiZoneName(rssiProximityZone),
      rssiZoneName(desiredZone),
      rssiDbm,
      rssiEstimatedDistanceM
    );
    rssiProximityZone = desiredZone;
    rssiCandidateSinceMs = 0;
  }
}

void calculateRawRelativeVector(
  const v2x_status_message_t &cane,
  float *outEastM,
  float *outNorthM
) {
  float meanLatRad =
    0.5f * ((float)vehicleLat + cane.latitude) * DEG_TO_RAD;

  *outEastM =
    (cane.longitude - (float)vehicleLng) *
    111320.0f * cosf(meanLatRad);
  *outNorthM =
    (cane.latitude - (float)vehicleLat) * 111132.0f;
}

void resetRelativeCalibrationSamples() {
  relativeGpsCalibration.sumEastM = 0.0;
  relativeGpsCalibration.sumNorthM = 0.0;
  relativeGpsCalibration.firstSampleMs = 0;
  relativeGpsCalibration.sampleCount = 0;
}

void startRelativeGpsCalibration() {
  relativeGpsCalibration.active = true;
  relativeGpsCalibration.valid = false;
  relativeGpsCalibration.requestedMs = millis();
  relativeGpsCalibration.lastProgressLogMs = 0;
  resetRelativeCalibrationSamples();
  resetAllCaneRiskStates();

  rawRiskLevel = RISK_SAFE;
  stableRiskLevel = RISK_SAFE;
  candidateRiskLevel = RISK_SAFE;
  candidateRiskCount = 0;
#if !ENABLE_RSU_RISK_INPUT
  lastRiskLevel = RISK_SAFE;
  announceRisk(RISK_SAFE);
#endif

  Serial.println(
    "[REL CAL] started: keep both GPS antennas together and still for 8s"
  );
}

void updateRelativeGpsCalibration(
  const v2x_status_message_t &cane
) {
  if (!relativeGpsCalibration.active) return;

  uint32_t now = millis();
  if (now - relativeGpsCalibration.requestedMs >
      REL_CAL_TIMEOUT_MS) {
    relativeGpsCalibration.active = false;
    resetRelativeCalibrationSamples();
    Serial.println("[REL CAL] timeout -> calibration invalid");
    return;
  }

  if (!vehicleGpsValid || !cane.gps_valid) {
    resetRelativeCalibrationSamples();
    return;
  }

  float rawEastM;
  float rawNorthM;
  calculateRawRelativeVector(cane, &rawEastM, &rawNorthM);
  if (!isfinite(rawEastM) || !isfinite(rawNorthM)) return;

  if (relativeGpsCalibration.sampleCount > 0) {
    float meanEastM =
      (float)(relativeGpsCalibration.sumEastM /
              relativeGpsCalibration.sampleCount);
    float meanNorthM =
      (float)(relativeGpsCalibration.sumNorthM /
              relativeGpsCalibration.sampleCount);
    float spreadM = hypotf(
      rawEastM - meanEastM,
      rawNorthM - meanNorthM
    );

    if (spreadM > REL_CAL_MAX_OFFSET_SPREAD_M) {
      Serial.printf(
        "[REL CAL] offset moved %.1fm -> sample window restarted\n",
        spreadM
      );
      resetRelativeCalibrationSamples();
      return;
    }
  }

  if (relativeGpsCalibration.firstSampleMs == 0) {
    relativeGpsCalibration.firstSampleMs = now;
  }

  relativeGpsCalibration.sumEastM += rawEastM;
  relativeGpsCalibration.sumNorthM += rawNorthM;
  relativeGpsCalibration.sampleCount++;

  if (relativeGpsCalibration.lastProgressLogMs == 0 ||
      now - relativeGpsCalibration.lastProgressLogMs >= 1000UL) {
    relativeGpsCalibration.lastProgressLogMs = now;
    Serial.printf(
      "[REL CAL] collecting %lus samples=%u offset=(%.1f,%.1f)m\n",
      (unsigned long)((now - relativeGpsCalibration.firstSampleMs) / 1000UL),
      relativeGpsCalibration.sampleCount,
      rawEastM,
      rawNorthM
    );
  }

  bool enoughTime =
    now - relativeGpsCalibration.firstSampleMs >=
    REL_CAL_STILL_TIME_MS;
  bool enoughSamples =
    relativeGpsCalibration.sampleCount >= REL_CAL_MIN_SAMPLES;
  if (!enoughTime || !enoughSamples) return;

  relativeGpsCalibration.biasEastM =
    (float)(relativeGpsCalibration.sumEastM /
            relativeGpsCalibration.sampleCount);
  relativeGpsCalibration.biasNorthM =
    (float)(relativeGpsCalibration.sumNorthM /
            relativeGpsCalibration.sampleCount);
  relativeGpsCalibration.valid = true;
  relativeGpsCalibration.active = false;

  Serial.printf(
    "[REL CAL] complete samples=%u bias=(%.2f,%.2f)m\n",
    relativeGpsCalibration.sampleCount,
    relativeGpsCalibration.biasEastM,
    relativeGpsCalibration.biasNorthM
  );
}


// 차량 전용 명령. 처리했으면 true를 돌려준다.
bool runDeviceCommand(const String &name, bool hasValue, float number) {
  // 숫자 한 글자만 입력하면 기존처럼 바로 음성 테스트.
  if (name.length() == 1 && name[0] >= '1' && name[0] <= '4') {
    playTestAudio((uint8_t)(name[0] - '0'));
    return true;
  }

  if (name == "play") {
    if (!hasValue) {
      cmdReply("사용법: play <1-4> (1주의 2경고 3위험 4충격)");
      return true;
    }
    int track = (int)number;
    if (track < 1 || track > 4) {
      cmdReply("play 범위는 1~4");
      return true;
    }
    playTestAudio((uint8_t)track);
    return true;
  }

  if (name == "cal" || name == "c") {
    startRelativeGpsCalibration();
    cmdReply("GPS 상대좌표 영점 보정 시작");
    return true;
  }

  if (name == "imu") {
    reportImuStatus();
    return true;
  }
  if (name == "imusave") {
    bool ok = saveImuCalibration();
#if IMU_CHIP_ICM20948
    cmdReply(ok ? "IMU 보정값 저장 완료" :
                  "IMU 저장 실패: 2초 가만히(G=3) + 공중에서 여러 방향으로 8자 돌리기(M=3) 후 다시");
#else
    cmdReply(ok ? "IMU 보정값 저장 완료" :
                  "IMU 저장 실패: 먼저 S/G/A/M 보정도를 모두 3으로 만들 것");
#endif
    return true;
  }
  if (name == "imureset") {
    resetImuCalibration();
    cmdReply("IMU 저장 보정/방향 정렬값 삭제 (재부팅 후 다시 보정)");
    return true;
  }
  if (name == "imualign") {
    if (!hasValue || number < 0.0f || number >= 360.0f) {
      cmdReply("사용법: imualign <실제 차체방향 0~359.9도>");
    } else {
      cmdReply(alignImuHeading(number) ? "IMU 차체방향 정렬/저장 완료" :
                                        "IMU 정렬 실패: 센서 샘플을 기다릴 것");
    }
    return true;
  }

  // 음량은 값을 저장한 뒤 스피커에 즉시 반영해야 한다.
  if (name == "vol") {
    int index = findTuningParam("vol");
    if (index < 0) return false;

    if (hasValue) {
      writeTuningValue((size_t)index, number);
      char command[24];
      snprintf(command, sizeof(command), "AT+VOL=%lu",
               (unsigned long)cfgDfplayerVolume);
      sendDfPlayerAtCommand(command);
    }
    reportTuningValue((size_t)index);
    return true;
  }

  return false;
}

void playTestAudio(uint8_t track) {
  if (track == 1) {
    playAudioFile(TRACK_CAUTION_FILE);
    riskAudioPlayCount++;
    lastPlayedRiskAudio = RISK_CAUTION;
  } else if (track == 2) {
    playAudioFile(TRACK_WARNING_FILE);
    riskAudioPlayCount++;
    lastPlayedRiskAudio = RISK_WARNING;
  } else if (track == 3) {
    playAudioFile(TRACK_DANGER_FILE);
    riskAudioPlayCount++;
    lastPlayedRiskAudio = RISK_DANGER;
  } else if (track == 4) {
    playAudioFile(TRACK_IMPACT_FILE);
    impactAudioPlayCount++;
  }
  cmdReply("음성 테스트 재생: %u", track);
}

// =====================
// 실시간 튜닝 명령 (USB 시리얼 + WiFi UDP 공용)
// 뷰어 입력창에서 UDP로 보낸 명령과 USB 시리얼 입력을 같은 해석기로 처리한다.
// 응답은 명령을 보낸 쪽으로 되돌려주므로 뷰어 로그에 그대로 표시된다.
//
// 값 변경은 즉시 적용되지만 기본적으로 메모리에만 남는다.
// save 명령을 쓰면 플래시(NVS)에 저장되어 전원을 껐다 켜도 유지되고,
// factory 명령으로 코드에 적힌 기본값으로 되돌릴 수 있다.
// =====================
#define CMD_UDP_PORT 4300
#define TUNING_NVS_NAMESPACE "v2xtune"
// 이 노드의 명령 태그. "@cane" 로 브로드캐스트된 지팡이 명령은 무시한다.
#define NODE_CMD_TAG "car"

WiFiUDP cmdUdp;
bool cmdUdpStarted = false;
IPAddress cmdReplyIp;
uint16_t cmdReplyPort = 0;
Preferences tuningPrefs;

enum TuningValueType {
  TUNING_FLOAT,
  TUNING_UINT32
};

typedef struct {
  const char *name;      // 명령 이름 (NVS 키로도 사용, 15자 이내)
  void *pointer;         // 실제 설정 변수
  uint8_t type;
  float minValue;
  float maxValue;
  const char *unit;      // 응답에 붙일 단위
  const char *note;      // help에 표시할 설명
} TuningParam;

TuningParam tuningParams[] = {
  {"alpha", &cfgGpsFilterAlpha, TUNING_FLOAT, 0.01f, 1.0f, "",
   "위치 보정 세기(클수록 원시GPS를 빨리 추종)"},
  {"beta", &cfgGpsFilterBeta, TUNING_FLOAT, 0.0f, 1.0f, "",
   "속도 보정 세기"},
  {"gate", &cfgGpsOutlierBaseM, TUNING_FLOAT, 0.5f, 50.0f, "m",
   "이보다 크게 튀면 이상치로 버림"},
  {"hdop", &cfgGpsMaxHdop, TUNING_FLOAT, 0.5f, 99.0f, "",
   "이보다 나쁜 HDOP은 품질 거부"},
  {"sats", &cfgGpsMinSatellites, TUNING_UINT32, 0.0f, 20.0f, "개",
   "최소 위성 수"},
  {"predict", &cfgGpsPredictionMaxMs, TUNING_UINT32, 0.0f, 5000.0f, "ms",
   "fix 없을 때 예측 최대시간"},
  {"fixage", &cfgGpsFixMaxAgeMs, TUNING_UINT32, 500.0f, 10000.0f, "ms",
   "이 시간 지난 fix는 무효"},
  {"maxspeed", &cfgGpsMaxSpeed, TUNING_FLOAT, 0.5f, 60.0f, "m/s",
   "차량 최대 속도 상한"},
  {"statspeed", &cfgGpsStationarySpeed, TUNING_FLOAT, 0.0f, 5.0f, "m/s",
   "이 속도 미만이면 정지로 간주"},
  {"statalpha", &cfgGpsStationaryAlpha, TUNING_FLOAT, 0.0f, 1.0f, "",
   "정지 중 위치 보정 세기"},
  {"statbeta", &cfgGpsStationaryBeta, TUNING_FLOAT, 0.0f, 1.0f, "",
   "정지 중 속도 보정 세기"},
  {"headspeed", &cfgMinHeadingSpeed, TUNING_FLOAT, 0.0f, 5.0f, "m/s",
   "GPS 방향을 믿을 최소 속도"},
  {"danger", &cfgCpaDangerM, TUNING_FLOAT, 0.1f, 20.0f, "m",
   "위험 판정 CPA 거리"},
  {"warn", &cfgCpaWarningM, TUNING_FLOAT, 0.1f, 30.0f, "m",
   "경고 판정 CPA 거리"},
  {"caution", &cfgCpaCautionM, TUNING_FLOAT, 0.1f, 40.0f, "m",
   "주의 판정 CPA 거리"},
  {"horizon", &cfgCpaHorizonS, TUNING_FLOAT, 0.5f, 30.0f, "s",
   "CPA 예측 시간창"},
  {"emergency", &cfgEmergencyM, TUNING_FLOAT, 0.0f, 10.0f, "m",
   "방향 무관 즉시 위험 거리"},
  {"vspeed", &cfgMinPredictVehicleSpeed, TUNING_FLOAT, 0.0f, 10.0f, "m/s",
   "CPA 계산 최소 차량속도"},
  {"cspeed", &cfgMinPredictCaneSpeed, TUNING_FLOAT, 0.0f, 10.0f, "m/s",
   "CPA 계산 최소 지팡이속도"},
  {"closing", &cfgMinClosingSpeed, TUNING_FLOAT, 0.0f, 10.0f, "m/s",
   "최소 접근속도"},
  {"cone", &cfgApproachConeDeg, TUNING_FLOAT, 5.0f, 180.0f, "도",
   "정면접근 인정 반각"},
  {"fwdcone", &cfgForwardConeDeg, TUNING_FLOAT, 5.0f, 180.0f, "도",
   "전방 판정 반각"},
  {"escalate", &cfgRiskEscalateCount, TUNING_UINT32, 1.0f, 50.0f, "회",
   "위험 상승 확정 횟수"},
  {"clearcnt", &cfgRiskClearCount, TUNING_UINT32, 1.0f, 100.0f, "회",
   "위험 해제 확정 횟수"},
  {"rssigate", &cfgRssiGateDbm, TUNING_FLOAT, -100.0f, -30.0f, "dBm",
   "이보다 약하면 근거리 보조판정 제외"},
  {"rssialpha", &cfgRssiAlpha, TUNING_FLOAT, 0.01f, 1.0f, "",
   "RSSI 평활 계수"},
  {"impact", &cfgImpactThreshold, TUNING_FLOAT, 5.0f, 300.0f, "m/s2",
   "충격 감지 임계값"},
  {"vol", &cfgDfplayerVolume, TUNING_UINT32, 0.0f, 30.0f, "",
   "스피커 음량 (즉시 반영)"},
  {"uwboffset", &cfgUwbOffsetM, TUNING_FLOAT, -5.0f, 5.0f, "m",
   "UWB 거리 보정 오프셋"},
  {"uwbalpha", &cfgUwbFilterAlpha, TUNING_FLOAT, 0.05f, 1.0f, "",
   "UWB 거리 평활 계수"},
  {"uwbtimeout", &cfgUwbTimeoutMs, TUNING_UINT32, 200.0f, 5000.0f, "ms",
   "UWB 최신값 유효 시간"},
  {"uwbrisk", &cfgUwbRiskEnabled, TUNING_UINT32, 0.0f, 1.0f, "",
   "실물 검증 후 UWB 직접 위험계산 사용(0/1)"},
  {"uwbfom", &cfgUwbAngleMinFom, TUNING_UINT32, 0.0f, 100.0f, "",
   "UWB 각도를 유효로 볼 최소 신뢰도"},
  {"uwbazoff", &cfgUwbAzimuthOffsetDeg, TUNING_FLOAT, -60.0f, 60.0f, "도",
   "UWB 정면 보정각 (uwb front가 재서 자동 저장)"},
  {"uwbflip", &cfgUwbAzimuthFlip, TUNING_UINT32, 0.0f, 1.0f, "",
   "1이면 UWB 각도 부호 반대 (차 기준 오른쪽이 +가 되게)"},
  {"rate", &cfgTelemetryIntervalMs, TUNING_UINT32, 20.0f, 5000.0f, "ms",
   "뷰어 로그 전송 주기"},
  {"logmode", &cfgLogMode, TUNING_UINT32, 0.0f, 1.0f, "",
   "0=필수값만, 1=V4 전체 진단값"},
};

const size_t tuningParamCount =
  sizeof(tuningParams) / sizeof(tuningParams[0]);

// 부팅 직후 기본값을 기억해 두고 factory 명령에서 사용한다.
float tuningDefaults[sizeof(tuningParams) / sizeof(tuningParams[0])];

void cmdReply(const char *format, ...) {
  char message[200];
  va_list args;
  va_start(args, format);
  vsnprintf(message, sizeof(message), format, args);
  va_end(args);

  Serial.print("[CMD] ");
  Serial.println(message);

#if USE_WEB_VIEWER
  webLogReply("[CMD] ", message);
#endif

  if (cmdReplyPort == 0 || !cmdUdpStarted) return;

  char line[220];
  int written = snprintf(line, sizeof(line), "[CMD] %s\n", message);
  if (written <= 0) return;

  size_t length = written < (int)sizeof(line)
                    ? (size_t)written
                    : sizeof(line) - 1;

  if (cmdUdp.beginPacket(cmdReplyIp, cmdReplyPort)) {
    cmdUdp.write((const uint8_t *)line, length);
    cmdUdp.endPacket();
  }
}

bool uwbIsFresh(uint32_t now) {
  return uwbRange.valid &&
         uwbRange.lastSampleMs > 0 &&
         now - uwbRange.lastSampleMs <= cfgUwbTimeoutMs;
}

// 각도는 최신이고, 쉴드 측정범위(±60°) 안이며, 신뢰도가 충분하고,
// 가림(NLOS) 판정이 아닐 때만 유효. 아니면 '방향 모름'으로 다룬다.
bool uwbAngleIsValid(uint32_t now) {
  return uwbRange.hasAngle &&
         uwbRange.lastAngleMs > 0 &&
         now - uwbRange.lastAngleMs <= cfgUwbTimeoutMs &&
         fabsf(uwbRange.azimuthDeg) <= 60.0f &&
         uwbRange.azimuthFom >= cfgUwbAngleMinFom &&
         uwbRange.nlos != 1;
}

// 차 정면 기준 각도(오른쪽 +). 쉴드 장착 비뚤어짐(uwbazoff)과 부호(uwbflip)를 반영한다.
// 유효 범위(±60°) 판정은 쉴드 기준 원시 각도로 한다(uwbAngleIsValid).
float uwbAzimuthCarDeg() {
  float deg = uwbRange.azimuthDeg - cfgUwbAzimuthOffsetDeg;
  return cfgUwbAzimuthFlip ? -deg : deg;
}

void resetUwbFrontSamples() {
  uwbRange.frontSamples = 0;
  uwbRange.frontSumDeg = 0.0;
  uwbRange.frontSumSqDeg = 0.0;
}

void startUwbFrontCalibration() {
  resetUwbFrontSamples();
  uwbRange.frontRejected = 0;
  uwbRange.frontCalibrating = true;
  uwbRange.frontStartedMs = millis();
  cmdReply("UWB 정면 맞추기 시작: 지팡이를 든 사람이 차 정면 2~3 m에 가만히 서 있을 것 (%u회 수집)",
           (unsigned)UWB_FRONT_REQUIRED_SAMPLES);
}

void clearUwbFrontCalibration() {
  cfgUwbAzimuthOffsetDeg = 0.0f;
  uwbRange.frontCalibrated = false;
  uwbRange.frontCalibrating = false;
  resetUwbFrontSamples();
  if (tuningPrefs.begin(TUNING_NVS_NAMESPACE, false)) {
    tuningPrefs.remove("uwbazoff");
    tuningPrefs.remove("uwbfront");
    tuningPrefs.end();
  }
}

// 새 각도가 들어올 때마다(parseUwbLine) 호출한다.
void addUwbFrontSample() {
  if (!uwbRange.frontCalibrating) return;
  if (!uwbAngleIsValid(millis())) {
    uwbRange.frontRejected++;
    return;
  }
  double deg = uwbRange.azimuthDeg;
  uwbRange.frontSumDeg += deg;
  uwbRange.frontSumSqDeg += deg * deg;
  uwbRange.frontSamples++;
  if (uwbRange.frontSamples < UWB_FRONT_REQUIRED_SAMPLES) return;

  double n = uwbRange.frontSamples;
  double mean = uwbRange.frontSumDeg / n;
  double variance = uwbRange.frontSumSqDeg / n - mean * mean;
  float spread = (float)sqrt(variance > 0.0 ? variance : 0.0);
  if (spread > UWB_FRONT_MAX_SPREAD_DEG) {
    cmdReply("UWB 정면 맞추기: 각도가 %.1f도 흔들려 다시 모음 (가만히 서 있을 것)", spread);
    resetUwbFrontSamples();
    return;
  }
  if (fabs(mean) > UWB_FRONT_MAX_OFFSET_DEG) {
    uwbRange.frontCalibrating = false;
    resetUwbFrontSamples();
    cmdReply("UWB 정면 맞추기 실패: 평균 %+.1f도라 정면이 아님 (차 정면에 서서 다시)",
             (float)mean);
    return;
  }

  cfgUwbAzimuthOffsetDeg = (float)mean;
  uwbRange.frontCalibrated = true;
  uwbRange.frontCalibrating = false;
  resetUwbFrontSamples();
  if (tuningPrefs.begin(TUNING_NVS_NAMESPACE, false)) {
    tuningPrefs.putFloat("uwbazoff", cfgUwbAzimuthOffsetDeg);
    tuningPrefs.putBool("uwbfront", true);
    tuningPrefs.end();
  } else {
    cmdReply("UWB 정면 보정값 저장 실패 (재부팅하면 사라짐)");
  }
  cmdReply("UWB 정면 맞추기 완료: 보정 %+.1f도, 흔들림 %.1f도 (자동저장)",
           cfgUwbAzimuthOffsetDeg, spread);
}

float medianUwbWindow() {
  float values[5];
  uint8_t count = uwbRange.medianCount;
  for (uint8_t i = 0; i < count; i++) values[i] = uwbRange.medianWindow[i];

  for (uint8_t i = 1; i < count; i++) {
    float value = values[i];
    int8_t j = (int8_t)i - 1;
    while (j >= 0 && values[j] > value) {
      values[j + 1] = values[j];
      j--;
    }
    values[j + 1] = value;
  }
  return count > 0 ? values[count / 2] : -1.0f;
}

void persistUwbOffset() {
  if (!tuningPrefs.begin(TUNING_NVS_NAMESPACE, false)) {
    cmdReply("UWB 보정값 저장 실패");
    return;
  }
  tuningPrefs.putFloat("uwboffset", cfgUwbOffsetM);
  tuningPrefs.putBool("uwbcal", true);
  tuningPrefs.end();
}

void finishUwbCalibration() {
  if (!uwbRange.calibrating || uwbRange.calibrationSamples == 0) return;

  float meanRawM = (float)(uwbRange.calibrationRawSumM /
                           uwbRange.calibrationSamples);
  cfgUwbOffsetM = uwbRange.calibrationKnownM - meanRawM;
  uwbRange.calibrated = true;
  uwbRange.calibrating = false;
  uwbRange.medianCount = 0;
  uwbRange.medianIndex = 0;
  uwbRange.previousFilteredMs = 0;
  persistUwbOffset();
  cmdReply("UWB 보정 완료: %u회 평균=%.3fm 기준=%.3fm 오프셋=%+.3fm (자동저장)",
           (unsigned)uwbRange.calibrationSamples,
           meanRawM,
           uwbRange.calibrationKnownM,
           cfgUwbOffsetM);
}

void acceptUwbMeasurement(float rawDistanceM, float rssiDbm) {
  if (!isfinite(rawDistanceM) ||
      rawDistanceM < UWB_MIN_DISTANCE_M ||
      rawDistanceM > UWB_MAX_DISTANCE_M) {
    uwbRange.failureCount++;
    return;
  }

  uint32_t now = millis();
  uwbRange.valid = true;
  uwbRange.rawDistanceM = rawDistanceM;
  uwbRange.lastRssiDbm = rssiDbm;
  uwbRange.lastSampleMs = now;
  uwbRange.sampleCount++;

  if (uwbRange.calibrating) {
    uwbRange.calibrationRawSumM += rawDistanceM;
    uwbRange.calibrationSamples++;
    if (uwbRange.calibrationSamples >= UWB_CAL_REQUIRED_SAMPLES) {
      finishUwbCalibration();
    }
  }

  float correctedM = rawDistanceM + cfgUwbOffsetM;
  correctedM = constrain(correctedM, UWB_MIN_DISTANCE_M, UWB_MAX_DISTANCE_M);
  uwbRange.medianWindow[uwbRange.medianIndex] = correctedM;
  uwbRange.medianIndex = (uwbRange.medianIndex + 1) % 5;
  if (uwbRange.medianCount < 5) uwbRange.medianCount++;

  float medianM = medianUwbWindow();
  float previousM = uwbRange.filteredDistanceM;
  uint32_t previousMs = uwbRange.previousFilteredMs;
  if (previousMs == 0) {
    uwbRange.filteredDistanceM = medianM;
  } else {
    uwbRange.filteredDistanceM =
      cfgUwbFilterAlpha * medianM +
      (1.0f - cfgUwbFilterAlpha) * uwbRange.filteredDistanceM;
  }

  if (previousMs > 0 && now > previousMs) {
    float dt = (now - previousMs) / 1000.0f;
    if (dt >= 0.03f && dt <= 2.0f) {
      float instantClosingMps = (previousM - uwbRange.filteredDistanceM) / dt;
      instantClosingMps = constrain(instantClosingMps, -15.0f, 15.0f);
      uwbRange.closingSpeedMps =
        0.30f * instantClosingMps +
        0.70f * uwbRange.closingSpeedMps;
    }
  }
  uwbRange.previousFilteredM = uwbRange.filteredDistanceM;
  uwbRange.previousFilteredMs = now;

  sendUwbRangePacket();
}

void parseUwbLine(char *line) {
  char *distanceField = strstr(line, "distance[cm]=");
  if (distanceField != nullptr &&
      (strstr(line, "status=\"SUCCESS\"") != nullptr ||
       strstr(line, "status=SUCCESS") != nullptr)) {
    distanceField += strlen("distance[cm]=");
    float distanceCm = strtof(distanceField, nullptr);

    float rssiDbm = NAN;
    char *rssiField = strstr(line, "RSSI[dBm]=");
    if (rssiField != nullptr) {
      rssiDbm = strtof(rssiField + strlen("RSSI[dBm]="), nullptr);
    }

    // V5 C33 브리지만 붙이는 각도 항목. 없으면(DWM3001CDK) 거리만 쓴다.
    char *azimuthField = strstr(line, "azimuth[deg]=");
    if (azimuthField != nullptr) {
      float azimuthDeg = strtof(azimuthField + strlen("azimuth[deg]="), nullptr);
      char *fomField = strstr(line, "aoa_fom=");
      char *nlosField = strstr(line, "nlos=");
      if (isfinite(azimuthDeg)) {
        uwbRange.hasAngle = true;
        uwbRange.azimuthDeg = azimuthDeg;
        uwbRange.azimuthFom = fomField != nullptr
          ? (uint8_t)constrain(atoi(fomField + strlen("aoa_fom=")), 0, 100)
          : 0;
        uwbRange.nlos = nlosField != nullptr
          ? (uint8_t)constrain(atoi(nlosField + strlen("nlos=")), 0, 255)
          : 255;
        uwbRange.lastAngleMs = millis();
        uwbRange.angleCount++;
        addUwbFrontSample();
      }
    }

    acceptUwbMeasurement(distanceCm / 100.0f, rssiDbm);
    return;
  }

  if (strstr(line, "status=\"") != nullptr &&
      strstr(line, "SUCCESS") == nullptr) {
    uwbRange.failureCount++;
  }
}

void updateUwb() {
#if USE_UWB
  static char line[256];
  static size_t length = 0;

  while (uwbUartReady && dfSerial.available() > 0) {
    char c = (char)dfSerial.read();
    if (c == '\r') continue;
    if (c == '\n') {
      if (length > 0) {
        line[length] = '\0';
        parseUwbLine(line);
        length = 0;
      }
      continue;
    }
    if (length < sizeof(line) - 1) {
      line[length++] = c;
    } else {
      length = 0;
      uwbParseOverflowCount++;
    }
  }

  if (uwbRange.calibrating &&
      millis() - uwbRange.calibrationStartedMs > UWB_CAL_TIMEOUT_MS) {
    uwbRange.calibrating = false;
    cmdReply("UWB 보정 시간초과: %u/%u회 수신 (배선/CDK ranging 상태 확인)",
             (unsigned)uwbRange.calibrationSamples,
             (unsigned)UWB_CAL_REQUIRED_SAMPLES);
  }

  if (uwbRange.frontCalibrating &&
      millis() - uwbRange.frontStartedMs > UWB_FRONT_TIMEOUT_MS) {
    uwbRange.frontCalibrating = false;
    cmdReply("UWB 정면 맞추기 시간초과: 쓸 수 있는 각도 %u/%u회, 버린 각도 %u회 (%s)",
             (unsigned)uwbRange.frontSamples,
             (unsigned)UWB_FRONT_REQUIRED_SAMPLES,
             (unsigned)uwbRange.frontRejected,
             uwbRange.frontRejected > uwbRange.frontSamples
               ? "신뢰도 낮음·가림·쉴드 ±60° 밖" : "각도가 계속 흔들림");
    resetUwbFrontSamples();
  }
#endif
}

float readTuningValue(size_t index) {
  if (tuningParams[index].type == TUNING_UINT32) {
    return (float)(*(uint32_t *)tuningParams[index].pointer);
  }
  return *(float *)tuningParams[index].pointer;
}

void writeTuningValue(size_t index, float value) {
  float clamped = constrain(value,
                            tuningParams[index].minValue,
                            tuningParams[index].maxValue);
  if (tuningParams[index].type == TUNING_UINT32) {
    *(uint32_t *)tuningParams[index].pointer = (uint32_t)(clamped + 0.5f);
  } else {
    *(float *)tuningParams[index].pointer = clamped;
  }
}

int findTuningParam(const String &name) {
  for (size_t i = 0; i < tuningParamCount; i++) {
    if (name.equals(tuningParams[i].name)) return (int)i;
  }
  return -1;
}

void captureTuningDefaults() {
  for (size_t i = 0; i < tuningParamCount; i++) {
    tuningDefaults[i] = readTuningValue(i);
  }
}

// 플래시에 저장된 값이 있으면 덮어쓴다. 부팅 시 한 번 호출한다.
void loadTuningFromFlash() {
  if (!tuningPrefs.begin(TUNING_NVS_NAMESPACE, true)) return;

  uint16_t restored = 0;
  for (size_t i = 0; i < tuningParamCount; i++) {
    if (!tuningPrefs.isKey(tuningParams[i].name)) continue;
    float saved = tuningPrefs.getFloat(tuningParams[i].name,
                                       tuningDefaults[i]);
    writeTuningValue(i, saved);
    restored++;
  }
  uwbRange.calibrated = tuningPrefs.getBool("uwbcal", false);
  uwbRange.frontCalibrated = tuningPrefs.getBool("uwbfront", false);
  tuningPrefs.end();

  if (restored > 0) {
    Serial.printf("[CMD] 플래시에서 저장된 설정 %u개 복원\n",
                  (unsigned)restored);
  }
}

void saveTuningToFlash() {
  if (!tuningPrefs.begin(TUNING_NVS_NAMESPACE, false)) {
    cmdReply("저장 실패: 플래시를 열 수 없다");
    return;
  }
  for (size_t i = 0; i < tuningParamCount; i++) {
    tuningPrefs.putFloat(tuningParams[i].name, readTuningValue(i));
  }
  tuningPrefs.putBool("uwbcal", uwbRange.calibrated);
  tuningPrefs.putBool("uwbfront", uwbRange.frontCalibrated);
  tuningPrefs.end();
  cmdReply("현재 설정 %u개를 플래시에 저장 (전원 껐다 켜도 유지)",
           (unsigned)tuningParamCount);
}

void restoreTuningDefaults() {
  for (size_t i = 0; i < tuningParamCount; i++) {
    writeTuningValue(i, tuningDefaults[i]);
  }
  if (tuningPrefs.begin(TUNING_NVS_NAMESPACE, false)) {
    tuningPrefs.clear();
    tuningPrefs.end();
  }
  uwbRange.calibrated = false;
  uwbRange.calibrating = false;
  uwbRange.frontCalibrated = false;
  uwbRange.frontCalibrating = false;
  cmdReply("코드에 적힌 기본값으로 되돌리고 플래시 저장분도 삭제");
}

void reportTuningValue(size_t index) {
  if (tuningParams[index].type == TUNING_UINT32) {
    cmdReply("%s = %lu%s", tuningParams[index].name,
             (unsigned long)(*(uint32_t *)tuningParams[index].pointer),
             tuningParams[index].unit);
  } else {
    cmdReply("%s = %.3f%s", tuningParams[index].name,
             *(float *)tuningParams[index].pointer,
             tuningParams[index].unit);
  }
}

void reportAllTuningValues() {
  for (size_t i = 0; i < tuningParamCount; i++) {
    reportTuningValue(i);
  }
}

void reportTuningHelp() {
  cmdReply("== 공통 명령 ==");
  cmdReply("get / save / load / factory / reset / help");
  cmdReply("== 값 변경: <이름> <숫자> ==");
  for (size_t i = 0; i < tuningParamCount; i++) {
    cmdReply("%-11s %.3f~%.3f%s  %s", tuningParams[i].name,
             tuningParams[i].minValue, tuningParams[i].maxValue,
             tuningParams[i].unit, tuningParams[i].note);
  }
  cmdReply("== 차량 전용 ==");
  cmdReply("play <1-4>  음성 테스트 "
           "(1주의 2경고 3위험 4충격)");
  cmdReply("cal         GPS 상대좌표 영점 보정 시작");
  cmdReply("uwb status  UWB 수신/보정 상태 확인");
  cmdReply("uwb cal <m> 알고 있는 거리에서 100회 자동보정");
  cmdReply("uwb stop    진행 중인 UWB 보정 취소");
  cmdReply("uwb reset   UWB 오프셋/보정 저장값 삭제");
  cmdReply("uwb front   차 정면에 선 사람 기준으로 각도 0° 맞추기 (처음 한 번, 자동저장)");
  cmdReply("uwb front 0 UWB 정면 보정값 삭제");
  cmdReply("imu / imusave / imureset / imualign <0~359.9>");
}

bool runUwbCommand(String line) {
  String lower = line;
  lower.toLowerCase();
  if (lower != "uwb" && !lower.startsWith("uwb ")) return false;

  String args = line.substring(3);
  args.trim();
  String sub = args;
  String value = "";
  int space = args.indexOf(' ');
  if (space > 0) {
    sub = args.substring(0, space);
    value = args.substring(space + 1);
    value.trim();
  }
  sub.toLowerCase();

  if (sub.length() == 0 || sub == "status") {
    long ageMs = uwbRange.lastSampleMs > 0
      ? (long)(millis() - uwbRange.lastSampleMs) : -1L;
    cmdReply("UWB fresh=%u raw=%.3fm filtered=%.3fm closing=%.3fm/s age=%ldms samples=%lu fail=%lu",
             uwbIsFresh(millis()) ? 1u : 0u,
             uwbRange.rawDistanceM,
             uwbRange.filteredDistanceM,
             uwbRange.closingSpeedMps,
             ageMs,
             (unsigned long)uwbRange.sampleCount,
             (unsigned long)uwbRange.failureCount);
    cmdReply("UWB calibrated=%u calibrating=%u progress=%u/%u offset=%+.3fm risk=%lu",
             uwbRange.calibrated ? 1u : 0u,
             uwbRange.calibrating ? 1u : 0u,
             (unsigned)uwbRange.calibrationSamples,
             (unsigned)UWB_CAL_REQUIRED_SAMPLES,
             cfgUwbOffsetM,
             (unsigned long)cfgUwbRiskEnabled);
    if (uwbRange.hasAngle) {
      cmdReply("UWB angle valid=%u car=%+.1fdeg raw=%+.1fdeg fom=%u nlos=%u count=%lu (minfom=%lu)",
               uwbAngleIsValid(millis()) ? 1u : 0u,
               uwbAzimuthCarDeg(),
               uwbRange.azimuthDeg,
               (unsigned)uwbRange.azimuthFom,
               (unsigned)uwbRange.nlos,
               (unsigned long)uwbRange.angleCount,
               (unsigned long)cfgUwbAngleMinFom);
    } else {
      cmdReply("UWB angle 없음 (C33 브리지가 각도를 안 보내거나 DWM3001CDK 사용 중)");
    }
    cmdReply("UWB front calibrated=%u calibrating=%u progress=%u/%u offset=%+.1fdeg flip=%lu",
             uwbRange.frontCalibrated ? 1u : 0u,
             uwbRange.frontCalibrating ? 1u : 0u,
             (unsigned)uwbRange.frontSamples,
             (unsigned)UWB_FRONT_REQUIRED_SAMPLES,
             cfgUwbAzimuthOffsetDeg,
             (unsigned long)cfgUwbAzimuthFlip);
    return true;
  }

  if (sub == "cal") {
    float knownM = value.toFloat();
    if (value.length() == 0 || knownM < 0.20f || knownM > 50.0f) {
      cmdReply("사용법: uwb cal <실제거리m>  예) uwb cal 3");
      return true;
    }
    uwbRange.calibrating = true;
    uwbRange.calibrationKnownM = knownM;
    uwbRange.calibrationRawSumM = 0.0;
    uwbRange.calibrationSamples = 0;
    uwbRange.calibrationStartedMs = millis();
    cmdReply("UWB %.3fm 자동보정 시작: 두 장치를 움직이지 말 것 (%u회 수집)",
             knownM, (unsigned)UWB_CAL_REQUIRED_SAMPLES);
    return true;
  }

  if (sub == "stop") {
    uwbRange.calibrating = false;
    uwbRange.frontCalibrating = false;
    cmdReply("UWB 보정 취소");
    return true;
  }

  if (sub == "front") {
    if (value == "0") {
      clearUwbFrontCalibration();
      cmdReply("UWB 정면 보정값 삭제 (보정 0도)");
      return true;
    }
    if (!uwbRange.hasAngle) {
      cmdReply("UWB 각도가 안 들어옴: C33 브리지 V5가 각도를 보내는지 먼저 확인");
      return true;
    }
    startUwbFrontCalibration();
    return true;
  }

  if (sub == "reset") {
    cfgUwbOffsetM = 0.0f;
    uwbRange.calibrated = false;
    uwbRange.calibrating = false;
    uwbRange.medianCount = 0;
    uwbRange.previousFilteredMs = 0;
    if (tuningPrefs.begin(TUNING_NVS_NAMESPACE, false)) {
      tuningPrefs.remove("uwboffset");
      tuningPrefs.remove("uwbcal");
      tuningPrefs.end();
    }
    cmdReply("UWB 보정값 삭제, offset=0");
    return true;
  }

  cmdReply("알 수 없는 UWB 명령: %s", sub.c_str());
  return true;
}

void runTuningCommand(String line) {
  line.trim();
  if (line.length() == 0) return;
  // 다른 노드의 응답이 되돌아온 경우는 명령으로 해석하지 않는다.
  if (line.startsWith("[CMD]") || line.startsWith(">")) return;

  if (runUwbCommand(line)) return;

  String name = line;
  String value = "";
  int space = line.indexOf(' ');
  if (space > 0) {
    name = line.substring(0, space);
    value = line.substring(space + 1);
    value.trim();
  }
  name.toLowerCase();

  bool hasValue = value.length() > 0;
  float number = hasValue ? value.toFloat() : 0.0f;

  if (name == "help") { reportTuningHelp(); return; }
  if (name == "get") { reportAllTuningValues(); return; }
  if (name == "save") { saveTuningToFlash(); return; }
  if (name == "load") { loadTuningFromFlash(); reportAllTuningValues(); return; }
  if (name == "factory") { restoreTuningDefaults(); return; }

  if (name == "reset") {
    gpsFilter.initialized = false;
    gpsFilter.consecutiveOutliers = 0;
    gpsFilter.hasRelocationCandidate = false;
    cmdReply("GPS 필터 기준점 초기화");
    return;
  }

  if (runDeviceCommand(name, hasValue, number)) return;

  int index = findTuningParam(name);
  if (index < 0) {
    cmdReply("알 수 없는 명령: %s (help 입력)", name.c_str());
    return;
  }

  if (!hasValue) {
    reportTuningValue((size_t)index);
    return;
  }

  writeTuningValue((size_t)index, number);
  reportTuningValue((size_t)index);
}

void handleUdpCommands() {
  if (!cmdUdpStarted) {

    if (cmdUdp.begin(CMD_UDP_PORT)) {
      cmdUdpStarted = true;
      Serial.printf("[CMD] UDP 명령 대기 포트=%u\n", (unsigned)CMD_UDP_PORT);
    }
    return;
  }

  for (int size = cmdUdp.parsePacket(); size > 0; size = cmdUdp.parsePacket()) {
    char buffer[160];
    int length = cmdUdp.read(buffer, sizeof(buffer) - 1);
    if (length < 0) length = 0;
    buffer[length] = '\0';

    cmdReplyIp = cmdUdp.remoteIP();
    cmdReplyPort = cmdUdp.remotePort();

    // 한 패킷에 여러 줄이 들어올 수 있으므로 줄 단위로 처리한다.
    char *context = NULL;
    for (char *token = strtok_r(buffer, "\r\n", &context);
         token != NULL;
         token = strtok_r(NULL, "\r\n", &context)) {
      char *cmd = token;
      // "@노드 <명령>" 형식이면 태그가 이 노드와 일치할 때만 처리한다.
      if (cmd[0] == '@') {
        char *space = strchr(cmd, ' ');
        if (space == NULL) continue;
        *space = '\0';
        bool mine = (strcmp(cmd + 1, NODE_CMD_TAG) == 0);
        cmd = space + 1;
        if (!mine) continue;
      }
      runTuningCommand(String(cmd));
    }
  }
}

void readSerialCommandLines() {
  static char serialBuffer[140];
  static size_t serialLength = 0;

  while (Serial.available() > 0) {
    char c = (char)Serial.read();

    if (c == '\r') continue;

    if (c == '\n') {
      serialBuffer[serialLength] = '\0';
      if (serialLength > 0) {
        cmdReplyPort = 0;  // USB로 들어온 명령의 응답은 시리얼로만 보낸다.
        runTuningCommand(String(serialBuffer));
      }
      serialLength = 0;
      continue;
    }

    if (serialLength < sizeof(serialBuffer) - 1) {
      serialBuffer[serialLength++] = c;
    } else {
      serialLength = 0;  // 너무 긴 입력은 버린다.
    }
  }
}

void handleVehicleSerialCommands() {
  // 실수로 스쳐 눌러 영점이 틀어지지 않게, 2초 넘게 누르고 있을 때만
  // 한 번 시작한다. 손을 뗐다가 다시 눌러야 다음 영점을 잡는다.
  static uint32_t buttonDownSinceMs = 0;
  static bool buttonFired = false;
  uint32_t now = millis();

  bool buttonPressed = digitalRead(REL_CAL_BUTTON_PIN) == LOW;
  if (!buttonPressed) {
    buttonDownSinceMs = 0;
    buttonFired = false;
  } else if (buttonDownSinceMs == 0) {
    buttonDownSinceMs = now;
  } else if (!buttonFired && now - buttonDownSinceMs >= 2000UL) {
    buttonFired = true;
    Serial.println("[BUTTON] 2초 누름 → GPS 상대좌표 영점 시작");
    startRelativeGpsCalibration();
  }

  readSerialCommandLines();
}

// =====================
// DFPlayer Mini
// =====================
void sendDfPlayerAtCommand(const char *command) {
#if USE_DFPLAYER
  if (!dfPlayerReady) return;
  dfSerial.print(command);
  dfSerial.print("\r\n");
  dfSerial.flush();
  Serial.printf("[DFPLAYER PRO TX] %s\n", command);
#endif
}

void setupDfPlayer() {
#if USE_DFPLAYER || USE_UWB
  // ESP32는 하드웨어 UART가 3개뿐이므로 UART1의 방향을 나눠 쓴다.
  // RX=UWB 거리 출력, TX=DFPlayer Pro 음성 명령.
  dfSerial.begin(DFPLAYER_BAUD, SERIAL_8N1,
                 USE_UWB ? UWB_RX : -1,
                 USE_DFPLAYER ? DFPLAYER_TX : -1);
  uwbUartReady = USE_UWB;
#if USE_DFPLAYER
  delay(1000);  // DFPlayer Pro 전원 안정화
  dfPlayerReady = true;
  sendDfPlayerAtCommand("AT");
  Serial.printf("[DFPLAYER PRO] TX-only ready GPIO=%d baud=%lu\n",
                DFPLAYER_TX, (unsigned long)DFPLAYER_BAUD);
#endif
#if USE_UWB
  Serial.printf("[UWB] Portenta C33 bridge RX ready GPIO=%d baud=%lu\n",
                UWB_RX, (unsigned long)UWB_BAUD);
#endif
#endif
}

void initializeDfPlayer() {
#if USE_DFPLAYER
  if (!dfPlayerReady) return;
  char volumeCommand[20];
  snprintf(volumeCommand,
           sizeof(volumeCommand),
           "AT+VOL=%u",
           (unsigned int)constrain(cfgDfplayerVolume, 0, 30));
// 재생 모드 설정
sendDfPlayerAtCommand("AT+PLAYMODE=3");
delay(200);

// 내장 스피커 앰프 켜기
sendDfPlayerAtCommand("AT+AMP=ON");
delay(200);

// 앰프를 켠 뒤 볼륨 적용
sendDfPlayerAtCommand(volumeCommand);
delay(200);

// 실제 적용된 볼륨 조회
sendDfPlayerAtCommand("AT+VOL=?");
delay(200);
#endif
}

void playAudioFile(const char *filePath) {
#if USE_DFPLAYER
  if (!dfPlayerReady) return;
  char playCommand[96];
  snprintf(playCommand,
           sizeof(playCommand),
           "AT+PLAYFILE=%s",
           filePath);
  sendDfPlayerAtCommand(playCommand);
#endif
}

void announceRisk(uint8_t risk) {
  if (risk == lastAnnouncedRisk) return;

  bool playedRiskAudio = false;

  // 안전 복귀 시에는 음원을 재생하지 않고 상태만 초기화.
  if (risk == RISK_CAUTION) {
    playAudioFile(TRACK_CAUTION_FILE);
    playedRiskAudio = true;
  }
  else if (risk == RISK_WARNING) {
    playAudioFile(TRACK_WARNING_FILE);
    playedRiskAudio = true;
  }
  else if (risk == RISK_DANGER) {
    playAudioFile(TRACK_DANGER_FILE);
    playedRiskAudio = true;
  }

  if (playedRiskAudio) {
    riskAudioPlayCount++;
    lastPlayedRiskAudio = risk;
  }

  lastAnnouncedRisk = risk;
}

// =====================
// 차량 IMU 차체방향 + GPS 실제 이동방향 융합
// =====================
float vehicleDot3(float ax, float ay, float az,
                  float bx, float by, float bz) {
  return ax * bx + ay * by + az * bz;
}

float vehicleNorm3(float x, float y, float z) {
  return sqrtf(x * x + y * y + z * z);
}

float signedHeadingDifference(float fromDeg, float toDeg) {
  return fmodf(toDeg - fromDeg + 540.0f, 360.0f) - 180.0f;
}

bool vehicleBodyHeadingIsFresh() {
  return vehicleBodyHeadingHasFix &&
         imuReady &&
         lastImuSampleMs > 0 &&
         millis() - lastImuSampleMs <=
           VEHICLE_IMU_FRESH_TIMEOUT_MS;
}

bool estimateVehicleBodyHeadingFromModel(float *outHeadingDeg) {
  vehicleHeadingAccelNorm = vehicleNorm3(accelX, accelY, accelZ);
  vehicleHeadingGyroNorm = vehicleNorm3(gyroX, gyroY, gyroZ);
  vehicleHeadingPoseCos = 1.0f;
  vehicleMagModelResidual = imuCalMag < 2 ? 999.0f : 0.0f;
  vehicleMagModelRadius = imuCalMag / 3.0f;

  // 스피커 자석이 가까운 차량은 BNO055의 순간 자력계 방향을 주축으로 쓰지
  // 않는다. 정렬값이 있고 자력계 보정도가 2 이상일 때만 느린 절대방향
  // 보정으로 사용하고, 평소 회전은 아래의 연속 heading delta(자이로 융합)를 쓴다.
  if (!imuHeadingAligned || imuCalGyro < 2 || imuCalMag < 2) return false;
  *outHeadingDeg = normalizeHeading(imuRawHeadingDeg + imuHeadingOffsetDeg);
  return isfinite(*outHeadingDeg);
}

void updateVehicleBodyHeading(uint32_t now, float dt) {
  vehicleYawRateDps = gyroZ;

  if (hasPreviousImuRawHeading && vehicleBodyHeadingHasFix) {
    float delta = signedHeadingDifference(previousImuRawHeadingDeg,
                                          imuRawHeadingDeg);
    // 100Hz에서 25도 이상 점프는 자석/버스 오류로 보고 버린다.
    if (isfinite(delta) && fabsf(delta) <= 25.0f) {
      vehicleBodyHeadingDeg = normalizeHeading(vehicleBodyHeadingDeg + delta);
    }
  }
  previousImuRawHeadingDeg = imuRawHeadingDeg;
  hasPreviousImuRawHeading = true;

  float measuredHeadingDeg = 0.0f;
  if (estimateVehicleBodyHeadingFromModel(&measuredHeadingDeg)) {
    bool previousFresh = vehicleBodyHeadingIsFresh();

    if (!previousFresh) {
      vehicleBodyHeadingDeg = measuredHeadingDeg;
    } else {
      vehicleBodyHeadingDeg = blendHeading(
        vehicleBodyHeadingDeg,
        measuredHeadingDeg,
        0.01f
      );
    }

    vehicleBodyHeadingHasFix = true;
    lastVehicleMagAcceptedMs = now;
    vehicleHeadingAcceptedCount++;
  } else {
    vehicleHeadingRejectedCount++;

    // 절대방향이 없어도 GPS로 초기화된 차체방향과 BNO055 회전 delta는 유지한다.
  }
}

void updateVehicleDriveModeFromGps(float gpsHeadingDeg) {
  // 자력계 절대방향이 유효하지 않아도 첫 확실한 전진 구간의 GPS course로
  // 차체방향을 시작한다. 이후 차체를 돌리면 자이로도 함께 회전하고,
  // 차체 그대로 후진하면 GPS course만 180도 바뀌므로 두 동작을 구분한다.
  if (!vehicleBodyHeadingIsFresh()) {
    if (!imuReady || lastImuSampleMs == 0 ||
        millis() - lastImuSampleMs > VEHICLE_IMU_FRESH_TIMEOUT_MS ||
        rawGpsSpeedMps < VEHICLE_BODY_BOOTSTRAP_SPEED_MPS) {
      return;
    }

    vehicleBodyHeadingDeg = normalizeHeading(gpsHeadingDeg);
    vehicleBodyHeadingHasFix = true;
    vehicleDriveModeKnown = true;
    vehicleIsReversing = false;
    candidateReversing = false;
    driveModeCandidateCount = VEHICLE_DRIVE_MODE_CONFIRM_COUNT;

    Serial.printf(
      "[BODY HEADING] GPS bootstrap heading=%.1f speed=%.2f\n",
      vehicleBodyHeadingDeg,
      rawGpsSpeedMps
    );
    return;
  }

  float difference = fabsf(
    signedHeadingDifference(vehicleBodyHeadingDeg, gpsHeadingDeg)
  );
  bool measuredReversing = difference > 90.0f;

  if (driveModeCandidateCount == 0 ||
      measuredReversing != candidateReversing) {
    candidateReversing = measuredReversing;
    driveModeCandidateCount = 1;
  } else if (driveModeCandidateCount < 255) {
    driveModeCandidateCount++;
  }

  if (driveModeCandidateCount >= VEHICLE_DRIVE_MODE_CONFIRM_COUNT) {
    bool modeChanged =
      !vehicleDriveModeKnown ||
      vehicleIsReversing != candidateReversing;

    vehicleIsReversing = candidateReversing;
    vehicleDriveModeKnown = true;

    float gpsBodyHeadingDeg = normalizeHeading(
      gpsHeadingDeg + (vehicleIsReversing ? 180.0f : 0.0f)
    );
    vehicleBodyHeadingDeg = blendHeading(
      vehicleBodyHeadingDeg,
      gpsBodyHeadingDeg,
      VEHICLE_BODY_GPS_CORRECTION_ALPHA
    );

    if (modeChanged) {
      Serial.printf(
        "[DRIVE MODE] %s body=%.1f gpsCourse=%.1f diff=%.1f\n",
        vehicleIsReversing ? "REVERSE" : "FORWARD",
        vehicleBodyHeadingDeg,
        gpsHeadingDeg,
        difference
      );
    }
  }
}

void updateVehiclePathHeading() {
  if (usingDemoGps) return;

  uint32_t now = millis();
  bool moving = vehicleSpeed >= cfgMinHeadingSpeed;
  bool gpsHeadingFresh =
    gpsMotionHeadingHasFix &&
    lastGpsMotionHeadingMs > 0 &&
    now - lastGpsMotionHeadingMs <= GPS_MOTION_HEADING_TIMEOUT_MS;

  if (moving && gpsHeadingFresh) {
    // 실제 경로가 살짝 휘거나 후진해도 GPS course가 그대로 반영된다.
    vehicleHeading = gpsMotionHeadingDeg;
    vehicleHeadingValid = true;
    return;
  }

  bool imuFallbackFresh =
    moving &&
    vehicleDriveModeKnown &&
    vehicleBodyHeadingIsFresh() &&
    lastGpsMotionHeadingMs > 0 &&
    now - lastGpsMotionHeadingMs <= VEHICLE_BODY_HEADING_TIMEOUT_MS;

  if (imuFallbackFresh) {
    vehicleHeading = normalizeHeading(
      vehicleBodyHeadingDeg + (vehicleIsReversing ? 180.0f : 0.0f)
    );
    vehicleHeadingValid = true;
  } else {
    vehicleHeadingValid = false;
  }
}

// =====================
// GPS
// =====================
void sendGpsUbxCommand(uint8_t msgClass,
                       uint8_t msgId,
                       const uint8_t *payload,
                       uint16_t payloadLength) {
  // 현재 사용하는 UBX 페이로드는 최대 6바이트이다.
  uint8_t packet[32];
  if (payloadLength > sizeof(packet) - 8) return;

  packet[0] = 0xB5;
  packet[1] = 0x62;
  packet[2] = msgClass;
  packet[3] = msgId;
  packet[4] = payloadLength & 0xFF;
  packet[5] = payloadLength >> 8;
  if (payloadLength > 0) {
    if (payload == nullptr) return;
    memcpy(&packet[6], payload, payloadLength);
  }

  uint8_t ckA = 0;
  uint8_t ckB = 0;
  for (uint16_t i = 2; i < 6 + payloadLength; i++) {
    ckA += packet[i];
    ckB += ckA;
  }

  packet[6 + payloadLength] = ckA;
  packet[7 + payloadLength] = ckB;
  gpsSerial.write(packet, payloadLength + 8);
  gpsSerial.flush();
}

void discardGpsSerialInput(uint32_t durationMs) {
  uint32_t startedMs = millis();
  while (millis() - startedMs < durationMs) {
    while (gpsSerial.available() > 0) gpsSerial.read();
    delay(1);
  }
}

bool waitForGpsUbxAck(uint8_t targetClass,
                      uint8_t targetId,
                      uint32_t timeoutMs) {
  const uint8_t expected[] = {
    0xB5, 0x62, 0x05, 0x01, 0x02, 0x00,
    targetClass, targetId
  };
  size_t matched = 0;
  uint32_t startedMs = millis();

  while (millis() - startedMs < timeoutMs) {
    while (gpsSerial.available() > 0) {
      uint8_t value = (uint8_t)gpsSerial.read();
      if (value == expected[matched]) {
        matched++;
        if (matched == sizeof(expected)) return true;
      } else {
        matched = value == expected[0] ? 1 : 0;
      }
    }
    delay(1);
  }
  return false;
}

bool pollGpsMeasurementRate(uint16_t &measurementRateMs,
                            uint32_t timeoutMs) {
  // CFG-RATE poll: 실제 모듈에 적용된 measRate를 다시 읽는다.
  const uint8_t expectedHeader[] = {
    0xB5, 0x62, 0x06, 0x08, 0x06, 0x00
  };
  uint8_t payloadAndChecksum[8];
  size_t matched = 0;
  size_t tailLength = 0;

  discardGpsSerialInput(30);
  sendGpsUbxCommand(0x06, 0x08, nullptr, 0);
  uint32_t startedMs = millis();

  while (millis() - startedMs < timeoutMs) {
    while (gpsSerial.available() > 0) {
      uint8_t value = (uint8_t)gpsSerial.read();
      if (matched < sizeof(expectedHeader)) {
        if (value == expectedHeader[matched]) {
          matched++;
        } else {
          matched = value == expectedHeader[0] ? 1 : 0;
        }
        continue;
      }

      payloadAndChecksum[tailLength++] = value;
      if (tailLength == sizeof(payloadAndChecksum)) {
        uint8_t ckA = 0;
        uint8_t ckB = 0;
        for (size_t i = 2; i < sizeof(expectedHeader); i++) {
          ckA += expectedHeader[i];
          ckB += ckA;
        }
        for (size_t i = 0; i < 6; i++) {
          ckA += payloadAndChecksum[i];
          ckB += ckA;
        }
        if (ckA != payloadAndChecksum[6] ||
            ckB != payloadAndChecksum[7]) {
          return false;
        }

        measurementRateMs =
          (uint16_t)payloadAndChecksum[0] |
          ((uint16_t)payloadAndChecksum[1] << 8);
        return true;
      }
    }
    delay(1);
  }
  return false;
}

bool configureMgF10FiveHz() {
  // MG-F10(NEO-F10N)은 출고 시 UART1 115200bps, UBX-only이다. M9N(KoA)도 115200(판매처 사양)이고 NMEA를 여기서 켠다.
  // 전원을 켤 때마다 RAM 계층만 설정해 플래시 수명에 영향을 주지 않는다.
  bool ok = gnss.newCfgValset(VAL_LAYER_RAM);
  ok &= gnss.addCfgValset(UBLOX_CFG_UART1OUTPROT_UBX, 1);
  ok &= gnss.addCfgValset(UBLOX_CFG_UART1OUTPROT_NMEA, 1);
  ok &= gnss.addCfgValset(UBLOX_CFG_MSGOUT_NMEA_ID_GGA_UART1, 1);
  ok &= gnss.addCfgValset(UBLOX_CFG_MSGOUT_NMEA_ID_RMC_UART1, 1);
  ok &= gnss.addCfgValset(UBLOX_CFG_MSGOUT_NMEA_ID_GLL_UART1, 0);
  ok &= gnss.addCfgValset(UBLOX_CFG_MSGOUT_NMEA_ID_GSA_UART1, 0);
  ok &= gnss.addCfgValset(UBLOX_CFG_MSGOUT_NMEA_ID_GSV_UART1, 0);
  ok &= gnss.addCfgValset(UBLOX_CFG_MSGOUT_NMEA_ID_VTG_UART1, 0);
  ok &= gnss.addCfgValset(UBLOX_CFG_MSGOUT_UBX_NAV_PVT_UART1, 0);
  ok &= gnss.addCfgValset(UBLOX_CFG_RATE_MEAS, 200);
  ok &= gnss.addCfgValset(UBLOX_CFG_RATE_NAV, 1);
  ok &= gnss.sendCfgValset(1200);
  return ok;
}

// GPS L5 위성 신호는 아직 '시험 운용(unhealthy)'으로 방송돼서 그대로는 안 쓴다.
// NEO-F10N 통합 매뉴얼 예제대로 L5를 켜고 건강상태를 L1 기준으로 덮어쓴다.
// 알 수 없는 키가 섞이면 메시지 전체가 거절되므로 5Hz 설정과 따로 보낸다.
// 신호 설정을 바꾸면 GNSS가 잠깐 재시작하므로 5Hz 설정보다 먼저 보낸다.
bool configureMgF10L5() {
  bool ok = gnss.newCfgValset(VAL_LAYER_RAM);
  ok &= gnss.addCfgValset(UBLOX_CFG_SIGNAL_GPS_L5_ENA, 1);
  ok &= gnss.addCfgValset(UBLOX_CFG_SIGNAL_GPS_L5_HEALTH_OVERRIDE, 1);
  ok &= gnss.sendCfgValset(1200);
  return ok;
}

// GPS 보드레이트 찾기: 115200(KoA·Holybro M9N, MG-F10 출고값)으로 먼저 붙고, 안 되면 u-blox 공장값 38400, 그다음 9600에서
// 찾아 GPS UART1을 115200으로 바꾼다(RAM만 — 전원을 켤 때마다 다시 함). 찾은 속도를 돌려주고, 못 찾으면 0.
const uint32_t GPS_BAUD_FALLBACK[] = {38400, 9600};

uint32_t beginGnssAnyBaud() {
  if (gnss.begin(gpsSerial, 1200)) return GPS_BAUD;
  for (uint32_t baud : GPS_BAUD_FALLBACK) {
    gpsSerial.updateBaudRate(baud);
    delay(200);
    if (!gnss.begin(gpsSerial, 1200)) continue;
    gnss.setSerialRate(GPS_BAUD, COM_PORT_UART1, VAL_LAYER_RAM, 300);  // 응답은 새 속도로 오므로 결과는 보지 않음
    delay(200);
    gpsSerial.updateBaudRate(GPS_BAUD);
    delay(200);
    return gnss.begin(gpsSerial, 1200) ? baud : 0;
  }
  gpsSerial.updateBaudRate(GPS_BAUD);
  return 0;
}

void setupGps() {
#if USE_GPS
  gpsSerial.setRxBufferSize(1024);
  gpsSerial.begin(GPS_BAUD, SERIAL_8N1, GPS_RX, GPS_TX);
  delay(300);
  uint32_t gpsFoundBaud = beginGnssAnyBaud();
  bool gnssDetected = gpsFoundBaud > 0;
  bool gpsL5Configured = gnssDetected && configureMgF10L5();
  if (gpsL5Configured) delay(600);  // GNSS 재시작 대기
  bool gps5HzConfigured = gnssDetected && configureMgF10FiveHz();
  Serial.printf("[GPS] L5 enable+health override=%s\n",
                gpsL5Configured ? "ACK" : "FAILED");
  Serial.printf(
    "[GPS] u-blox detected=%u, 5Hz config=%s, GGA+RMC, 115200bps (found %lu)\n",
    gnssDetected ? 1u : 0u,
    gps5HzConfigured ? "ACK" : "FAILED",
    (unsigned long)gpsFoundBaud
  );
  Serial.println("[GPS] ready: TX->GPIO16, RX<-GPIO17");
#endif
}

void recoverGps5HzIfNeeded() {
#if USE_GPS
  if (!gps5HzRecoveryRequested || relativeGpsCalibration.active) return;

  uint32_t now = millis();
  if (now < GPS_5HZ_RECOVERY_MIN_UPTIME_MS) return;
  if (lastGps5HzRecoveryAttemptMs > 0 &&
      now - lastGps5HzRecoveryAttemptMs <
        GPS_5HZ_RECOVERY_COOLDOWN_MS) {
    return;
  }

  lastGps5HzRecoveryAttemptMs = now;
  Serial.printf(
    "[GPS] observed %.0fms updates -> retrying 5Hz configuration\n",
    gpsObservedUpdateIntervalMs
  );

  bool recovered = configureMgF10FiveHz();
  Serial.printf(
    "[GPS] runtime 5Hz recovery=%s\n",
    recovered ? "ACK" : "FAILED"
  );

  // 재설정 뒤에는 실제 NMEA 간격을 처음부터 다시 측정한다.
  lastGpsMeasurementMs = 0;
  gpsObservedUpdateIntervalMs = 200.0f;
  if (recovered) gps5HzRecoveryRequested = false;
#endif
}

void updateDemoMovingFallback() {
#if USE_DEMO_MOVING_FALLBACK
  const float speedMps = 1.2f;
  uint32_t cycleMs = millis() % 16000UL;
  float offsetM = 16.0f - speedMps * (cycleMs / 1000.0f);
  if (offsetM < 0.5f) offsetM = 16.0f;

  float latRad = CANE_FIXED_LAT * DEG_TO_RAD;
  float metersPerDegLng = 111320.0f * cosf(latRad);

  vehicleLat = CANE_FIXED_LAT;
  vehicleLng = CANE_FIXED_LNG + offsetM / metersPerDegLng;
  vehicleSpeed = speedMps;

  // 데모 차량은 서쪽으로 이동한다고 가정.
  vehicleHeading = 270.0f;
  vehicleHeadingValid = true;

  vehicleGpsValid = 1;
  usingDemoGps = true;
#else
  vehicleLat = 0.0;
  vehicleLng = 0.0;
  vehicleSpeed = 0.0f;
  vehicleHeading = 0.0f;
  vehicleHeadingValid = false;
  vehicleGpsValid = 0;
  usingDemoGps = false;
#endif
}

void readGps() {
#if USE_GPS
  while (gpsSerial.available() > 0) {
    gps.encode(gpsSerial.read());
  }

  uint32_t now = millis();

  // GGA와 RMC에 둘 다 위치가 있으므로 RMC에서 속도와 함께
  // 갱신된 위치만 처리해 1회의 GPS fix를 두 번 카운트하지 않는다.
  if (gps.location.isUpdated() && gps.speed.isUpdated()) {
    updateObservedGpsRate(now);
    rawGpsLat = gps.location.lat();
    rawGpsLng = gps.location.lng();
    rawGpsSatellites =
      gps.satellites.isValid() ? gps.satellites.value() : 0;
    rawGpsHdop =
      gps.hdop.isValid() ? gps.hdop.hdop() : 99.0f;

    bool locationOk =
      gps.location.isValid() &&
      fabs(rawGpsLat) <= 90.0 &&
      fabs(rawGpsLng) <= 180.0 &&
      !(rawGpsLat == 0.0 && rawGpsLng == 0.0);

    rawGpsSpeedMps =
      gps.speed.isValid() ? gps.speed.mps() : 0.0f;
    rawGpsCourseValid = gps.course.isValid();
    rawGpsCourseDeg =
      rawGpsCourseValid ? gps.course.deg() : 0.0f;

    float rawSpeed = rawGpsSpeedMps;
    bool speedOk =
      gps.speed.isValid() &&
      rawSpeed >= 0.0f &&
      rawSpeed <= cfgGpsMaxSpeed;
    bool courseOk = rawGpsCourseValid;
    bool velocityOk = speedOk && courseOk;

    if (!locationOk || !gpsQualityIsGood()) {
      gpsQualityRejectedCount++;
      Serial.printf(
        "[GPS FILTER] quality rejected sats=%lu hdop=%.2f\n",
        (unsigned long)rawGpsSatellites,
        rawGpsHdop
      );
    } else {
      bool accepted = updateGpsFilter(
        rawGpsLat,
        rawGpsLng,
        rawSpeed,
        courseOk ? rawGpsCourseDeg : 0.0f,
        velocityOk,
        now
      );

      if (accepted) {
        if (speedOk) {
          vehicleSpeed =
            gpsAcceptedCount <= 1
              ? rawSpeed
              : 0.50f * vehicleSpeed + 0.50f * rawSpeed;
        }

        // GPS course는 차체 전방이 아니라 실제 이동 경로다.
        // 따라서 후진과 완벽하지 않은 직선 주행도 그대로 반영한다.
        if (courseOk &&
            rawSpeed >= cfgMinHeadingSpeed) {
          float rawHeading = rawGpsCourseDeg;
          bool previousCourseFresh =
            gpsMotionHeadingHasFix &&
            lastGpsMotionHeadingMs > 0 &&
            now - lastGpsMotionHeadingMs <=
              GPS_MOTION_HEADING_TIMEOUT_MS;

          gpsMotionHeadingDeg =
            previousCourseFresh
              ? blendHeading(gpsMotionHeadingDeg, rawHeading, 0.35f)
              : rawHeading;
          gpsMotionHeadingHasFix = true;
          lastGpsMotionHeadingMs = now;
          updateVehicleDriveModeFromGps(gpsMotionHeadingDeg);
        }
      }
    }
  }

  if (gpsFilter.initialized &&
      now - gpsFilter.lastFixMs <= cfgGpsFixMaxAgeMs) {
    projectGpsPosition(now, &vehicleLat, &vehicleLng);
    vehicleGpsValid = 1;
    usingDemoGps = false;
  } else {
    updateDemoMovingFallback();
  }
#else
  updateDemoMovingFallback();
#endif
}

// =====================
// ICM-20948 (IMU_CHIP_ICM20948 = 1일 때)
// =====================
// BNO055는 방향 계산과 보정을 칩 안에서 하지만 ICM-20948은 측정값만 준다.
// 그래서 여기서 방향(imuRawHeadingDeg)과 보정도(imuCal S/G/A/M)를 BNO055와
// 같은 뜻으로 만든다. 정렬·걸어서 정렬·뷰어 등 나머지 코드는 그대로 쓴다.
//   G: 가만히 있을 때 자이로 영점을 2초 이상 배웠으면 3
//   M: 자력계를 돌려 축마다 60uT 넘게 움직인 축 수(0~3). imusave 값을 불러왔으면 3
//   A: 공장 보정을 그대로 써서 늘 3,  S: G와 M 중 작은 값
// 방향은 보드 X축이 가리키는 방위(북 0, 시계방향 +)다. 보드가 기울어져도
// 중력으로 수평면을 잡아 계산한다. 장착 각도 차이는 imualign/imuwalk가 맞춘다.
#if IMU_CHIP_ICM20948
#define ICM_GRAVITY_MPS2 9.80665f
#define ICM_MAG_AXIS_RANGE_UT 60.0f
#define ICM_GYRO_LEARN_SECONDS 2.0f

float icmAccel[3] = {0.0f, 0.0f, 0.0f};    // m/s^2
float icmGyro[3] = {0.0f, 0.0f, 0.0f};     // dps, 영점 뺀 값
float icmMag[3] = {0.0f, 0.0f, 0.0f};      // uT, 가속도 축 기준, 영점 뺀 값
float icmLinear[3] = {0.0f, 0.0f, 0.0f};   // 중력 뺀 가속도(충격 판정)
float icmGravity[3] = {0.0f, 0.0f, ICM_GRAVITY_MPS2};
float icmGyroFast[3] = {0.0f, 0.0f, 0.0f};
float icmGyroBias[3] = {0.0f, 0.0f, 0.0f};
float icmMagMin[3] = {1e9f, 1e9f, 1e9f};
float icmMagMax[3] = {-1e9f, -1e9f, -1e9f};
float icmMagCenter[3] = {0.0f, 0.0f, 0.0f};
float icmGyroLearnedS = 0.0f;
float icmFieldUt = 0.0f;
float icmDipDeg = 0.0f;
bool icmMagCenterRestored = false;
bool icmFirstSample = true;
bool icmHeadingReady = false;
uint8_t icmAddress = 0;
uint32_t icmLastSampleMs = 0;

float icmDot(const float *a, const float *b) {
  return a[0] * b[0] + a[1] * b[1] + a[2] * b[2];
}

void icmResetCalibrationState() {
  for (int i = 0; i < 3; i++) {
    icmMagMin[i] = 1e9f;
    icmMagMax[i] = -1e9f;
    icmMagCenter[i] = 0.0f;
    icmGyroBias[i] = 0.0f;
  }
  icmMagCenterRestored = false;
  icmGyroLearnedS = 0.0f;
}
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
