joon722/AI-V2X-Cane/lux/state_store.py

#!/usr/bin/env python3
"""Keep the latest cane/vehicle record and report whether they can be paired."""

import argparse
import json
import sys
import time

from parse_v2x import SOURCE_MODES, normalize_record, serial_lines
from sim_vehicle import SPEED_MPS, START_DISTANCE_M, TestVehicle


FRESH_WINDOW_S = 0.5
TRACKED_TYPES = ("cane", "vehicle")


def has_position(row):
    """True when the record carries coordinates usable for distance math.

    gps_valid only reports the fix quality. The cane keeps sending its fallback
    coordinates while gps_valid=0, and those are still what step 5+ measures
    against, so trust source_mode for provenance and check the numbers here.
    """
    try:
        lat = float(row.get("lat", ""))
        lng = float(row.get("lng", ""))
    except (TypeError, ValueError):
        return False
    # (0, 0) is the usual "no fix" sentinel rather than a real location.
    return not (lat == 0.0 and lng == 0.0)


class StateStore:
    """Latest state per node type, with freshness judged against wall time."""

    def __init__(self, fresh_window_s=FRESH_WINDOW_S):
        self.fresh_window_s = fresh_window_s
        self.latest = {}

    def update(self, row):
        node_type = row["type"]
        if node_type not in TRACKED_TYPES:
            return False
        self.latest[node_type] = row
        return True

    def status(self, node_type, now):
        row = self.latest.get(node_type)
        if row is None:
            return "MISSING"
        if now - row["pc_time"] > self.fresh_window_s:
            return "STALE"
        return "READY"

    def snapshot(self, now=None):
        now = time.time() if now is None else now
        statuses = {node: self.status(node, now) for node in TRACKED_TYPES}
        pair_valid = all(status == "READY" for status in statuses.values())
        # Risk needs both positions, so a fresh pair without coordinates is not enough.
        risk_valid = pair_valid and all(
            has_position(self.latest[node]) for node in TRACKED_TYPES
        )
        return statuses, pair_valid, risk_valid


def format_snapshot(statuses, pair_valid, risk_valid):
    lines = [f"{node}={statuses[node]}" for node in TRACKED_TYPES]
    lines.append(f"pair_valid={pair_valid}")
    lines.append(f"risk_valid={risk_valid}")
    return "\n".join(lines)
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
