joon722/AI-V2X-Cane/(commit log)

2026-04-15 sumo 시뮬레이션 관련 파일
2026-04-15 트렌스포머 관련
2026-04-15 회의록 관련 장비 데이터 등
2026-04-16 테스트 야르
    ESP32 테스트코드
2026-04-27 Create 회의록
    한이음 미팅 회의록입니다
2026-04-27 Update 회의록
2026-04-27 Rename Docs to 사용장비 및 회의록
2026-04-28 Rename 사용장비 및 회의록 to 4.27 사용장비 및 회의록
2026-05-03 Create 5.3일 사용한 코드 들
2026-05-03 Create 5.3일 강현준 수신기 송신기 연결
2026-05-03 Update and rename Firmware to 260503.박중선
2026-05-03 Update 4.27 사용장비 및 회의록
2026-05-03 Rename 4.27 사용장비 및 회의록 to 사용장비 및 회의록
2026-05-03 Create 20240503 최민서
2026-05-04 Update 사용장비 및 회의록
2026-05-04 Update and rename 260503.박중선 to 박중선
2026-05-11 Create 5.10 수신기 코드
    수신 완료 코드
2026-05-11 사전 수행계획서
    공모전 사전 수행계획서 입니다.
2026-05-16 Create 5.10 송신기 코드
2026-05-17 csv, python 연결
2026-06-19 Organize Arduino code and docs
2026-06-23 Prevent receiver buzzer from sounding on boot
    [02_receiver_espnow_uart_actuator.ino]
2026-06-24 Add separated cane and vehicle V2X prototypes
2026-06-24 Add vehicle Jetson UART probe sketch
2026-06-24 Add Jetson UART vehicle risk probe
2026-06-24 Add RSU ESP-NOW Jetson bridge sketch
2026-06-25 Align cane endpoint with buzzer motor hardware
    [09_cane_v2x_status_alert.ino]
2026-06-25 Update 06_vehicle_v2x_gps_broadcast.ino
    리스크 설정 완료 보내고 받고
2026-06-25 Create 지팡이 양방향 테스트용
2026-06-25 Create 차량 양방향 테스트용
2026-07-01 Add Jetson risk inference
    [feature_9cols.csv, risk_result.csv]
2026-07-04 Update 지팡이 양방향 테스트용
    경고알림 후 risk0으로 떨어졌을 때 몇초 뒤 꺼지는지
    차량의 heading과 속도를 이용해서 지팡이를 향하고 있는지 계산
2026-07-12 Refactor event analysis system
    [event_result.csv, feature.csv, feature_with_zone.csv, zone_definition.csv, zoneszone_definition.csv]
2026-07-20 Implement automatic scenario generation pipeline
    - Added make_scenario.py
    - Automatic SUMO execution
    - Automatic preprocessing
    - Automatic AI inference
    - Automatic dataset merge
    [event_result.csv, feature.csv, master_dataset.csv, risk_result.csv]
2026-07-20 Add lux/ Linux risk engine for Jetson
    risk_engine.py and jetson_rsu_bridge.py with zone definition
    and sample input CSVs, for the Linux-side risk pipeline.
    [sample_risk_input.csv, zone_definition.csv]
2026-07-20 docs: 2026-07-20 작업 정리 추가 (강현준)
2026-07-20 docs: 작업일지를 팀원별 폴더 구조로 정리
2026-07-20 docs: 최민서 2026-07-20 작업 정리 추가
2026-07-21 Add Transformer training and ONNX deployment
    - Added Transformer training pipeline
    - Implemented label merging
    - Exported ONNX model
    - Added ONNX inference test
    - Prepared Jetson deployment files
    [labeled_master_dataset.csv]
2026-07-23 V2X 지팡이/RSU 위험도 파이프라인 (3~9단계) 및 위험도 예측 추가
    - step3~9: V2X 파싱/상태저장/차량 스트림/운동학/위험도 산정/전송/실측 검증
    - predict_risk, probe_risk_downlink: 위험도 예측 및 다운링크 프로브
    - 각 단계 단위 테스트 및 설계/계획 문서 포함
2026-07-23 Update 06_vehicle_v2x_gps_broadcast.ino
    DF player 포함
2026-07-23 refactor: V2X 파이프라인 파일을 lux/로 이동하고 단계번호 제거
    루트에 흩어져 있던 step3~9 스크립트를 lux/ 아래로 정리하고
    개발 순서(stepN) 접두어를 기능 기반 이름으로 변경:
    parse_v2x, state_store, sim_vehicle, kinematics, risk_scoring, send_risk
    모듈 간 import 참조를 새 이름으로 갱신, 테스트 99개 통과 확인.
2026-07-23 Update 09_cane_v2x_status_alert.ino
    지팡이노드 야외 테스트
2026-07-23 Update 09_cane_v2x_status_alert.ino
    일단 ttc 배제하고 거리로만(3,5,8) 위험도 판단
2026-07-23 Update 06_vehicle_v2x_gps_broadcast.ino
    일단 ttc배제하고 거리로만 위험도 판단
2026-07-23 Update 06_vehicle_v2x_gps_broadcast.ino
    소리조절기능
2026-07-24 Update 06_vehicle_v2x_gps_broadcast.ino
    GPS 이동 방향은 저속에서 흔들리지 않게 유지
    차량에서 지팡이까지의 방위각 계산
    지팡이가 차량 전방 ±45도 안인지 판단
    지팡이별 거리 기록을 분리
    접근속도를 필터링
    전방에서 가까워질 때만 TTC 활성화
    GPS 끊김과 지팡이 연결 만료 시 이전 TTC 기록 초기화
    선택적으로 TTC 수치까지 지팡이에 전송
    이 전부가 한 세트로 들어간다.
2026-07-24 Update 09_cane_v2x_status_alert.ino
    지팡이 GPS 상태 전송
    ↓
    차량이 거리·방향·접근속도·TTC 계산
    ↓
    차량이 지팡이 ID를 지정해 위험 패킷 전송
    ↓
    지팡이가 risk + distance + closing speed + TTC 수신
    ↓
    차량 계산 결과를 우선해 진동·부저 작동
    ↓
    직접 위험 패킷이 끊기면 지팡이 자체 계산으로 전환
    ↓
    차량 통신도 끊기면 SAFE로 해제
2026-07-24 Update 09_cane_v2x_status_alert.ino
    RISK_SAFE
    모터: OFF
    부저: OFF
    RISK_CAUTION
    모터: 0.5초 ON → 1.5초 OFF 반복
    부저: OFF
    RISK_WARNING
    모터: 0.4초 ON → 0.4초 OFF 반복
    부저: OFF
    RISK_DANGER
    모터: 0.15초 ON → 0.15초 OFF 반복
    부저: 0.1초 ON → 0.2초 OFF 반복
2026-07-26 docs: 신규 팀원용 인수인계 자료 추가 (시스템·코드 설명서, 연결구조 PPT)
    - AI_V2X_시스템_인수인계_report.pdf: 9단계 구조, RSU 상세, 위험도 판정 위치, 서버·SUMO 연동
    - AI_V2X_코드_설명서_report.pdf: 파이썬 파일별 입력·출력·핵심 동작·다음 단계
    - AI_V2X_연결구조_다이어그램_report.pptx: 하드웨어·SUMO/AI·서버 연결 다이어그램(편집 가능)
    - README.md: 읽는 순서와 핵심 요약, 알려진 정합 이슈
2026-07-30 Fix RSU bridge protocol mismatch with v2 nodes
    - V2X_VERSION 1 -> 2: match cane/vehicle nodes (header drop 원인)
    - v2x_risk_message_t에 distance_m/closing_speed_mps/ttc_s 추가:
    지팡이가 위험 경고 패킷을 크기 불일치로 거부하지 않도록 통일
    [10_rsu_espnow_multi_jetson_bridge.ino]
2026-07-30 서버/위험지도 파트 코드 추가 (FastAPI + Cloud Run + 도로 스냅)
2026-07-30 Add RSU replica files (v2x pipeline, logs, ONNX model)
    [final_risk_log.csv, labeled_master_dataset.csv, onnx_risk_result.csv, scenario_front_approach.csv, scenario_front_clean.csv, scenario_high_risk.csv, scenario_safe_pass.csv, scenario_side_blindspot.csv]
2026-07-31 Update cane_bt_debug.ino
    gps오류 보정
2026-07-31 Update car_bt_debug.ino
    gps 오류 보정
2026-08-01 Update cane_bt_debug.ino
    3차 패치
2026-08-01 Update car_bt_debug.ino
    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
2026-08-01 rsu: 로컬 작업본 반영 - step6/step8 수정, 젯슨 자동실행 구성, 신규 도구 추가
    - step6_kinematics, step8_send_risk, step3_parse_v2x, v2x_realtime_risk_engine 수정
    - test_step6_kinematics 테스트 보강
    - deploy/: 젯슨 systemd 자동실행 구성 (risk engine service, log upload timer, udev rules)
    - auto_pipeline/, tools/udp_telemetry_logger, v2x_bridge.ino 추가
    [rssi_0731_1614.csv, v2x_risk_log.csv]
2026-08-02 시뮬레이션 위험지도 페이지 추가 (static/sim.html)
    클라우드 자동 생성 SUMO 시나리오 248개(307만 행)를 팀 채점표로
    재계산해 실제 도로망(roads.json) 위에 누적한 정적 지도 페이지.
    - sim_data.json: 도로 구간 165개 집계(레벨별 건수·평균 점수·평균 TTC)
    + 위험구역 4곳. 좌표는 SUMO 궤적-도로망 ICP 정합 기반 근사
    (중앙오차 약 3.4m) — net.xml <location> 확보 시 정식 변환으로 교체 예정
    - sim.html: index.html과 같은 시각 언어(Leaflet·등급 색상·상세 카드)의
    단독 정적 페이지. DB·API 불필요, /static/sim.html로 바로 열림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
2026-08-03 Update cane_bt_debug.ino
    imu방향 추가
2026-08-03 Update car_bt_debug.ino
    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
2026-08-03 lux: rsu 폴더의 최신 수정사항 이식
    - kinematics.py: GPS (0,0) 무효 처리 등 step6 최신 변경 반영
    - send_risk.py: 위험도 CSV 로그 컬럼 확장 (distance_m, closing_mps, ttc_s, risk_score, 노드 상태) - 기존 RSU ACK 처리는 유지
    - parse_v2x.py: hdop, gps_time_ms 필드 추가
    - test_kinematics.py: 테스트 보강 (85개 테스트 통과 확인)
    [kinematics.py, parse_v2x.py, send_risk.py, test_kinematics.py]
2026-08-03 step8 위험도 안정화(히스테리시스) 추가 + RSU ACK 레코드 처리 통일
    - step8_stability.py: LevelStabilizer - 위험도 상승은 즉시, 하강은 hold_s 유지 후 반영
    - step8_send_risk.py: stabilizer 통합 (--level-hold-s 옵션), RSU ACK(risk_tx 등) 레코드 경고 없이 무시
    - lux/: send_risk.py 동기화, stability.py + test_stability.py 이식 (113개 테스트 통과)
    - sim.html, sim_data.json: 시뮬레이션 시각화 추가
    [send_risk.py, stability.py, step8_send_risk.py, step8_stability.py, test_stability.py, test_step8_stability.py]
2026-08-04 docs: 포트폴리오용 README 개편 및 잡파일 정리
    - README.md를 영어 소개 문서로 개편 (아키텍처 다이어그램, AI 성능, 저장소 구조)
    - README.ko.md 한국어 버전 추가
    - 기존 설치 안내는 docs/SETUP.ko.md로 이동
    - SUMO_project_backup.lnk 추적 해제, .gitignore에 *.lnk·tmp/ 추가
2026-08-04 docs: 팀 표에 저장소 소유자 역할 강조
2026-08-04 chore: rsu/v2x 폴더와 중복인 압축 사본 제거
    rsu/v2x_all.tgz(1.9MB)는 rsu/v2x/에 이미 풀려 있는 내용의 아카이브라 제거
2026-08-04 docs: 폴더별 README 추가 (8개)
    AI_Model·lux·scripts·dataset·zones·Simulation·v2x-server·rsu 각 폴더에
    목적, 파일 구성, 파이프라인상 위치를 설명하는 README 추가
2026-08-04 docs(ai-model): Transformer risk classifier — architecture & metrics
2026-08-04 docs(scripts): SUMO → labeled dataset pipeline
2026-08-04 docs(dataset): 78k-frame scenario data & label distribution
2026-08-04 docs(rsu): field-work archive — current code lives in lux/
2026-08-04 docs: polish hero section — centered title & badges
2026-08-04 feat(rsu): 위험 이벤트 업로더 - 젯슨에서 riskmap-api로 자동 전송
    - upload_events.py: 레벨 1+ 이벤트만 선별해 POST /api/events (10초 스로틀,
    오프셋 기억, 오프라인 재시도, event_uid 멱등)
    - step8 CSV에 cane_lat/cane_lng 추가, systemd 타이머(1분) + install.sh 반영
    - PC에서 실서버 검증 완료 (테스트 이벤트 -> 지도 집계 반영 확인)
2026-08-05 feat(simulation,rsu): 클라우드 자동 생성 서버 + Jetson DCPA 게이트 파이프라인
    - Simulation/cloud_server: SUMO 자동 생성기·디스크 정리·위험지도 데이터 추출 (cron 무인 운영)
    - auto_pipeline: DCPA(최근접 예상 거리) 게이트 적용 — 스쳐 가는 차 오경보 58.7%→18.1%,
    실제 5m 이내 접근 차량은 100% 유지. dcpa_m/gate_factor/원본 판정 컬럼 보존
2026-08-05 docs,sim: SUMO 실행 설정 파일 + 진행현황·모델설명·DCPA 결과 공유 문서
    - sumo_config: 서버 재현에 필요한 config/net/route (XML 문법 수정본 포함)
    - docs: 파트 진행현황, 위험채점표·Transformer 설명, DCPA 게이트 전후 비교 PDF
2026-08-05 sync_to_riskmap.py 추가 (VM 30분 자동 축적), 지도 탭 명칭 변경, 위험구역 표시 제거
2026-08-05 50m 스냅 게이트 + 5km 지역 필터 적용, DB 커넥션 풀 도입, unsnapped 건수 노출
2026-08-05 Leaflet 자체 서빙 전환 (unpkg 의존 제거), 최소 인스턴스 1 적용
2026-08-05 Update car_debug_V3
    rssi값 보정
2026-08-05 Update cane_debug_V3
    rssi 보정
2026-08-06 브리지를 노드 펌웨어 v3(36바이트)에 맞춤
    지팡이/차량이 V2X_VERSION 3에 heading_valid를 추가하면서 상태 패킷이
    35 -> 36바이트가 되었는데 브리지가 v2/35바이트라, 수신 콜백이 버전과
    길이 양쪽에서 노드 패킷을 전부 버리고 있었다. 지팡이가 젯슨 로그에
    한 줄도 안 잡히고 RSU risk 다운링크도 노드에서 폐기되던 원인이다.
    구조체 크기를 static_assert로 고정해 다음에 어긋나면 컴파일에서 잡히게
    했고, 노드가 보낸 heading_valid도 버리지 않고 젯슨으로 넘긴다.
2026-08-06 step8에 노드 자체 risk 기록과 raw 로그 저장 추가
    지팡이는 max(자체판단, 차량risk, RSU risk)를 브로드캐스트하므로,
    그 값을 우리가 보낸 값 옆에 적어두면 다운링크가 실제로 수신·반영됐는지
    한 파일에서 읽을 수 있다. CSV에 cane_node_risk/veh_node_risk를 넣고
    [TX] 콘솔 출력에도 함께 표시한다.
    시리얼 포트가 하나라 별도 프로그램으로 통신을 엿볼 수 없어, --raw-log로
    오간 줄을 방향 표시와 함께 원문 그대로 남긴다. 파싱에 실패한 줄도
    남겨야 원인을 알 수 있으므로 기록은 파싱보다 먼저 한다.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
2026-08-06 실험 진단 도구 3종 추가
    watch_link.py 최근 2초 수신을 요약해 실험 가능 상태인지 판정
    check_bridge.py 범위 밖 risk 값에 브리지가 반드시 회신하는 성질을 이용해
    노드가 모두 꺼져 있어도 브리지 생존을 판별
    analyze_log.py 실험 한 세트의 GPS 품질/좌표 튐/다운링크 반영률/접근속도
    오차를 요약. 접근속도는 지팡이가 대부분 정지해 있어
    움직인 구간만 따로 본다
2026-08-06 feat(ai): 3초 선행 예측 모델 v2·v3 — 물리 외삽 하이브리드, 선행 시간 중앙값 4초
    - v2: 벡터 특징 16개 재학습 (보행자 실좌표, 차량경계·평가누수 버그 수정)
    - v3: 라벨을 '향후 3초 내 최대 위험'으로 — 물리 외삽 특징 3개 추가한 하이브리드
    - 검증(미학습 60개 시나리오): 미래 L3 검출 91.7% (물리 단독 44%),
    위험 발생 중앙값 4초 전 경고 (물리 1초), L3→안전 오판 0건
    - Jetson auto_pipeline v3 전환 배포, 학습·평가 스크립트와 모델 동봉
2026-08-06 feat(docs): 3초 선행 예측 시각화 뷰어 — 정확도·기법 기여 비율 표시
    - 단일 HTML(오프라인 실행): 시뮬레이션 재생 + 예측/물리/실제 3선 비교 그래프
    - 예측↔3초 뒤 실제 일치율, 선행 시간 음영, 물리:AI 보정 비율 표시
    - make_prediction_viewer.py로 다른 시나리오 결과에서도 재생성 가능
2026-08-06 feat(simulation): 시나리오 생성기 v2 — 현실성 다양화
    - net_v2: 인도 자동 생성(121→448) + 횡단보도 추가 (차량이 보행자에게 실제 양보)
    - 보행자: 시나리오마다 랜덤 3~10명, 경로·출발 무작위 (기존: 고정 1명)
    - 운전 성향: 조심/보통/공격 3종을 시나리오별 랜덤 비율 배합
    - Jetson 파이프라인: 차량별 최근접 보행자 기준으로 특징 계산 (다수 보행자 지원)
    - META 파일로 생성기 버전·성향 비율 기록 (v4 재학습 시 필터링용)
2026-08-06 docs: 8/6 작업 요약 — v3 예측 완성·시나리오 v2·팀원 전달사항
2026-08-06 TTC 임계값 연구와 안전 하한 추가 (rsu + lux 양쪽)
    기존 AI 모델의 학습 라벨이 팀 점수표에서 나와 규칙을 복사하는 구조였다.
    build_training_dataset.py와 AI_Model/transformer/build_v3_and_baseline.py가
    모두 라벨을 점수표 x DCPA게이트로 만들어, v1에서 v3까지 모델만 좋아지고
    정답지는 바뀌지 않았다. scaler.json 입력에 risk_score가 있어 라벨 누수도 있다.
    규칙과 독립된 정답(미래 최소거리 오라클)을 만들고 세 방법을 같은 정답,
    같은 오경보 예산으로 비교했다. 시나리오 1200개 x 5시드.
    현 점수표 적시경보 66.6% 오경보 1.99%
    TTC<=3.0s 적시경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
2026-08-06 논문 「최적의 TTC는 존재하지 않는다」와 생성 스크립트 추가
    연구 결과를 논문 형식으로 정리했다(8쪽). 초록, 문제 진단, 방법, 실험 결과,
    실기 반영, 논의와 한계, 결론, 참고문헌, 재현 부록으로 구성했다.
    핵심 주장은 임계값 최적화가 성립하지 않는다는 것이다. 모델이 탐지한 위험의
    34%가 TTC 무한대 상태에서 발생했고(측면 53%, 후방 75%), 이는 임계값을 어떤
    값으로 두든 탐지되지 않는다. 척도 자체가 그 위험을 표현하지 못한다.
    그림 3장을 함께 넣었다. 오경보 대비 적시경보 트레이드오프, 상황별 경보
    프로필, 예측 창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
2026-08-06 실험 검증 스크립트와 실험 계획 추가
    GPS 5Hz 전환 후 측정된 로그가 없어 안전 하한 2.0초의 전제가 미확인 상태다.
    8/5 로그로는 936ms(1.1Hz)였고, 그 조건에서 필요한 하한은 2.8초다. 다만 하한을
    2.8초로 올리면 오경보만 4.69%로 늘고 적시경보는 개선되지 않는다(63.2%). GPS
    주기가 병목이므로 하한이 아니라 GPS를 고쳐야 하는 문제다.
    verify_experiment.py는 raw 로그 하나로 네 가지를 한 번에 판정한다.
    GPS 갱신 주기, 안전 하한 발동, 모델 검증용 표본 수량, 규칙 대비 섀도우 비교.
    EXPERIMENT_PLAN.md는 세 목적을 한 실험으로 달성하는 절차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
2026-08-06 watch_link에 실험 진척 2행 추가
    실험이 끝난 뒤에야 성패를 아는 상황을 피하려고, 현장에서 확인해야 할 셋을
    2행에 담았다.
    GPS 실제 주기 step7의 안전 하한 2.0초는 5Hz(200ms)를 전제로 계산한 값이다.
    1Hz면 필요한 하한이 2.8초가 되어 전제가 무너지므로, 5Hz가
    아니면 "!"를 붙여 눈에 띄게 했다. 좌표가 바뀐 간격만 세야
    GPS 주기가 나온다 - 노드는 같은 좌표도 10Hz로 재전송한다.
    근접 이벤트 모델 검증에는 차량 3 m/s 이상에서 2m 이내 접근이 30건 이상
    필요하다. 몇 건 모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
2026-08-06 AI 판정을 실기 파이프라인에 연결
    최종 레벨 = max(안전 하한, 규칙 점수, 모델). 세 층이 서로를 덮어쓰지 않는다.
    안전 하한은 모델보다 세고(모델은 학습 분포 밖에서 조용히 틀리지만 하한은 물리로
    계산한 값이다), 모델은 규칙 레벨을 낮추지 못하며(검증되지 않은 쪽이 검증된 쪽을
    무르게 만들지 않는다), 모델이 없거나 예외를 던져도 규칙 판정은 그대로 나간다.
    젯슨에 아무것도 설치하지 않는다. 트리 앙상블을 JSON으로 덤프하고 표준
    라이브러리만으로 추론한다(model_runtime.TreeEnsemble). sklearn 예측과의 최대
    오차는 2.22e-16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
2026-08-06 인수인계 및 현황 평가 문서 추가 (docs)
    다음 작업 세션이 이 문서 하나로 맥락을 복원할 수 있게, 그리고 팀이 읽고 역할을
    나눌 수 있게 6쪽으로 정리했다.
    현황과 평가 AI를 어디까지 믿을 수 있는가를 항목별로 나눴다. 시뮬레이션 성능,
    안전 구조, 배포 안정성은 높음. 실측 검증은 낮음(9스텝), 학습 분포
    밖 거동은 미지. 신뢰할 수 없는 것도 명시했다.
    코드 평가 연구(PC)와 배포(젯슨)를 분리한 구조, 검증 수준, 알려진 위험 지점
    셋(모델 버전 관리 부재, 롤백 절차 미문서화, 비공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
2026-08-06 논문: TTC를 폐기하자는 주장이 아님을 명시
    제목만 보면 "TTC를 버려라"로 읽혀 오해를 부른다는 지적을 받았다. 본문은
    이미 안전 하한 2.0초를 TTC로 정의하고 있으나, 초록과 결론에서 그 관계를
    분명히 하지 않았다.
    초록에 한 문단을 넣었다. TTC가 매우 작을 때는 반박할 수 없는 위험 신호이므로
    안전 하한으로 최하층에 배치했으며, TTC는 위험의 충분조건이 아니라 하한을
    규정하는 신호로 쓰인다는 것.
    결론에도 같은 취지를 덧붙였다. 달라진 것은 TTC의 지위다 - 위험을 판정하는
    단일 기준에서, 하한을 규정하는 여러 신호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
2026-08-06 공모전 전략 문서 추가, 실험 계획에 눈가리개 측정 반영
    기술 지표는 경쟁권인데 전달 준비가 없다는 판단에서, 기술 문서와 분리해 전략만
    따로 정리했다(4쪽).
    자체 평가 항목별 100점 환산. 기술력 90, 수행능력 92, 기획력 87. 문제해결
    능력은 최상위일 가능성 - 함정 7개를 발견에서 재측정까지 기록했다.
    치명적 약점 실증이 사실상 없음(실외 데이터 1개, AI 반응 9스텝), 당사자 검증
    부재, 하드웨어 신뢰성. 심사에서 답하기 어려운 질문 4개도 정리.
    대체 방안 시각장애인 섭외가 어려우면 팀원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
2026-08-06 다음 작업 지시서 — 시뮬레이션과 실시간 연결 (zone_base_risk)
    젯슨에서 두 흐름이 돌고 있으나 서로 연결되어 있지 않다. 시뮬레이션이 3초 앞을
    예측해도 그 결과가 지팡이 판단에 아무 영향을 주지 않고 지도에만 그려진다.
    받을 자리는 이미 있다. step7_risk.calculate_risk_score의 zone_base_risk 인자로,
    0~5점을 쓸 수 있게 설계되어 있는데 step8이 넘기지 않아 항상 0이다.
    process_scenarios.py도 "SUMO에 구역 정보가 없어 0을 쓴다"고 적어두었다.
    다만 지금 바로 값을 넣으면 근거 없는 가중치가 된다. "교차로니까 +5점"을 주려면
    교차로에서 실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
2026-08-07 feat(ai): v4 재학습 — 현실성 v2 시나리오 433개 (보행자 다수·양보·성향 배합)
    - 현실 세계는 더 어려움: 물리 기준선 83.9%→43.8%로 하락한 환경에서
    v4는 78.7% 달성 (v3-on-현실 51.6% 대비 대폭 회복, 물리 대비 1.8배)
    - 미래 L3 재현율 85.3% / 시연 시나리오(미학습) 일치율 86.7%
    - 배포: Jetson 가중치 교체(파일명 유지), v2 시나리오 전체 v4 재추론 중
    - 뷰어를 미학습 시나리오(scenario_1494) 기준으로 갱신
2026-08-08 sync: .csv 형식 지원 및 cleanup 삭제 경합 대응
2026-08-12 fix(ai,sim): 팀 리뷰 반영 — TTC 죽은 특징 수정 + 캠퍼스 내부 차량 추가
    - [강현준 리뷰] person_id 버그: 최근접 보행자 교체 시 다른 사람과의 거리를
    미분해 가짜 접근속도 -> TTC 1.6e8 폭주로 특징 사망. 같은 (차량,보행자)
    쌍 안에서만 미분하도록 수정 + TTC 30초 클램프 + ttc_valid 특징 추가 (20개)
    - 생성기 v2.1: randomTrips 차량을 캠퍼스 내부 도로 포함 전 지역에 추가
    (--prefix campus_로 id 충돌 해결), 운전 성향 배합 적용
    - 데이터셋 빌더(로컬/Jetson)·파이프라인 동일 수정 반영
2026-08-12 보행 안전 인터페이스(drive.html) 추가, 갱신 시각 KST 표시, sync .csv 형식 지원
2026-08-12 feat(ai): v4.1 — TTC 특징 복구 재학습 + 캠퍼스 차량 뷰어
    - scaler ttc mean 1.6e8 -> 26.3 (팀 확인법 통과, 특징 복구)
    - 미래 위험(L3) 재현율 85.3% -> 91.0%, 위험을 안전으로 놓침 7% -> 2.1%
    - 뷰어: 캠퍼스 내부 차량 포함 신규 시나리오(미학습) 기준 재생성
2026-08-12 feat(ai): 실측 주행 검증 파이프라인 — 주행 로그 하나로 실환경 예측 정확도 측정
    - step3 로그(차량+지팡이 GPS) -> 1초 정리 -> 좌표변환 -> 20특징 -> v4 예측
    - 예측 vs 실제 3초 뒤 대조: 일치율·사전 검출률·선행 시간 리포트 자동 출력
    - 뷰어/지도 적재용 real_result.csv 생성, 워밍업 패딩 적용
    - 사용: python real_validate.py 주행로그.csv
2026-08-13 경보에 TTC 30초 상한 신설 + 안전 하한 2.8→2.0초 (GPS 5Hz 확정)
    8/12 실측: 경보 1004건 중 74%가 접근 없음(TTC 9999/30s+) — 거리 항
    30점만으로 레벨1 기준을 넘던 것. TTC>30s면 규칙 레벨 0(ttc_capped),
    안전 하한(TTC<=2.0 -> 레벨3)이 상한보다 우선. 모델은 상한 무관.
    어제 데이터 재생: 경보 82%→16%, 실제 접근(TTC 3.7~9.1s) 미탐 0.
    GPS_PERIOD_S 1.0→0.2는 8/12 밤 GCS 원시데이터로 5Hz 확정에 따름.
    TtcCapTest 6건 추가, 8/13 젯슨 배포·실기 검증 완료. (rsu 5d2648d 동일본)
2026-08-13 노드 UDP 텔레메트리 기록기 추가 (젯슨 상주형 + PC형)
    지팡이(4210)/차량(4211)이 V2X-LOG로 뿌리는 "이름:값" UDP 방송을
    듀얼시리얼기록 호환 포맷(raw.log + 값기록.csv)으로 저장.
    - telemetry_recorder.py: 젯슨 상주형 (crontab @reboot 등록용)
    - v2x_recorder.py: PC(노트북)형 (런 라벨 인자, Ctrl+C 종료)
    [telemetry_recorder.py, v2x_recorder.py]
2026-08-13 도플러 속도를 칼만필터에 관측으로 융합 (유령 접근속도·속도 지연 대책)
    rsu 저장소 동일 변경. 지팡이=영속도 관측(ZUPT, <0.45m/s),
    차량=heading_valid일 때 전체 벡터 관측. step3에 heading_valid
    통과 추가. 테스트 7건 추가.
2026-08-13 fix(jetson): 연속 추론 사이 2초 휴식 — 장시간 부하로 인한 전원 차단 방지
2026-08-13 8/12~13 야외 실측 데이터 추가 (수정 전/후 판정 CSV + 원시 로그)
    젯슨 판정 CSV 15개(원본) + 핵심 세션 raw 로그 5개(gzip, 33MB->2.6MB).
    8/12 = TTC 상한 없던 수정 전(오경보 93% 실측), 8/13 = 수정 후 검증.
    세션별 내용과 컬럼 설명은 data/field_20260812_13/README.md 참조.
    [risk_tx_20260812_193237.csv, risk_tx_20260812_194240.csv, risk_tx_20260812_195447.csv, risk_tx_20260812_195600.csv, risk_tx_20260812_195704.csv, risk_tx_20260812_201937.csv, risk_tx_20260812_201948.csv, risk_tx_20260812_203823.csv]
2026-08-13 chore(jetson): 어댑터 교체 후 추론 휴식 2.0->0.5초 완화
2026-08-14 생성기 v3(진짜 교내 주행) + 모델 v5 재학습·배포
    - 교내 도로 개방: net_v2/net_clean의 highway.service 486차선에 passenger 추가
    - generate_scenarios.py v3: campus_* 차량은 캠퍼스 service 도로 랜덤워크(교외 이탈 불가),
    교외 차량은 기존 경로 풀 랜덤 샘플, 교내:교외 비율 시나리오마다 랜덤(1:2~1:20, META 기록)
    - 번호 재사용 버그 수정: .scenario_counter 영속 카운터 (cleanup의 문자열 정렬 keep-30로
    10xxx 전부 삭제 시 번호가 10000으로 되돌아가던 문제)
    - v5 재학습: 교내 시나리오 700개 중 300개(1.29M행)로 학습 (build_dataset_v5/train_v5)
    동일 교내 테스트: 정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
    [scenario_9380_pedestrian.csv, scenario_9380_result.csv]
2026-08-14 실시간 연동 API 추가 (/api/live, /api/live/latest), 보행 안전 인터페이스 drive.html 추가
2026-08-15 rsu 미러 동기화: 8/7~8/10 개선분 + 차량뷰 8080 서버 (joon722/rsu 68d54ce 기준)
    rsu/v2x/03_jetson 사본이 8/13 이후 부분 미러(step7·8·3·6·기록기)만 받아
    joon722/rsu와 갈라져 있던 것을 맞춘다. 젯슨에서 실제로 도는 코드와 동일.
    - deploy/upload_events.py: 서버가 400/422로 거부한 행은 건너뛰어 뒤 행이 막히지 않게 (SKIP)
    - deploy/run_v2x_risk_engine.sh: V2X_NO_MODEL=1 이면 규칙만 (실험 기준선용)
    - scripts/watch_link.py: T_FLOOR_TTC_S를 step7에서 직접 읽음, 잘린 첫 줄 버림
    - scripts/diagnose_upload.sh, auto_pipeline/{gps_noise,diagnose_pipeline,validate_csv}.py + 테스트
    - test_model_gate.py: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
    [live_server.py, live_state.py]
2026-08-15 chore(rsu): step6_kinematics.py 줄바꿈 CRLF→LF (내용 변경 없음, joon722/rsu 동기)
2026-08-15 rsu 미러: 차량 1인칭 실시간 화면용 상대좌표 배관 (joon722/rsu 84c52e1 동기)
    step8 CSV에 veh_lat/veh_lng·rel_east_m/rel_north_m 추가, stream_live 가 vehicle에
    상대좌표 실어 서버로 push. 채린 서버가 이 필드를 받아 차량뷰 렌더에 사용.
    test_stream_live 포함(이전 veh_lat 누락 실패 1건 해소).
2026-08-15 rsu 미러: 견고성 패치(핫루프 예외격리+모델로드 폴백) — joon722/rsu d2da6e3 동기
2026-08-16 범례 문구를 3초 내 예상 위험 등급으로 변경 (v3 이후 예측 기준 반영)
2026-08-17 drive.html: 내 차가 화면 밖에 그려지던 문제 수정 (MY_CAR_Z 2.2→4.0, preserveAspectRatio xMidYMax)
    MY_CAR_Z=2.2면 내 차가 SVG y=620~794에 그려져 viewBox(높이 620) 밖으로 통째로 잘림.
    4.0으로 올리고 넓은 화면에서 하단 대신 하늘 쪽이 잘리도록 xMidYMax slice 적용.
    1280x635 기준 내 차 192px 중 150px 표시 확인. 그 외 변경 없음. (현준, 채린 코드 5131e19 기반)
2026-08-17 Revert "drive.html: 내 차가 화면 밖에 그려지던 문제 수정" — 06dd20d 되돌림, 채린 5131e19 상태로 복원
2026-08-17 drive.html: 차량 시점 화면 테슬라 스타일로 개선 (3차선 가운데 차로 + 파란 주행 라인 + 매트 은회색 차)
    - 도로를 3차선으로, 내 차는 가운데 차로 중앙에 배치(중앙선 위 걸침 문제 해결)
    - 황색 중앙선/보도/가로등 제거, 내 차로 좌우에 파란 글로우 차선(테슬라 주행경로) 추가
    - myCarShape 재작성: 넓고 낮은 자세, 뒷펜더 볼륨, 매트 은회색, 가로 테일라이트 바
    - 데이터 로직(pollLive/pedPosition/render) 불변, 그리기만 교체. (현준)
2026-08-17 drive.html: 테슬라 차량뷰 복원 + 폴링 0.25s (배포본이 옛 5131e19로 되돌아간 것 복구)
    - MY_CAR_Z 4.0, 3차선 가운데 차로, 파란 주행 라인, 매트 은회색 차
    - 폴링 500ms->250ms (라이브뷰 저지연). 데이터 로직 불변, 그리기/폴링만. (현준)
2026-08-17 rsu 誘몃윭: ���젽���뒯 ���떎���떆媛꾩꽦쨌���뙋���젙 媛쒖꽑 4嫄��� (joon722/rsu 8d5dae7 ���룞湲��� 쨌 洹쇱젒���븯���븳/TTC���룊���솢/heartbeat/stream_live 8080)
2026-08-17 data: 듀얼시리얼기록 현장 실험 데이터 추가 (GCS records 버킷 백업)
    hanium-ssu-kpc-records 버킷의 듀얼시리얼기록 437파일(≈77MB)을 data/에 백업.
    8/1·8/8 시나리오별(정지/접근/side-by-side 보정 등) 값기록.csv + 지팡이/차량
    _raw.log. raw 로그는 .gitignore(*.log)에 걸려 -f로 포함.
    [값기록.csv, 지팡이_값기록.csv, 차량_값기록.csv]
2026-08-17 rsu 미러: 유령 접근·TTC 플래핑 대책 + 차량 heading 유지 (joon722/rsu f5f2187 동기)
    8/17 오후 실측 반영. 재생 검증에서 정지 중 유령 L3 25/26/12/13건 → 0,
    재획득 직후 L3 전부 0, 등급 변경 69→53·27→10·38→32·20→11, 실제 접근 검출 유지.
    - step6: 트랙 재시작 간격 10→2s, 재시작 후 1s 수렴 게이트, 초기 속도
    불확실도 10→3 m/s, GPS 점프 게이트(예측 위치에서 7.5m+노드속도·dt·1.5)
    - step7: MIN_CLOSING_MPS 0.5 데드밴드(near_floor 유지)
    - live_state/stream_live: 차량 heading 마지막 유효값 유지 + heading_valid 전파
    (drive.html 방향 튐 원인 — 서버 NodeState에 head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
2026-08-17 data: 8/17 젯슨 현장 테스트 로그 101파일 추가 (≈81MB)
    오늘 촬영/튜닝 세션의 젯슨 로그. raw_20260817_*.log 89개 + risk_tx_20260817_*.csv 12개.
    근접하한/TTC평활/바이어스 제거 전후 판정, 브리지 접촉불량·지팡이 재부팅 구간 포함.
    raw는 .gitignore(*.log)에 걸려 -f로 포함.
    [risk_tx_20260817_103809.csv, risk_tx_20260817_111216.csv, risk_tx_20260817_122247.csv, risk_tx_20260817_141209.csv, risk_tx_20260817_145152.csv, risk_tx_20260817_172101.csv, risk_tx_20260817_174054.csv, risk_tx_20260817_174249.csv]
2026-08-17 rsu 미러: 노이즈 주입층 — 시뮬 참값 궤적 → RSU 패킷 스트림 (joon722/rsu 0452ec0 동기)
    gps_noise.FieldNoiseParams/noisify_track (float32 양자화·무효/재획득 점프·heading 규칙·
    5/10 Hz 반복, 환경 의존값은 randomized 범위) + sim_to_rsu_stream.py (생성기 v3 →
    raw 로그 형식 스트림 + 참값 CSV) + 테스트 24. 민서용 스펙은 설명서/노이즈주입_스펙_20260817.md.
2026-08-17 rsu 미러: build_dataset_from_streams (잡음 스트림→실행 특징→경보 모델 학습셋) — joon722/rsu b8ff33c 동기
2026-08-17 rsu 미러: build_dataset_from_streams t_hit·적시경보율 지표 (joon722/rsu 71b33bd 동기)
2026-08-17 rsu 미러: build_dataset_from_streams 시나리오 가족(--families) (joon722/rsu 1636866 동기)
2026-08-17 rsu 미러: step7 근접 하한 2.5 m·접근 시만 (joon722/rsu 2c28ec6 동기)
2026-08-17 rsu 미러: 가족 비율 재조정 (joon722/rsu 004efd0 동기)
2026-08-17 rsu 미러: step6 도플러 융합 문턱 0.25 (joon722/rsu 9e383fe 동기)
2026-08-18 SUMO v3 시나리오 학습 공장 투입 결과 + 경보 transformer + GPS 잡음 옵션 (현준 부탁 ①②③)
    ① SUMO 700개 x 최근접 2쌍 = 1,401 스트림 + scenario_sim 4000 → 트리:
    적시경보 전체 55.3%→61.7% / SUMO 53.9%→69.1% / scenario_sim 61.0%→31.7% (실차 쏠림, 실기 배포 불가)
    ② train_alarm_transformer.py (15열·y_train·시나리오 단위 적시경보율·ONNX):
    전체 56.6%→54.6% (규칙 미달), 같은 쏠림 → 데이터 배합이 먼저
    ③ build_dataset_local.py GPS_NOISE 옵션 (build_dataset_v5.py --gps-noise), σ2.5m 검증
    - sumo_batch_to_streams.py: 시나리오당 참값 최근접 쌍 자동 선택 (기본 첫 id는 hit 0)
    -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
2026-08-18 docs: SUMO 학습 공장 투입 결과 팀 공유용 PDF
2026-08-18 fix(auto_pipeline): scenario_id瑜��� str濡��� ���넻���씪 ��������� --streams+--from-scenario-sim ���룞���떆 ���븰���뒿 ���떆 split_by_scenario sorted(ids) str/int TypeError ���닔���젙 (誘쇱꽌 蹂닿퀬 6���젅 踰꾧렇, ���쁽以�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
2026-08-18 (a) SUMO 축소 8:2 배합 → RC에서 규칙 이김, risk_model_streams_82.json 배포 후보
    현준 지시대로 (a)만: SUMO 1쌍x90(위험 75) + scenario_sim 4000(위험 274).
    적시경보 전체 55.2→62.9% / RC 58.0→61.7% (이전 31.7%) / SUMO 45.8→66.7%.
    쏠림 해소, RC 오경보 2.23→2.03%. 문서·PDF 갱신.
2026-08-18 현준 지시 ①② — 82 모델 실측(8/17) 채점 + GPS 튐 강조 재학습(배포 불가)
    ① field_score_82.py: 실측 raw 로그 → stream_to_features(젯슨 실행 경로) → 규칙 vs 모델.
    대본 라벨 저장소에 없어 휴리스틱 접근 에피소드로 채점 (--labels 입구 마련).
    9세션 130,843행: 82 ≈ 규칙 (경보 1.12 vs 1.32%, 정지 오경보 0.13% 동일, 검출 34 vs 37/108).
    ② run_with_gps_jump.py (FieldNoiseParams.randomized 몽키패치, 팀 코드 무수정) + --gps-jump:
    82jump 시뮬 RC 62.7%로 비슷하나 실측 정지 오경보 0.13→2.64% 폭증 → 배포 불가.
    82는 이미 randomized로 튐 분포를 배운 상태였음.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
    [field_score_0817.csv, field_score_0817_jump.csv]
2026-08-18 rsu 미러: step7/8 도플러 물리 클램프(3 s 피크홀드) + 무음 뒤 홀드 시효 만료 (joon722/rsu 43faad2 동기) — 8/18 재생: 정지 유령 3→0, 실접근 유지
2026-08-18 rsu 미러: step6 동결 좌표 처리(동일 좌표 반복 무시·차량 ZUPT·도플러 추측항법) (joon722/rsu 5040eff 동기) — 8/18 재생: 유령 9→1, 등급변경 96→67
2026-08-18 rsu 미러: 경보 해제 — 멀어지면 즉시 해제·홀드 2→1 s (joon722/rsu 4304ae6 동기)
2026-08-19 rsu 미러: 경보 해제 0.6 s 유지 (joon722/rsu 동기)
2026-08-19 rsu 미러: 거리추세 저속접근 토글(기본 OFF) (joon722/rsu 동기)
2026-08-19 rsu 미러: watch_risk 방향 라벨 거리추세
2026-08-19 rsu 미러: RSSI×GPS 방향 융합(젯슨, 기본 무동작)
2026-08-19 feat(fw): car/cane V4 추가 (rssi_distance_m, 40B 프로토콜)
    V3는 유지, V4 신규. 차량=지팡이 직접 RSSI 추정거리를 젯슨으로 전송, 지팡이=-1(미측정). 8/18 패치(매분 5Hz 재설정 정지 버그 수정, 브라운아웃 완화) 포함.
2026-08-20 rsu 미러: step8 GPS 공백 다운링크 유지 + verify_experiment 배포하한 (joon722/rsu 3afd836 동기)
    8/19 코너테스트 P2 개선안. 근접 통과 중 차량 GPS가 ~3.9초 모션 무효가 되면
    compute()가 None을 내고 다운링크가 끊겨, 노드가 RSU 타임아웃(3s)으로 아직
    유효한 경보를 조기 해제했다.
    - step8: GAP_HOLD_CAP_S=3.0 + _heartbeat_through_gap(). 공백 동안 마지막 레벨을
    하트비트로 유지하고, 상한 초과 시 0으로 정리. 0이면 예전 동작.
    - test_step8_gap_hold 신규, --no-fusion 플래그 파싱 테스트 추가.
    - verify_experiment: 판정 기준을 safety_floor 상수가 아니라 배포본
    step7_risk.T_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
2026-08-20 data: 젯슨 로그 8/19 (raw 7 + risk_tx CSV 5, 56MB)
    8/19 실험 전체 세션의 젯슨 원시 로그와 다운링크 CSV.
    - 07:26 / 07:47 / 09:30 / 09:51 / 11:55 / 19:12 / 19:55 세션
    - 09:51 세션: 지팡이 GPS 콜드스타트 22분(13330패킷 gps_valid:0) 뒤 획득
    - 19:12 / 19:55: 코너테스트 2회(규칙 판정·RSU 융합) 및 차량 노드
    V2X_VERSION 불일치 트리아지 구간
    무결성: 젯슨 원본과 md5 12/12 일치 확인(raw는 CR=0으로 바이트 동일,
    risk_tx CSV는 기록 시 CRLF라 커밋 시 LF로 정규화됨 — 내용 동등).
    [risk_tx_20260819_074726.csv, risk_tx_20260819_093002.csv, risk_tx_20260819_095121.csv, risk_tx_20260819_191212.csv, risk_tx_20260819_195543.csv]
2026-08-20 rsu 미러: verify_experiment 낡은 주석 수정 (joon722/rsu c0d86df 동기)
    주석이 GPS 1Hz 시절 상태로 남아 있었다("safety_floor는 2.0, 배포본은 2.8").
    8/12 5Hz 확정으로 배포본 하한도 2.0이 되어 지금은 둘이 일치한다. 갈라지는
    경우(1Hz 복귀 시 배포본만 2.8)를 명시했다. 주석만 수정, 동작 변경 없음.
2026-08-22 Add DWM3001CDK ranging and calibration to V4
2026-08-25 data: 젯슨 로그 8/18·8/20·8/22·8/25 (raw + risk_tx CSV, 117MB)
    젯슨 ~/v2x/03_jetson/logs 백업. 8/18(오후 실험·클램프) 11개,
    8/20(GAP_HOLD 검증일) 28개, 8/22(UWB 작업) 1개, 8/25(브리지 트리아지) 13개.
    젯슨 디스크 97% 도달 — 정리 전 전체 백업 목적.
    [risk_tx_20260818_153015.csv, risk_tx_20260818_164431.csv, risk_tx_20260818_165415.csv, risk_tx_20260818_170119.csv, risk_tx_20260820_155419.csv, risk_tx_20260820_155544.csv, risk_tx_20260820_155657.csv, risk_tx_20260820_160045.csv]
2026-08-25 rsu 미러: UWB 거리 융합·실내 UWB-only + step8 DTR/RTS 해제 (joon722/rsu 2d1d8f6 동기)
    - step3/step8/bridge/run 래퍼: UWB 4필드 파싱, 실외 융합·실내 UWB-only,
    MSG_UWB_RANGE(38B) 수용, --no-uwb 플래그 (rsu b30cb5c)
    - step8: 시리얼 오픈 시 DTR/RTS 해제 — ESP32 자동리셋 방지 (rsu 2d1d8f6)
    - test_step8_uwb.py 15케이스 신규
2026-08-25 docs: README에 실물 사진·현장 데모 섹션 추가 (영/한)
    야외 실험 장비(RC카+지팡이 노드+젯슨), AI 위험맵, 실시간 판정
    모니터(LV0→LV3 에스컬레이션) 3장. docs/images/ 신설, 각 ~300KB.
2026-08-25 rsu 미러: 12k 재학습 모델·재생채점 도구 (rsu bba36a4 동기) + 8/25 risk_tx CSV 최신화
2026-08-25 rsu 미러: 시나리오 보존 정리 retention.py (joon722/rsu a9946be 동기)
    젯슨 디스크 98% 해소 — 업로드 완료분 최신 2000개 유지, .purged.list로
    rsync 재수신 차단. 실배포 결과: 10,255개 삭제·31GB 확보·재수신 0건 검증.
2026-08-26 docs: 담당 파트 기술 보고 PPT (13장) — 생성·예측 원리, 실물 캡처, 핵심 코드 포함
2026-08-26 docs: 기술 보고 PPT를 한이음 공식 양식(파란 블록·로고 프레임)으로 재구성
2026-08-26 docs: 기술 보고 PPT에 예측 알고리즘 전개도 슬라이드 추가 (사용자 수정본 기반)
2026-08-26 docs: 보고 PPT 마지막 장을 '산출물과 결론(구현 완료)'로 교체
2026-08-27 rsu 미러: DCPA_FAR 7.5→4.5m (rsu 35d8249 동기)
2026-08-27 rsu 미러: step8 UWB rel 스케일 (rsu 1db8cc2 동기)
2026-08-29 docs: 현장 결과 시각화(실측 접근 타임라인·거리별 위험 분포) + data/ 주석 + README 연결
2026-08-29 ops: 라이브뷰(stream_live) 재기동 런처 start_live.sh
2026-08-29 fix(docs): SVG 차트에 width/height 명시 (GitHub에서 300px로 작게 나오던 것 → 폭 채움)
2026-08-29 docs: 팀에 박채린(웹·클라우드) 추가 + 4인 팀 반영 + docs/ README 신설
2026-09-19 data: 9/19 입력 끊김·복구 통제 실험 기록과 버킷 미반영 노드 세션 24개 추가
    - data/젯슨로그_20260919: 젯슨 raw 로그, 실시간 판정 CSV, 조작 시각 마커, README
    - data/듀얼시리얼기록: GCS hanium-ssu-kpc-records와 대조해 빠져 있던 24개 세션 추가
    (8/19·8/20 시험 5개, 8/22 UWB 18개, 9/19 연속 기록 1개). 파일 크기는 버킷과 전부 일치.
    9/19 세션의 raw 로그 2개는 용량 때문에 .log.gz(원본 sha256은 README에 기재하지 않고 복원 검증만 함)
    - data/README.md: 세션 표에 9/19 추가, 노드 기록 세션 수 95 -> 118
    [markers_20260919_121439.csv, risk_tx_20260919_095416.csv, 지팡이_값기록.csv, 차량_값기록.csv]
2026-09-19 data: 9/19 README의 시계 차이와 접근 주행 설명 정정
    로그 사건 기준으로 다시 맞춘 결과, 마커는 약 4초가 아니라 약 1초 늦게 찍혔고
    접근 주행 어느 회차에서도 차량 노드 재부팅은 없었다.
2026-09-19 data: 9/19 README의 통신 가림 수치를 6회 전체 분석값으로 정정
2026-09-19 data: 로컬에만 있던 젯슨 기록 91개 추가, CSV 49개를 원본 바이트 그대로 재저장
    - data/젯슨로그_20260801_03, 0805, 0808, 0810, 0812, 0813, 0814, 0826, 0827:
    저장소 어디에도 없던 젯슨 raw 로그·판정 CSV·초기 실험 CSV 91개(0바이트 파일 42개는 제외)
    - 앞 커밋에서 줄바꿈 자동 변환(CRLF->LF)으로 바뀌었던 값기록.csv 48개와 마커 CSV 1개를
    변환 없이 다시 저장해 버킷·젯슨 원본과 바이트까지 일치시킴
    - data/README.md: 세션 표에 새 날짜 폴더 추가
    [exp_8.1_1차실험.csv, exp_8.3_1차실험.csv, exp_8.3_2차_방향성체크.csv, exp_8.3_방향성2차.csv, exp_8.3_방향성3차.csv, exp_8.3_방향성실험.csv, markers_20260919_121439.csv, risk_tx_20260805_185724.csv]
2026-09-30 Add V5 firmware for upgraded GNSS IMU and UWB
2026-10-01 Sync Claude-reviewed V5 firmware from authoritative competition folder
    Preserve the competition firmware folder as the source of truth. Add AoA diagnostics, GPS L5 configuration, IMU polling changes, updated defaults, and the generated web_page.h. Keep V2X v3 packet layouts at 40/38/35 bytes; the RSU AoA document is a proposal only. All four board sketches compile successfully.
2026-10-01 firmware: V5를 car_firmware·cane_firmware 폴더로 정리하고 최신본으로 교체
    - PR #7(오전 V5)을 정리: arduino/car_bt_debug → arduino/car_firmware, arduino/cane_bt_debug → arduino/cane_firmware (V2~V5 그대로 옮김)
    - c33_uwb_bridge_V5.ino → car_firmware, stella_uwb_responder_V5.ino → cane_firmware (새로 생긴 두 폴더 없앰)
    - car_debug_V5.ino·cane_debug_V5.ino 최신본: 버튼(GPIO33, 2초) 차량 = GPS 영점(cal), 지팡이 = 걸어서 방향 정렬(imuwalk)
    - 차량 웹페이지를 .ino 안에 넣어 web_page.h 삭제 (V5도 버전마다 .ino 한 파일)
    - 내부용 문서(변경 기록·뷰어 요청서·RSU 제안서)는 저장소에서 빼고, 설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
2026-10-01 firmware: V5 차량에 UWB 정면 맞추기 추가
    - uwb front (뷰어 차량 패널 'UWB 정면 맞추기' 버튼): 지팡이 든 사람이 차 정면에 서 있는 동안 각도 25개 평균을 정면(0°)으로 저장. 처음 한 번만 하면 됨 (uwb front 0 = 삭제)
    - uwbflip (0/1): 실물 시험에서 오른쪽이 -로 나오면 1로 바꿔 '차 기준 오른쪽 +'로 맞춤
    - UWB각도 로그는 차 기준 값(정면·부호 반영), 상세 모드에 UWB원시각도, 두 모드에 UWB정면보정·UWB정면보정중·UWB정면표본 추가
    - 차량 물리 버튼은 그대로 GPS 영점(cal)
    - 내장 웹뷰어: UWB 줄에 정면 맞춤 상태, 차량 빠른 버튼에 UWB 정면 맞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
2026-10-02 firmware: V5 GPS를 KoA M9N 기준으로 — 보드레이트 자동 찾기
    - 실물 GPS가 KoA M9N 퍽(u-blox M9N, JST-GH 6핀)으로 바뀜. 판매처 사양 기본 115200
    - setupGps(): 115200에서 못 찾으면 38400(u-blox 공장값) → 9600에서 찾아 GPS UART1을 115200으로 바꿈(RAM, 켤 때마다). 부팅 로그 '[GPS] u-blox detected=…, (found 찾은 속도)'
    - MG-F10을 쓰면 전과 똑같이 동작(115200에서 바로 찾음, L5 ACK). M9N은 L1 전용이라 'L5 … FAILED'는 정상
    - V5_BRINGUP_AND_CALIBRATION.md GPS 절을 M9N 기준으로
    - 컴파일 확인: 차량 83%, 지팡이 76%
    [cane_debug_V5.ino, car_debug_V5.ino]
2026-10-05 rsu: 다중 차량 추적 — 차량 node_id마다 step8 한 벌(차선)로 따로 판정
    차가 2대 이상이면 step4 StateStore의 "vehicle" 한 칸을 서로 덮어써서
    step6 칼만이 두 차를 섞고(가짜 접근속도·TTC) 한 대만 추적되던 문제.
    - step8_multi_vehicle.py(신규): 지팡이 행은 모든 차선, 차량·uwb 행은
    자기 차선으로. 지팡이엔 차선 등급 최댓값 방송(--downlink max, 기본).
    per-target(차마다 target_id)은 브리지가 target_id를 지원해야 사용 가능.
    차가 1대면 기존 step8과 등급 변화 시점까지 동일(테스트로 고정).
    - step8_send_risk.py: build_parser()/open_bridge_serial() 분리만(동작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
    [per_vehicle.csv]
2026-10-05 auto_pipeline: 다중 차량 평가에 SUMO 위험 라벨 기준 추가
    - sim_multi_vehicle_stream.sumo_labels(): v2~v5 학습 라벨과 같은 식
    (build_dataset_local 채점표 x DCPA 게이트, 참값 1 Hz)을 (차, 지팡이
    보행자) 쌍마다 적용 + risk_level_future3. build_scenario와 2,593행 100% 일치.
    - eval_multi_vehicle.py: 라벨 구간 검출률·선행시간, 차선 등급 vs 그 차
    라벨(초 단위), 라벨 근거 없는 경보(기존/다중/차별 단독 최댓값).
    - 300묶음: 라벨 L3 구간 199개 검출 기존 20.6% -> 다중 91.5%,
    L2+ 665개 25.4% -> 85.3%. 차선 등급 = 차 단독 판정(수치 동일).
    라벨 근거 없는 경보 1.03% -> 5.32%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
    [per_label_run.csv, per_vehicle.csv]
2026-10-05 deploy: 기본 엔진을 다중 차량 추적(step8_multi_vehicle)으로
    - run_v2x_risk_engine.sh: 기본이 step8_multi_vehicle.py. V2X_MULTI_VEHICLE=0
    이면 예전 step8_send_risk.py(차량 칸 하나). 차가 한 대면 판정은 동일.
    - 결과 문서: 안전 하한(TTC 하한 아래면 DCPA 게이트 무시)은 의도된 규칙으로
    유지한다고 정정 - 다중 추적은 그 규칙을 차마다 똑같이 적용할 뿐.
2026-10-05 auto_pipeline: 다중 차량 추적 뷰어(HTML 한 장) 추가
    make_multi_vehicle_viewer.py -> 다중차량추적_뷰어.html (예측 뷰어와 같은 형식,
    더블클릭으로 열기). SUMO 동시 접근 장면 8개를 기존 엔진(차량 칸 하나) vs 다중
    엔진으로 재생: 지도(보행자 추적, 차 색 = 차별 위험도), 지팡이 경보 비교 +
    SUMO 라벨 L2+ 음영, 차별 위험도 vs 그 차 라벨. 상단 타일은 300묶음 평가 수치.
    클라우드 불필요 - PC의 v5data로 생성.
2026-10-11 docs: 내부 문서(회의록·작업일지·수행계획서·신청서식) 정리
2026-10-11 docs: 개인정보·소속 식별 정보 정리
    - 코드 주석·문서의 팀원 이름을 파트명(통신/AI/HW/웹 담당)으로 변경, README 팀 표는 역할만 표기
    - 학교명·장비 계정명·클라우드 프로젝트명 등 소속을 연상시키는 표현 제거
    - 위험지도 이미지를 지명 라벨이 보이지 않는 버전으로 교체
    - 내부 전략 문서 삭제, scenarios/minseo_outputs → sim_outputs
2026-10-15 chore: 식별 정보 2차 정리 (서버 계정·장소 라벨·이미지)
    - 서버 접속 계정을 환경변수 V2X_SERVER로 바꿈 (jetson_fetch.sh, process_scenarios.py, upload_logs.sh, diagnose_upload.sh). install.sh 템플릿·v2x-log-upload.service·설치 안내도 함께
    - Cloud Run 주소를 환경변수 RISKMAP_URL로 바꿈 (install.sh, sync_to_riskmap.py, seed_events.py 예시)
    - SUMO 망 파일 생성 기록의 PC 사용자 경로는 파일 이름만 남김
    - 좌표에 붙은 장소 라벨과 구역 이름을 기능 이름(출입구·사각 교차로·보행구역 등)으로 바꾸고, 문서의 실험 장소 표현을 정리. 데이터 CSV·sim_data.json의 구역 이름도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
2026-10-18 firmware: V5 IMU를 ICM-20948로 되돌림 (BNO055 응답 없음)
    - 차량·지팡이 V5에 IMU_CHIP_ICM20948 스위치 추가(기본 1). 0이면 BNO055 그대로.
    - ICM-20948: 자이로+자력계로 방향 계산, 보정도 S/G/A/M을 BNO055와 같은 뜻으로 만듦.
    imusave/imureset/imualign/imuwalk와 뷰어는 그대로 동작.
    - 설명서 IMU 배선·보정 절차를 ICM-20948 기준으로 갱신.
2026-10-18 firmware: V5 C33 UWB 세션 시작 결과·측정 상태 출력, 상대 주소 고정
    - init()/start() 반환값을 USB에 SUCCESS/FAILED로 찍고, 실패하면 세션을 시작한 것으로 보지 않음.
    - 1초마다 session·init·start·마지막 측정 status·raw_cm·peer 주소를 함께 출력.
    - PortentaUWBShield 1.0.2에서 controller의 상대(0x2222) 주소가 임시 객체를 가리키던 문제를
    전역 responderAddress로 다시 묶어 고정.
    - 기본 로그를 UWB_INFO_LEVEL로 USB에 출력.
2026-10-22 v2x-server: 위험지도 배포본과 동기화 (도로 우선순위 TOP5 지도·/api/live/push 복구)
    10/20~21에 이 폴더로 --source 배포를 하면서 사이트의 index.html·main.py가
    9/5 이전 버전으로 돌아갔다. 10/23 배포본(리비전 00052)과 같게 맞춘다.
    - static/index.html: 현장 실측 / AI 예측 탭, 도로명 단위 우선순위 TOP5, WAY_NAMES
    - main.py: POST /api/live/push (노드 배열 10Hz 수신) 복구
    - static/drive.html: 10/21 위치 표시 수정본
2026-10-22 v2x-server: index.html을 실제 서비스본(8/31 OSM 지도)으로 맞춤
    b768035에서 올린 9/5 회색 위성지도판은 배포 3분 만에 되돌려져
    실제로 서비스된 적이 없다. 9/5~10/20 동안 사이트가 쓰던 8/31판
    (OSM 지도·현장 실측 / AI 예측 탭·TOP5)으로 바꾼다. 10/23 배포본(리비전 00054)과 같다.
2026-10-22 docs(v2x-server): README를 실제 서버 상태에 맞게 수정
    - 스냅 상한 300m → 50m (roads.py MAX_SNAP_DISTANCE_M 기본값)
    - 빠진 파일 추가: static/drive.html(차량 1인칭 실시간 화면), sync_to_riskmap.py
    - main.py 역할에 지도 집계·실시간 상태 API 명시, index.html에 탭·TOP5 명시
    - "젯슨 업로드 연결은 로드맵" 문구 수정: upload_events.py(/api/events)와
    stream_live.py(/api/live)로 이미 올리고 있음
2026-10-22 v2x-server: HTML 응답에 Cache-Control: no-cache
    헤더가 없으면 브라우저가 Last-Modified로 보관 기간을 어림잡아,
    재배포 뒤에도 몇 시간 동안 옛 index.html을 보여 줬다(10/23 실제로 겪음).
    HTML만 매번 재확인하게 하고, 안 바뀌었으면 ETag로 304가 나가므로 부담은 작다.
    JS·이미지·API 응답은 그대로 둔다. 배포본(리비전 00056)과 같다.
2026-10-22 drive.html: 실내 시연(5 m 이내) 거리 배율 + heading_valid 기준 회전
    - 실제 1 m를 화면 4 m로 그린다(VIEW_K). 야외용 원근 그대로면 1~5 m가
    화면 아래 좁은 띠에 몰려 1 m와 5 m가 거의 구별되지 않았다.
    이제 0.5 m는 차 바로 앞, 5 m는 도로 위쪽에 작게 보인다.
    - 젯슨 UWB 실내 경로는 차량 이동방향이 '지금' 유효할 때만 그 방향으로 돌려
    상대좌표를 만들고 아니면 0을 쓴다. 화면은 마지막 유효 방향으로 되돌리고 있어,
    차가 한 번이라도 움직인 뒤에는 정면 보행자가 옆으로 그려질 수 있었다.
    heading_valid=false면 0으로 되돌린다(값이 없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
